mauroleme/radiation-pattern-measurement-system/docs/README.md

# Documents

| Folder | Contents |
|---|---|
| [`report/LEEC_project_report_Mauro_Leme.pdf`](report/LEEC_project_report_Mauro_Leme.pdf) | **Final LEEC project report (PDF, 105 pages)** |
| [`report/latex`](report/latex) | LaTeX source of the report (English, IPB template `ipb.cls`). Main file `relatorio.tex`, chapters in `chapters/`, the code listed in the appendices in `codes/`, every figure in `Imagens/`. Build: `pdflatex relatorio && bibtex relatorio && pdflatex relatorio && pdflatex relatorio`, or upload the folder to Overleaf |
| [`proposal`](proposal) | Original project proposal |
| [`papers/sasyr-2025`](papers/sasyr-2025) | Short paper *"Development of a 2-DoF Antenna Radiation Measurement System"* (Springer LLNCS LaTeX source + PDF) and the conference poster |
| [`papers/teem-2025`](papers/teem-2025) | Full paper *"Two-Axis Computerised Antenna Radiation Pattern Measurement System"* (revised version) |
| [`presentation`](presentation) | Slides of the project defence (18/09/2025, Portuguese) |

Report structure: 1 Introduction · 2 State of the art (commercial systems: MegiQ RMS-0460, Diamond D6050, MWF, S7601A) · 3 Materials and methods (mechanics, electronics, software, Yagi-Uda design, balun and matching network) · 4 Results (component characterisation, pattern measured in four configurations, 3D) · 5 Conclusions and future work · Appendices A-E (MATLAB, Arduino and `Joint` class code, balun script).
