mauroleme/radiation-pattern-measurement-system/media/README.md

# Photos and videos

- [`photos`](photos): the platform (front/back/side views, top and bottom sections, the electronics in the base), the Yagi-Uda prototype, the matching PCB and the outdoor measurement set-up (August 2025). `.heic` files are original phone photos.
- [`videos`](videos), stored with **Git LFS** (click a file and then *View raw* / *Download*):
  - `Record_2025_05_29_17_27_11_112.mp4`: the system running a measurement (29/05/2025)
  - `video_20250414_172635.mp4`: test from 14/04/2025
  - `motor_test.mp4`, `motor_test_2.mp4`: early stepper motor tests
