mauroleme/radiation-pattern-measurement-system/docs/report/latex/acronym.tex

\newacronym{API}{API}{Application Programming Interface}
\newacronym{TI}{TI}{Tecnologias da Informação}
\newacronym{ESTiG}{ESTiG}{Escola Superior de Tecnologia e Gestão}
\newacronym{EMS}{EMS}{Electromagnetic Simulation}
\newacronym{ISM}{ISM}{Industrial, Scientific and Medical}
\newacronym{DC}{DC}{Direct Current}
\newacronym{AC}{AC}{Alternating Current}
\newacronym{RF}{RF}{Radio Frequency}
\newacronym{VNA}{VNA}{Vector Network Analyzer}
\newacronym{RSSI}{RSSI}{Received Signal Strength Indicator}
\newacronym{GNU}{GNU}{GNU's Not Unix}
\newacronym{SDR}{SDR}{Software Defined Radio}
\newacronym{PVC}{PVC}{Polyvinyl Chloride}
\newacronym{CAD}{CAD}{Computer-Aided Design}
\newacronym{IEEE}{IEEE}{Institute of Electrical and Electronics Engineers}
\newacronym{PLA}{PLA}{Polylactic Acid}
\newacronym{DIP}{DIP}{Dual In-line Package}
\newacronym{IO}{I/O}{Input/Output}
\newacronym{I2C}{I2C}{Inter-Integrated Circuit}
\newacronym{DUT}{DUT}{Device Under Test}
\newacronym{UART}{UART}{Universal Asynchronous Receiver-Transmitter}
\newacronym{IDE}{IDE}{Integrated Development Environment}
\newacronym{FDM}{FDM}{Fused Deposition Modelling}
\newacronym{BALUN}{BALUN}{Balanced-Unbalanced Transformer}
\newacronym{PCB}{PCB}{Printed Circuit Board}
\newacronym{CNC}{CNC}{Computer Numerical Control}
\newacronym{SAW}{SAW}{Surface Acoustic Wave}
\newacronym{EIRP}{EIRP}{Effective Isotropic Radiated Power}
\newacronym{VSWR}{VSWR}{Voltage Standing Wave Ratio}
