mauroleme/radiation-pattern-measurement-system/docs/report/latex/chapters/apendice02.tex

\chapter{Main Control System Code
(Arduino)}
\label{apendice2}

This appendix presents the source code developed for the main control of the system
using the Arduino Uno. The full source code for this project is available at:\\ https://github.com/mauroleme/radiation-pattern-measurement

\lstinputlisting[language=Arduino, caption={Arduino main control}, label={lst:ino_main}]{codes/main.ino}
