mauroleme/radiation-pattern-measurement-system/docs/report/latex/chapters/apendice03.tex

\chapter{Joint Class Header File (C++)}
\label{apendice3}

This appendix presents the header file developed for the implementation of the
\texttt{Joint} class used in the Arduino-based control system. The full source code for this project is available at: https://github.com/mauroleme/radiation-pattern-measurement

\lstinputlisting[language=cpp,
                 caption={Joint class header file},
                 label={lst:joint_h}]
{codes/joint2.cpp}
