mauroleme/radiation-pattern-measurement-system/docs/report/latex/chapters/apendice04.tex

\chapter{Joint Class Implementation File (C++)}
\label{apendice4}

This appendix presents the implementation file developed for the
\texttt{Joint} class used in the Arduino-based control system. The full source code for this project is available at:\\ https://github.com/mauroleme/radiation-pattern-measurement

\lstinputlisting[language=cpp,
                 caption={Joint class implementation file},
                 label={lst:joint_cpp}]
{codes/joint1.cpp}
