mauroleme/radiation-pattern-measurement-system/docs/report/LEEC_project_report_Mauro_Leme.pdf

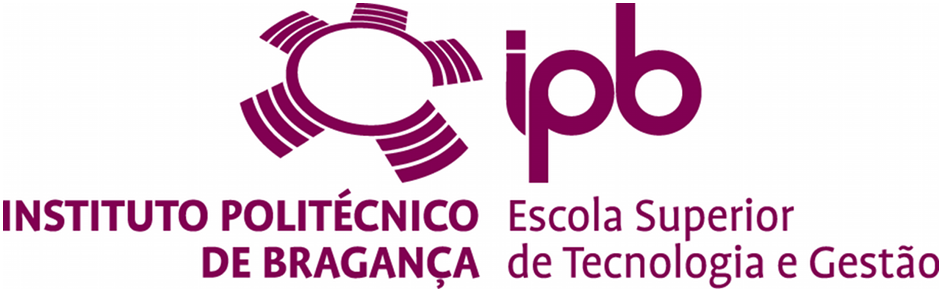
[picture p49: figure]

# Two-Axis Computerised Antenna Radiation Pattern Measurement System

Mauro da Silva Leme - 52965

Trabalho realizado sob a orientação de

Professor Doutor João Paulo Coelho

Licenciatura em Engenharia Eletrotécnica e de Computadores

2024-2025

# Two-Axis Computerised Antenna Radiation Pattern Measurement System

Relatório da UC de Projeto

Licenciatura em Engenharia Eletrotécnica e de Computadores

Escola Superior de Tecnologia e Gestão

Mauro da Silva Leme - 52965

2024-2025

A Escola Superior de Tecnologia e de Gestão não se responsabiliza pelas opiniões

expressas neste relatório.

Declaro que o trabalho descrito neste relatório é da minha autoria e é

da minha vontade que o mesmo seja submetido a avaliação.

Mauro da Silva Leme - 52965

# Dedication

I dedicate this work to my grandmother Benedita, who gave up her life for me and who,

wherever she may be, I know is happy with this moment.

vii

# Acknowledgement

The completion of this work would not have been possible without the contribution and

support of many people and institutions that, in different ways, have marked this stage

of my academic life.

Firstly, I would like to express my deepest gratitude to my supervisor and creator

of this project, Professor João Paulo Coelho, PhD, for his scientific guidance, constant

patience, sharing of knowledge, and dedication, which was reflected not only in the de-

velopment of this work, but also in my personal and professional growth.

I would also like to express my gratitude to João Alexandre Batista Coelho, MSc,

Laiany Suganuma Brancalião, MSc, and Mariano Alvarez, MSc, for their close support

during the different stages of the work, for their constructive suggestions and for their

contributions, not only technical but also personal, being present on various fronts of the

project and offering friendship, encouragement and continuous collaboration.

I would also like to thank Professor José Alexandre de Carvalho Gonçalves, PhD, for

his availability and for facilitating access to the IPB laboratories, often outside normal

working hours, as well as for his advice, which greatly enriched this journey.

To CeDRI and ESTIG, for their institutional support and provision of essential re-

sources, and to MORE CoLAB, in the person of Higor Rosse, for his collaboration in the

production of the PCBs.

To my classmates and colleagues from other IPB courses, for their encouragement

and support, and to the management of the Electrical and Computer Engineering de-

gree programme, for their dedication, guidance, and motivation conveyed throughout my

studies.

viii

Last but not least, I would like to express my heartfelt gratitude to my mother, my

brothers and sisters, and my friends for their unconditional encouragement, patience, and

understanding, which were indispensable in helping me achieve this goal. I would also

like to give special thanks to Thiago and Dayana, who have been a fundamental pillar

in my life over the years, offering constant support and true friendship. A deep and

loving thank you to Mary, my adoptive mother, who always believed in me, even when I

doubted myself, always encouraging me not only in my studies, but also in becoming a

better person. If I am who I am today, I owe it in large part to her unwavering confidence

and the support she never failed to give me.

ix

# Resumo

Compreender o padrão de radiação das antenas é essencial para otimizar os sistemas de

comunicação sem fios. Esse parâmetro descreve como a antena irradia ou recebe energia

eletromagnética no espaço, tais como a área de cobertura, a intensidade do sinal e as

interferências. Conhecer o padrão de radiação permite posicionar e orientar melhor as

antenas, minimiza as perdas de energia e melhora o desempenho geral do sistema.

Embora os softwares de simulação eletromagnética (EMS) possam estimar o padrão de

radiação durante a fase de projeto, os resultados práticos muitas vezes diferem das simu-

lações devido a influências ambientais. Reflexões, difrações e absorções podem distorcer

significativamente o que é idealizado. Como resultado, compreender o padrão de radiação

real é crucial para garantir um desempenho confiável em aplicações práticas.

No entanto, os equipamentos de medição de antenas comerciais são normalmente muito

caros, o que os torna impraticáveis para laboratórios educacionais. Neste contexto, este

trabalho propõe o desenvolvimento de uma configuração experimental de baixo custo para

medir padrões de radiação de antenas na banda Industrial, Científica e Médica (ISM). O

sistema permite o posicionamento automático de uma antena de prova segundo dois eixos,

habiltando a medição de padrão coplanar e cruzada assim como azimute e/ou elevação.

O controlo dos dois graus de liberdade, assim como a aquisição e visulização dos dados,

é realizado por um programa desenhado para correr no software MATLAB. A validação

experimental, com uma antena Yagi-Uda, mostrou boa concordância entre os resultados

medidos e simulados. Os resultados validam a operação do sistema desenvolvido.

Palavras-chave: Padrão de Radiação de Antenas, Radiação Eletromagnética, Meca-

trónica, Medição de Baixo Custo, Desempenho de Antenas.

x

# Abstract

Understanding the radiation pattern of antennas is essential for optimising wireless com-

munication systems. This parameter describes how an antenna radiates or receives electro-

magnetic energy in space, determining key aspects such as coverage area, signal strength,

and susceptibility to interference. Knowledge of the radiation pattern allows better place-

ment and orientation of antennas, minimises energy losses, and improves overall system

performance.

Although electromagnetic simulation (EMS) software can estimate the radiation pattern

during the design phase, practical results often differ from simulations due to environ-

mental influences. Reflections, diffractions, and absorptions can significantly distort the

idealised pattern. As a result, understanding the real radiation pattern is crucial to ensure

reliable performance in practical applications.

However, high-precision antenna measurement equipment is usually very expensive, which

makes it impractical for educational laboratories. In this context, this work proposes the

development of a low-cost experimental setup for measuring antenna radiation patterns

in the Industrial, Scientific, and Medical (ISM) band. The system integrates a two-axis

positioning mechanism, an Arduino-based control platform, a radio frequency power de-

tector, and a MATLAB interface for data acquisition and visualisation.

Experimental validation using a Yagi–Uda antenna showed good agreement between mea-

sured and simulated results. These outcomes indicate the viability of the developed setup.

Keywords: Antenna Radiation Pattern, Wireless Communication, ISM Band, Low-Cost

Measurement, Antenna Performance.

xi

xii

# Contents

1 Introduction | 1
2 State of the Art | 5
3 Materials and Methods | 15

xiii

4 Results | 41
4.4.4 | Antenna with Band-Pass Filter, Balun, and Impedance Matching
5 Conclusion and Future Work | 58

xiv

A Data Processing Script in MATLAB | A1
B Main Control System Code (Arduino) | B1
C Joint Class Header File (C++) | C1
D Joint Class Implementation File (C++) | D1
E MATLAB Code for Balun Calculation | E1

xv

# List of Tables

2.1 Comparison of Commercial Antenna Measurement Systems | 10
3.1 Element lengths and spacings for the Yagi-Uda antenna | 27
3.2 Final LC matching network component values | 38
3.3 Estimated cost of components used in the project | 40

xvi

# List of Figures

1.1 Overview of the complete antenna radiation pattern measurement system. | 2
2.1 MegiQ RMS-0460 Measurement System | | 7
2.2 D6050 Measurement System | | 8
2.3 Microwave Factory (MWF) Measurement System representation | | 9
2.4 S7601A Antenna Measurement System | 10

3.1 CAD model of the rotating platform with two degrees of freedom. Axis

“A” corresponds to the azimuth rotation and axis “B” to the perpendicular

rotation, which can be configured as the elevation axis | 16

3.2 Block diagram and photo of the electrical system, including key components

like the Arduino Uno, DRV8825 driver shield, power supply, sensors, RF

detector (AD8313), Device Under Test (DUT), stepper motors, and internal

wiring | 19

3.3 Detailed electrical schematic of the measurement system, illustrating com-

ponent interconnections and pin assignments | 21

3.4 Schematic showing the flow of the signal from generation to analysis. . . . 23

3.5 Yagi-Uda antenna simulated in CST Studio Suite | 27

3.6 Mechanical model of the antenna developed in SolidWorks and the con-

structed Yagi-Uda antenna prototype | 28
3.7 Characterisation of the antenna using the NanoVNA | 29
3.8 Characterisation of the air choke balun | 31

xvii

3.9 Photos of the air choke balun manufactured using RG174 cable, with 3D

printed support | 32
3.10 Measured S21 curve of the bare PCB with NanoVNA Saver | 33
3.11 CST Studio Suite simulation of the PCB | 33
3.12 QucsStudio simulation of the PCB: (a) model and (b) result | 34
3.13 Measured S-parameters of the PCB using NanoVNAsaver | 36
3.14 Validation of the Touchstone file in QucsStudio | 37
3.15 before impedance matching network | 37
3.16 Results of the optimised matching network | 38

3.17 PCB layout model in QucsStudio , design in EasyEDA, and photograph of

the manufactured | 39

4.1 Experimental setup for transmitting and receiving antennas, showing rear

and side perspectives | 43

4.2 S21 of the 868 MHz band-pass filter showing insertion loss and passband

characteristics | 45

4.3 Experimental S21 results for the air choke balun using VNA in differential

and common modes | 46
4.4 S11 graph and VSWR of the PCB used for impedance matching | 47
4.5 Comparison of real and simulated radiation pattern | 50

4.6 Comparison of real and simulated radiation pattern. Antenna with band-

pass filter | 51

4.7 Comparison of real and simulated radiation pattern. Antenna with band-

pass filter and balun | 52
4.8 Measured data with filter, balun and impedance matching | 53
4.9 Simulated radiation pattern outcome from CST Studio Suite | 54
4.10 Measured 3D radiation pattern | 55
4.11 Simulated 3D radiation pattern from CST Studio Suite | 55

xviii

# Chapter 1

# Introduction

## 1.1 Work Description

Over the past few decades, the fast development of wireless communication technologies

has reinforced the importance of antennas as fundamental components of transmission

and reception systems. A key parameter in antenna characterisation is the radiation

pattern, which reveals how electromagnetic energy is distributed in space. Understanding

and measuring this pattern is essential for evaluating antenna performance, optimising

coverage, and ensuring efficient energy transfer.

Existing commercial setups offer high accuracy, but are financially impractical for

educational laboratories. For undergraduate environments, where the primary objective

is to support teaching and provide hands-on experience, the investment in such equipment

is frequently unjustifiable. In this context, the development of low-cost and custom-

made solutions becomes relevant, enabling students to gain practical insights into antenna

behaviour without requiring highly specialised or costly instrumentation.

This project addresses this need by developing a two-axis mechatronic and comput-

erised system for antenna radiation pattern measurement. The system operates in the

ISM band (below 1 GHz), specifically around 868 MHz, and combines mechanical design, custom electronics, and software integration. It includes stepper motors for antenna posi-

tioning, an Arduino-based control platform, a Radio Frequency (RF) power detector, and

MATLAB¹
for data acquisition and visualisation. An overview of the complete system

is illustrated in Figure 1.1. To ensure signal integrity and accurate power transfer, the

setup also incorporates an impedance matching network and a balun for common-mode

current suppression. The system was validated by comparing experimental results with

simulations of a Yagi–Uda antenna, serving as a proof of concept for its applicability in

laboratory environments.

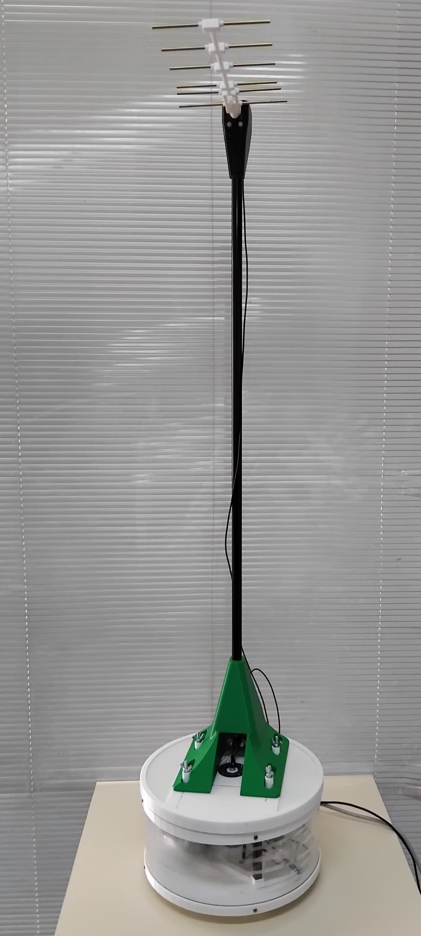
[picture p50: figure]

(a) Front view | (b) Side view | (c) Back view

Figure 1.1: Overview of the complete antenna radiation pattern measurement system.

## 1.2 Objectives

The main objective of this work is to design and implement a low-cost computerised system

for measuring antenna radiation patterns, suitable for educational and experimental use.

1A campus version of this software is licensed to the Polytechnic Institute of Bragança.

This primary goal emphasises the development of a system that is accessible, reliable, and

capable of providing meaningful practical experience in an academic context.

In addition to this, the project also addresses secondary objectives that contribute to

the overall functionality and validation of the system. These include the construction of

two Yagi–Uda antennas, to transmit and receive signals, the development of a two-axis ro-

tating platform with angular control for antenna positioning, the integration of electronic

subsystems for motor control, RF power detection, and data acquisition. Collectively,

these secondary objectives support the achievement of the primary goal while ensuring

the usability of the system and its educational usefulness.

## 1.3 Document Structure

The document is organised into five main chapters, each addressing a specific aspect of

the work:

- Chapter 2 – State of the Art: Reviews existing commercial antenna measure-

ment systems and related research initiatives, emphasising the need for accessible,

low-cost alternatives and setting the context for the proposed system.

- Chapter 3 – Materials and Methods: Describes the proposed system in detail,

including its mechanical design, electronic subsystems, software development, and

validation strategy. The chapter also covers the design and characterisation of the

Yagi–Uda antenna, as well as the implementation of impedance matching and balun

circuits.

- Chapter 4 – Results: Presents the experimental outcomes obtained from the char-

acterisation of individual system components and the complete measurement setup,

and compares them with simulated data to evaluate accuracy and repeatability.

- Chapter 5 – Conclusions and Future Work: Summarises the main findings,

discusses limitations, and suggests ideas for future improvements.

## 1.4 Scientific Publications

The work developed in this project has also contributed to scientific publication. Two

articles have already been produced: one presented at the 5th Symposium of Applied

Science for Young Researchers (SASYR), and another accepted for presentation at the

13th Technological Ecosystems for Enhancing Multiculturality (TEEM) conference, the

latter being an indexed venue, which reinforces the scientific relevance of the results.

In addition, the outcomes obtained from the design and validation of the Yagi–Uda

antenna provide material for a potential third article, which may be developed in future

work.

# Chapter 2

# State of the Art

## 2.1 Introduction

Over the last few decades, technology has advanced rapidly, especially in telecommuni-

cations. Antennas have a crucial role in this context as they are key elements in the

communication chain, upon which the overall performance of the system strongly de-

pends. Since World War I, the design and development of antennas has been a topic

of great relevance, initially driven by military applications. Over time, this importance

has increased with the introduction of new technologies, such as television, and continues

to grow in the current era of mobile communications, including 5G and high-frequency

Wi-Fi. The need to characterize and evaluate an antenna’s performance has become even

more crucial to ensure the efficiency and reliability of communication systems.

To ensure that antennas operate within expected parameters, it is essential to use mea-

surement and calibration systems. These systems allow the evaluation of various antenna

characteristics, including radiation pattern, gain, efficiency, and bandwidth. Measuring

and validating antenna performance is vital to make sure they meet technical and regu-

latory specifications.

Radiation pattern measurement is a key step in the design process of antennas and

wireless devices. The results of these measurements are used to validate simulated designs and identify potential performance issues before final testing.

While commercially available antenna measurement systems are designed to provide

precise and repeatable measurements, they are often expensive. Therefore, custom-made

solution are the way when budget is a constraint. These custom-made solutions offer a

cost-effective alternative, while addressing specific needs that commercial systems may

not cover.

In this chapter, some available commercial solutions for antenna radiation patterns

measurement will be first presented. Then, a review is made regarding research and

development works that aim to develop similar devices. The goal is to provide a theoretical

and practical basis that supports the decision to develop an cost-effective and accurate

solution, aligning with the objectives of this project.

## 2.2 Commercially Available Products

This section presents commercially available solutions for measuring antenna radiation

patterns. These solutions are used in research and development laboratories as well as in

companies that need to validate antenna performance across different frequencies. The

following descriptions provide a detailed overview of the main features and the purpose

for which each system is most suitable. It should be noted that the list presented is not

exhaustive and only includes companies that were contacted as part of this study.

### 2.2.1 MegiQ RMS-0460

According to the supplier, the MegiQ RMS-0460 system, manufactured in the Nether-

lands, is designed to perform antenna radiation pattern measurements in environments

such as laboratories or offices, without requiring an anechoic chamber, as shown in Figure

2.1. It operates over a frequency range of 370 MHz to 6 GHz and supports measurements

along three axes. The system offers a measurement accuracy of ±1 dB and repeatability

of ±0.5 dB. Depending on the configuration, the system can handle loads up to 30 kg.

The approximate price is e 16,950.


Figure 2.1: MegiQ RMS-0460 Measurement System.

Source: MegiQ, 2024.

### 2.2.2 D6050 Diamond Engineering

The D6050, produced by Diamond Engineering in the United States, is designed to per-

form measurements over a frequency range up to 67 GHz, and up to 110 GHz when using

waveguides. It offers an angular precision of 0.02◦ and supports loads up to 11.5 kg. The

system, depicted in Figure 2.2, features a modular configuration that allows the addition

of linear axes for automated measurement. Additionally, it includes software for control

and data analysis. The starting price is e 12,880.

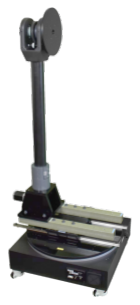
[picture p51: figure]

Figure 2.2: D6050 Measurement System.

Source: Diamond Engineering, 2024.

### 2.2.3 Microwave Factory Co., Ltd. (MWF)

Microwave Factory Co. Ltd., from Japan, offers an option for measuring antenna ra-

diation patterns, operating in a range from 0.4 GHz up to 300 GHz, depending on the

configuration. As shown in Figure 2.3, the system includes an antenna tower, azimuth

positioner, elevator, RF absorbers, and control software (MATEOS.NET), enabling 2D

radiation pattern measurements and antenna gain analysis. The system is customizable

to accommodate equipment with varying weights, with a capacity of up to 1000 kg, which

allows it to be used for large-scale projects in controlled environments. It offers an an-

gular precision of 0.03◦ and repeatability of ±0.03◦
. However, it requires an anechoic

chamber to ensure measurement accuracy. The total price for the complete system is

approximately e 368,000.

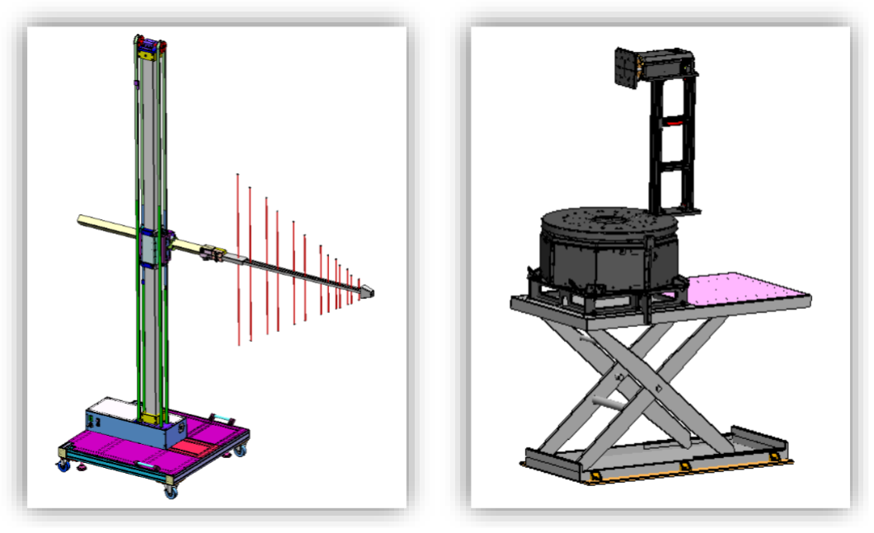
[picture p52: figure]

Figure 2.3: Microwave Factory (MWF) Measurement System representation.

Source: Microwave Factory Co. Ltd., 2024.

### 2.2.4 S7601A Antenna Measurement System

The S7601A Antenna Measurement System, developed by Keysight Technologies, a United

States company, is also a product for antenna characterization. It operates within a

frequency beginning from 10 MHz to 50 GHz and allows for both near-field and far-

field measurements. This system supports 2-axis positioning and can handle antennas

weighing up to 10 kg. According to the manufacture, it enable measurement accuracy

up to ±0.8 dB, delivering results for various antenna systems, including 5G, satellite,

and radar applications. The system includes an integrated anechoic chamber, which, for

reference, the price of the S7601A anechoic chamber alone is approximately e 856,000.

Additional measurement devices are offered by the same company and can be acquired

based on the specific needs of the user. The system is illustrated in Figure 2.4.


Figure 2.4: S7601A Antenna Measurement System.

Source: Keysight Technologies, 2024.

As referred in the beginning of this section, contact was made via email with the com-

panies that manufacture these systems. Despite this, some specific information regarding

certain features, such as signal accuracy or load capacity, was either not provided or is

not applicable due to possible configurations of the system. This explains the gaps in the

comparison provided in Table 2.1 where data is unavailable or subject to change based

on client requirements.

Table 2.1: Comparison of Commercial Antenna Measurement Systems

Feature | MegiQ RMS-0460 | D6050 Diamond Eng. | Microwave Factory | S7601A
Frequency Range | 370 MHz – 6 GHz | Up to 67 GHz (110 GHz) | 0.4 GHz – 6 GHz | 10 MHz – 50 GHz
Measurement Axes | 3-axis | 2-axis | 2-axis | 2-axis
Signal Accuracy (dB) | ±1 dB | Not Specified | Not Specified | ±0.8 dB
Angular Precision (◦) | Not specified | 0.02◦ | 0.03◦ | Customizable
Load Capacity | Up to 30 kg | 11.5 kg | Up to 1000 kg | 10 kg
Environment | No chamber required | No chamber required | Needs chamber | Chamber included
Price | e 16,950 | e 12,880 | e 368,000 | e 856,000 (Chamber only)

In conclusion:

- The MegiQ RMS-0460 system is designed for smaller to medium-sized antennas,

with a load capacity of up to 30 kg, depending on the configuration. It operates

without requiring an anechoic chamber, making it applicable for environments like

laboratories or educational settings, where portability and ease of setup are neces-

sary.

- The D6050 Diamond Engineering system provides an angular precision of 0.02◦ ,

suitable for applications that require accurate positioning of antennas. It operates

within a frequency range up to 110 GHz when using waveguides, and supports

high-frequency measurements for medium-sized antennas.

- The Microwave Factory Co., Ltd. system has the highest load capacity among

the compared systems, supporting up to 1000 kg. This makes it the choice for

large-scale projects, such as those involving heavy or large antennas. It also pro-

vides a frequency range up to 300 GHz, making it suitable for advanced applica-

tions in aerospace or defence industries where high precision and anechoic chamber-

controlled environments are critical.

- The S7601A Antenna Measurement System has a load capacity of up to 10 kg and

operates within a frequency range of 10 MHz to 50 GHz. It includes an integrated

anechoic chamber, allowing measurements without the need for a separate chamber,

making it applicable for industries such as telecommunications and satellite testing.

The baseline is that any of the solution, even the most cost-effective, is way outside

the grasp of many educational institutions. For this reason, do-it-yourself (DIY) solutions

provide the most practical approach. In this reference frame, the following section will

be devoted to explore academic published researches that describe the development of

custom-made antenna radiation pattern measurement rigs.

## 2.3 Research and Development Work

Based on the characteristics of the commercial equipment discussed above, it is possible

to conclude that, even if they are highly effective and precise, they can also be quite

expensive. For many individuals, organizations, and companies, the high costs of these

systems may not be justifiable, especially when financial resources are limited.

As a result, custom-made solutions emerge as an alternative. These solutions al-

low for the construction of customized measurement systems that can focus on specific

antenna characteristics without the need to acquire complete and expensive commercial

systems. Additionally, these solutions can be adapted to include functionalities not cov-

ered by commercial systems, providing greater flexibility and cost savings.

Research Methodology: The literature review was conducted using two major aca-

demic databases: Google Scholar and IEEE Xplore (Institute of Electrical and Electronics

Engineers Xplore). The search aimed to identify existing commercial antenna measure-

ment systems, as well as academic and open-source solutions focusing on low-cost and

customisable alternatives. A set of keyword combinations was used to ensure a compre-

hensive search, including: “antenna measurement”, “antenna measurement system”, “ra-

diation pattern”, “automated antenna measurement”, “low-cost antenna measurement”,

“open-source antenna measurement”, “SDR antenna measurement”, “Arduino antenna

system”, and “3D-printed antenna measurement”. Boolean operators such as AND were

used to refine the queries (e.g., “antenna measurement” AND “radiation pattern”; “open-

source antenna” AND “antenna measurement system”).

Picco and Martin (2011) developed “An Automated Antenna Measurement System

Utilizing Wi-Fi Hardware”. On their work a device was built using commercial Wi-Fi hard-

ware[1]. In particular, specifically modified Linksys brand? routers, to measure RF signals

at 2.4 GHz. By replacing the original firmware with open-source DD-WRT firmware, they

enabled the routers to function as cost-effective tools for measuring the received signal

strength indicator (RSSI). Additionally, the system integrates with LabVIEW software

to automate the positioning of the antenna under test using stepper motors. Although the system operates in a non-anechoic environment, the published results suggest that

inaccuracies are kept controlled while providing a viable low-cost solution for educational

and research settings.

In Junfithrana et al. (2017), “Development of Automated Antenna Radiation Pat-

tern Measurement Using Rotator Application Model to Increase Accuracy”, the authors

proposed an automated system that uses a two-axis rotator model controlled by microcon-

trollers[2]. This setup is integrated with a vector network analyzer and the control software

was developed in LabVIEW. The work highlights how the use of accessible components

can increase measurement accuracy, making the system a practical and economical alter-

native to commercial solutions.

Simanjuntak et al. (2019), presents the “Preliminary Design of Automatic An-

tenna Radiation Pattern Measurement System for Antenna and Propagation Laboratory

Course”, in which the authors develop an automated radiation pattern measurement sys-

tem using microcontrollers[3]. This study demonstrates that an accessible and portable

system can be implemented to be used in educational environments, providing quick and

accurate measurements without the need for expensive commercial equipment.

All the above papers exemplify how custom solutions can be adapted to meet specific

needs, offering an efficient alternative to commercial systems. They offer a solid foundation

for developing new approaches that combine cost-effectiveness, flexibility, and innovation,

which is aligned with the goal of this project.

Within the maker community, open-source solutions have gained prominence in the

field of antenna measurement due to their flexibility, cost-effectiveness, and adaptability

to different research and educational contexts. Examples of such approaches include the

work developed by Weber State University, which proposed an antenna pattern measure-

ment system using open-source components, such as Software-Defined Radios (SDRs),

Arduino microcontrollers, and GNU Radio software. These studies present the continu-

ous evolution and improvement of accessible and highly effective antenna measurement

systems.

Also, in “Open-Source Antenna Pattern Measurement Validation Using FEKO” (2020)

an antenna pattern measurement system developed using SDRs and 3D-printed hard-

ware, is presented[4]. The system validation was conducted by comparing experimen-

tal measurements of antenna radiation patterns with theoretical simulations generated

by the FEKO simulation software. The results demonstrated that the low-cost system

could replicate measurements with a high degree of accuracy, making it an ideal tool for

undergraduate-level investigations on antenna theory and practical measurements.

In the same year, “Open-Source Antenna Pattern Measurement System” (2020) presents

the development of a measurement system by replacing Wi-Fi routers with SDRs to ex-

pand the frequency range (30 MHz to 6 GHz) over which measurements can be per-

formed[5]. This enhanced version of the system addresses challenges related to position

control and measurement accuracy, using stepper motors controlled by an Arduino with

open-source GRBL firmware. The study highlights how the replacement of components

and the integration of new control and signal processing methods helped improve the

system’s precision and versatility while keeping it accessible and suitable for educational

environments.

Finally, the most recent work among the studies reviewed, "Open-Source Antenna Pat-

tern Measurement System: SDR-based Student Research and Development" (2022)[6],

presents the latest updates to the system, including significant hardware and software

improvements. Hardware upgrades include replacing Polyvinyl Chloride (PVC) compo-

nents with Computer-Aided Design (CAD)-modelled and 3D-printed parts, increasing the

system’s mobility and adaptability for use in multiple noisy environments. The software

was enhanced with new versions of Python, GNU Radio, and Linux, and advanced noise

mitigation techniques and modulation control were incorporated to further improve mea-

surement accuracy. The article highlights the system’s success as a robust and flexible

educational tool, creating opportunities for collaborative research and project develop-

ment among electrical engineering students.

# Chapter 3

# Materials and Methods

Following the review of commercial systems and research initiatives discussed previously,

this chapter presents the practical implementation of a low-cost antenna radiation pattern

measurement system. Designed to meet educational and experimental needs around the

868 MHz ISM band, the proposed setup combines mechanical design, custom electronics,

and software integration. This chapter describes the materials used, the configuration of

each subsystem, and the validation methodology. Additionally, it highlights RF-related

improvements, including a custom-designed air-core choke balun and an impedance match-

ing network.

## 3.1 Proposed System Description

The antenna radiation pattern measurement system was developed with an emphasis

on low cost, modularity, and suitability for educational and experimental applications.

Built using commercially available components and custom-fabricated parts, the system

allows for easy replication and future enhancements. It is composed of the following main

subsystems:

- Mechanical substructure with two independent rotational axes (azimuth and

perpendicular) for the receiving antenna.

- Electronic control system based on the ATmega328P microcontroller (Arduino

Uno).

- RF power measurement circuit using the AD8313 logarithmic detector.
- MATLAB software suite for motor control, data acquisition, and real-time vi-

sualization.

### 3.1.1 System Architecture

The system includes two rotational axes: the azimuth axis, located at the base, and a

perpendicular axis at the top, which enables angular scanning in an orthogonal plane.

Depending on the antenna mounting orientation, this perpendicular axis can be adapted

to perform elevation, as shown in Figure 3.1. Both axes are actuated by NEMA 17 stepper

motors with 1.8

◦
step angle, driving belt-and-pulley mechanisms. To prevent twisting of

the coaxial cable and transmission wires, the motor moves up to 180◦ in one direction,

returns to the home position, and then moves up to 180◦
in the opposite direction.

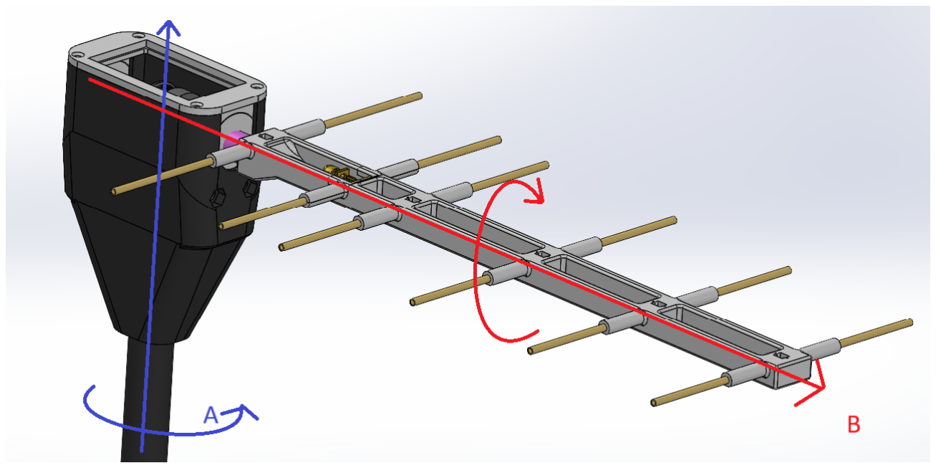
[picture p53: figure]

Figure 3.1: CAD model of the rotating platform with two degrees of freedom. Axis “A” corresponds to the azimuth rotation and axis “B” to the perpendicular rotation, which can be configured as the elevation axis.

The mechanical transmission system, based on belts and polies, was specifically de-

signed to achieve a resolution of approximately 1

- of revolution per motor step. This

was achieved by using custom-designed gears with a 1.8:1 ratio. The rotating assembly

is supported by low-friction components to ensure smooth motion and reproducibility of

measurements.

It is worth noting that despite the mobile platform responsible for rotating the antenna

under test, the complete system also includes a fixed structure that acts as a transmit-

ting station. This fixed base has dimensions and construction characteristics similar to

the rotational platform, such as mounting height and accommodation of the transmitting

antenna. Even without motorised degrees of freedom, the antenna installed on this base

can be manually oriented on different axes, allowing for various configurations, such as

azimuth or orthogonal alignment, according to the desired experiment. Thus, the assem-

bly consists of two complementary mechanisms, assisting in the measurement of radiation

patterns in different scenarios.

### 3.1.2 Components Used

The main components used in the construction of the system are:

- Stepper Motors: NEMA 17 bipolar stepper motors with 1.8
- per step, configured

for 1/16 microstepping using DRV8825 drivers. These motors were selected over

commun low-cost servo motors due to their superior precision and high torque,

which are crucial for achieving accurate angular positioning required for antenna

pattern measurements.

- Microcontroller: Arduino Uno board, based on the ATmega328P, is responsible

for coordinating motor motion, executing homing routines, and reading sensor data.

The Arduino Uno was chosen for its ease of programming, widespread community

support, and cost-effectiveness, making it an ideal platform for an educational and

experimental system.

- RF Power Sensor: Analog Devices AD8313 module, operating from 100 MHz

to 2.5 GHz range, with a dynamic range of up to 70 dB. This sensor was selected

because it can be supplied inexpensively from the Asian market.

- Magnetic Position Sensors: Hall-effect magnetic sensors (KY-035 49E), used for

homing reference detection on each rotational axis. These sensors provide a reliable

and low-cost solution for precise homing, ensuring consistent starting positions.

- Power Supply: Industrial 12 V DC, 2 A power supply (Orno OR-ZL-1631), rated

at 24 W with IP20 protection and 230 V Alternating Current (AC) input, providing

regulated voltage to all system components. A standard power supply was chosen

for its reliability and capability to provide stable and sufficient power to all active

components of the system.

- Mechanical Structure: The platform consists of a one-meter fibreglass tube (non-

conductive and lightweight), 3D-printed pulleys and brackets, and a wooden base in

circular shape. Non-metallic materials were deliberately selected near the antenna

to avoid reflections or distortions by the radiation pattern. Even the internal bear-

ings are from nylon materials. Some components of the mechanical structure, such

as the wooden base, were sourced in a manner that did not significantly impact

the final cost of the project, further aligning with the low-cost objective. Fibreglass

and Polylactic Acid (PLA) were chosen for their non-conductive, lightweight prop-

erties, minimizing interference and ensuring the structural integrity of the rotating

assembly without affecting RF measurements.

- RF Generator: It is a handheld RF signal generator which is used as a signal

source. It operates in a frequency range from 100 kHz up to 6 GHz, offering both

CW (Continuous Wave) and sweep modes, with output power from approximately

–60 dBm to +15 dBm. Detailed characterisation of both the signal generator and

the antenna systems in transmitter and receiver configurations will be present later.

## 3.2 Electrical Subsystem

As illustrated in the block diagram in Figure 3.2a, the electrical control system is based on

an Arduino Uno board (ATmega328P), combined with a dual stepper motor driver shield.

This shield integrates two DRV8825 drivers, each configured for 1/16 microstepping via

onboard Dual In-line Package (DIP) switches. It simplifies the electrical connections and

consolidates the power and control interfaces for the stepper motors.


(a) Block diagram of the electrical system | (b) Assembled base of the measurement sys-
| tem
Figure 3.2: Block diagram and photo of the electrical system, including key components like the Arduino Uno, DRV8825 driver shield, power supply, sensors, RF detector (AD8313), Device Under Test (DUT), stepper motors, and internal wiring.

The H-bridge shield receives 12 V from the external power supply, which is then

distributes power to the stepper motors and Arduino board. It also powers auxiliary

components, such as the Hall-effect sensors and the RF power detector module. The

AD8313 module, crucial for the measurement process, converts the incoming RF signal

(from 0.1 to 2.5 GHz, with an input impedance of 50 Ω) into a DC voltage output, typically

ranging from 0.5 V to 1.65 V. Its detection slope is approximately 18 mV/dBm, allowing

the conversion of RF power to a measurable voltage signal for the microcontroller. The

onboard voltage regulation supports both 5 V and 12 V levels as required by each module.

Each of the two rotational axes includes a Hall-effect sensor positioned to detect a

small magnet mounted on the corresponding gear. These sensors are used to perform

an automated homing procedure during system initialisation. A dedicated routine imple-

mented in the firmware enables the system to identify the reference position (zero-degree

point) of both axes. This ensures reliable absolute positioning throughout the measure-

ment process, compensating for the lack of closed-loop feedback in typical stepper motor

systems.

The wiring of the system is organised and modular, as illustrated by the assembled

base in Figure 3.2b, and is facilitated by screwless terminals in the shield and the clear

allocation of digital I/O (Input/Output) pins (D4 to D8 and D12) for motor control. The

shield also offers expansion capabilities, including I

2C (Inter-Integrated Circuit) headers

and XBee-compatible sockets, although wireless features were not used in the present

implementation.

## 3.3 Assembly

This section details the specific electrical interconnections and physical assembly of the

system’s components, providing understanding of the wiring implementation. The com-

plete electrical schematic, illustrating all pin-level connections, is presented in Figure 3.3.

The central control unit, an Arduino Uno board, interfaces with the various modules of

the system primarily through a dedicated Dual Bipolar Stepper Motor Shield. This shield

occupies all available pins on the Arduino, simplifying the overall wiring by consolidating

power and control interfaces. The shield includes dedicated slots for the two DRV8825

stepper motor drivers (D1 and D2), which control the azimuth and perpendicular axes.

The stepper motors (M1 and M2) are connected to the DRV8825 drivers via specific

terminals in the shield. For both motors, the wiring follows a standard bipolar configura-

tion, with coil wires from 1 to 4 connected to pins 2B, 2A, 1B, and 1A on their respective

DRV8825 drivers.


Figure 3.3: Detailed electrical schematic of the measurement system, illustrating component interconnections and pin assignments.

Auxiliary components, such as the Hall-effect magnetic position sensors and the RF

power detector module, connect to specific analog input pins provided by the shield.

Sensor 1 is connected to analog pin A0, and Sensor 2 to analog pin A1. The AD8313 RF

power module’s analog output is connected to analog pin A3 of the shield, allowing the

Arduino Uno to read the converted RF power signal.

Power distribution is managed centrally by the shield. An external 12V DC power supply

provides the primary input to the shield. From this input, the shield directly supplies

12 V to both the stepper motors (via the DRV8825 drivers) and the AD8313 RF power

module. Additionally, the shield incorporates an onboard voltage regulator that steps

down the 12 V input to provide a stable 5 V supply, which powers the Arduino Uno

board itself and the Hall-effect sensors. This integrated power management simplifies the

wiring and ensures proper voltage levels for all components.

The shield also provides 5 V or 12 V output, depending on the physical configuration.

In addition to the analog pins, the shield has digital pins, which were not used in this

project but may be decisive in different approaches.

## 3.4 Software Development

The software for the antenna radiation pattern measurement system comprises two main

modules: Firmware implemented on an Arduino board, for motor control and a data

acquisition and visualisation module developed in MATLAB.

The MATLAB and Arduino interact through the UART (Universal Asynchronous

Receiver-Transmitter) protocol, following a sequence that begins with MATLAB, which

initiates the measurement process by sending the scan parameters such as angular resolu-

tion and rotation range. The Arduino then executes the commands, moving the stepper

motors through their drivers, performing the homing function with the Hall-effect sensors,

and coordinating the acquisition of RF power values from the detector module. As the

platform rotates stage by stage, the Arduino collects the corresponding measurements

and transmits them back to MATLAB. In the meantime, MATLAB stores the data in

a matrix, and after all measurements, the radiation pattern is plotted. This command

→ execution → response loop gives synchronisation between mechanical actuation and

signal acquisition, helping in the measurement results.

The Arduino module controls the stepper motors, also performing a homing proce-

dure to align the antenna to a 0

◦
reference point. This reference detection is achieved

by Hall-effect sensors. Rotations is carried out in increments (e.g., 1

◦
) according to com-

mands received from MATLAB. Status confirmations are sent back via UART to ensure

synchronisation.

The MATLAB script communicates with the Arduino via a virtual communication

(COM) port, employing the built-in serialport() interface of MATLAB. The MATLAB

function acquires RF signal data from the RF Module and stores it in a data matrix. It

processes parameters such as directivity and generates polar plots (2D/3D) to visualise

the antenna radiation pattern.

The UART communication, established over a USB (Universal Serial Bus) connection,

follows a command-response pattern, with MATLAB acting as the master and the Arduino

as the slave. MATLAB sends rotation commands, and the Arduino returns measured power data in dBm. The data flow, illustrated in Figure 3.4, begins with configuration

in MATLAB, followed by command transmission, platform rotation, signal measurement,

data storage, processing, and visualisation.

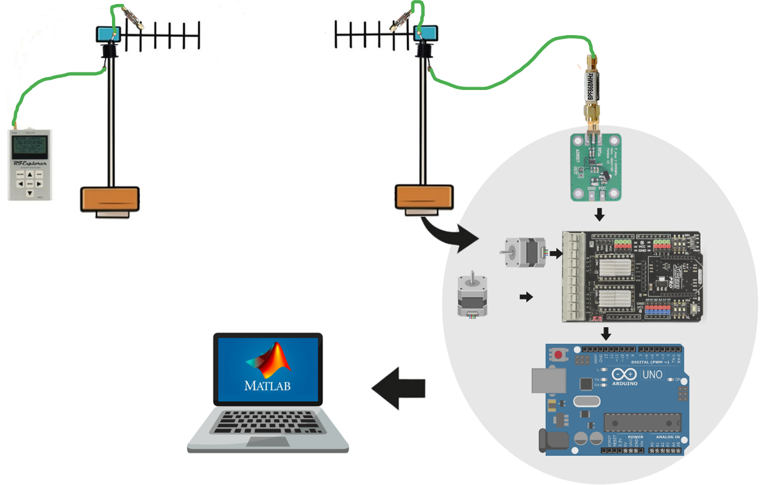
[picture p54: figure]

Figure 3.4: Schematic showing the flow of the signal from generation to analysis.

## 3.5 Validation Strategy

To confirm the accuracy and reliability of the system, a series of validation tests were

conducted following a structured testing protocol. This protocol began with characteri-

sation of the transmitting and receiving antennas, as well as the bandpass filter, using a

nanoVNA at 868 MHz in the ISM band. The filter, centred at 868 MHz with a bandwidth

of 10 MHz, was selected for its ability to mitigate noise, though it introduced approxi-

mately 3 dB insertion loss attenuation. A linear model for signal power conversion was

derived from the characterisation of the module, aligning closely with the datasheet spec-

ifications of the manufacturer.

The measurements were performed in an open environment to minimise unwanted re-

flections, as indoor settings would introduce excessive interference. In an ideal scenario,

tests would be carried out in vacuum or an anechoic chamber, but, due to practical con-

straints, an outdoor setup was employed with consistent conditions across all trials. The

radiation pattern was measured across azimuth angles (0

◦

to 360◦
, 5

◦
resolution), with 100

samples were averaged at each angle to reduce noise. To minimise cumulative angular er-

rors and prevent cable entanglement (as wires were routed through tubes), measurements

were performed bidirectionally: the platform rotated 180◦
in one direction, returned to

the initial position, and then rotated 180◦
in the opposite direction. Ten measurement

cycles were carried out to assess repeatability, with the averages plotted to verify con-

sistency. The experimental results were compared with CST Studio Suite¹ simulations,

showing patterns that were closely aligned with those expected in the literature.

Antenna oscillation during rotation presented a challenge, resolved by increasing the

pulley size on the stepper motor to enhance torque, enabling slower and more precise

movements at the expense of measurement speed. The software was verified through

command window messages in MATLAB and the Arduino IDE (Integrated Development

Environment) to confirm reliable communication without errors.

The system supports other antennas, though only the Yagi-Uda was considered due

to its richer characteristic radiation pattern. The validation, whose results will be pro-

vided in the next section, demonstrated that the system provides reliable and repeatable

measurements, with limitations such as supported antenna size and reduced measurement

speed for greater precision and reduced DUT (Device Under Test) oscillation. It therefore

represents a cost-effective alternative to expensive commercial equipment for educational

antenna studies.

1The free educational version of this software was used in the simulations.

## 3.6 Development and Construction of the Yagi-Uda

## Antenna

The Yagi-Uda antenna, first proposed by Shintaro Uda and popularised by Hidetsugu

Yagi in 1926, is a directional antenna widely used for its high gain, relatively simple

construction, and well-understood behaviour[7]. Nearly a century after its conception, it

remains a popular choice in applications ranging from broadcasting and amateur radio to

modern wireless systems.

The operating frequency selected for the present project was 868 MHz, which lies

within the ISM band allocated for licence-free operation in Europe [8]. Although other

ISM bands such as 433 MHz could be used, the physical size of a half-wavelength element

is inversely proportional to the frequency [9]. Consequently, an antenna for 433 MHz

would be almost twice as large, making it impractical for the intended application. On

the other hand, for frequencies above 1 GHz, the resulting antenna would become very

small, which could compromise mechanical robustness and ease of construction. Thus, the

868 MHz frequency was chosen as an appropriate trade off between electrical performance

and mechanical feasibility.

The Yagi-Uda antenna consists of a driven element (typically a half-wavelength dipole),

a reflector placed behind it, which can take different configurations such as wire-grid, solid-

plane, or curved-surface designs, and one or more directors positioned in front. In this

work, a simple linear reflector was selected for its compatibility with the target frequency

and ease of construction [9, 10]. The theoretical length L of a half-wave element in free

space is expressed as:

L ≈

λ
2

=

c
2f

(3.1)

where c is the speed of light in vacuum (3 × 10⁸ m/s), f is the operating frequency, and

λ is the wavelength. For f = 868 MHz, λ ≈ 0.345 m and L ≈ 0.1725 m (172.5 mm) before

end-effect corrections.

However, in practice, due to the finite diameter of the elements and end effects, these

ideal values require slight adjustments. Practical designs apply correction factors depend-

ing on the element diameter. Typical dimensions are [9]:

Lreflector ≈ (1.03 ± 0.01) ×

λ
2

(3.2)

Ldriven ≈ (0.98 ± 0.01) ×

λ
2

(3.3)

Ldirector ≈ (0.95 ± 0.01) ×

λ
2

(3.4)

The spacing S between elements is usually expressed as a fraction of the wavelength:

0.1λ . S . 0.25λ | (3.5)

When the reflector is placed closer to the driven element, the front-to-back ratio in-

creases, but impedance matching may degrade. In contrast, increasing reflector spacing

can broaden bandwidth at the expense of front-to-back performance. For directors, reduc-

ing spacing increases gain up to a point, but excessive closeness can raise mutual coupling

and narrow bandwidth. Larger director spacing reduces coupling, but may decrease gain

and introduce sidelobes. Figure 3.5 shows the simulated antenna in CST Studio Suite.

It should be noted that the mechanical support structure, namely the boom, fabricated

in PLA during the construction stage, was not represented in the simulation model. This

omission is justified since PLA exhibits a relative permittivity of approximately 2.7 − 2.9

and a relative permeability close to 1, which makes it effectively transparent to RF ra-

diation [11]. As a result, including the boom in the CST model would not significantly

affect the simulated radiation pattern or input impedance. The physical implementation

of the PLA boom and its role in the antenna assembly will be detailed in the subsequent

section.

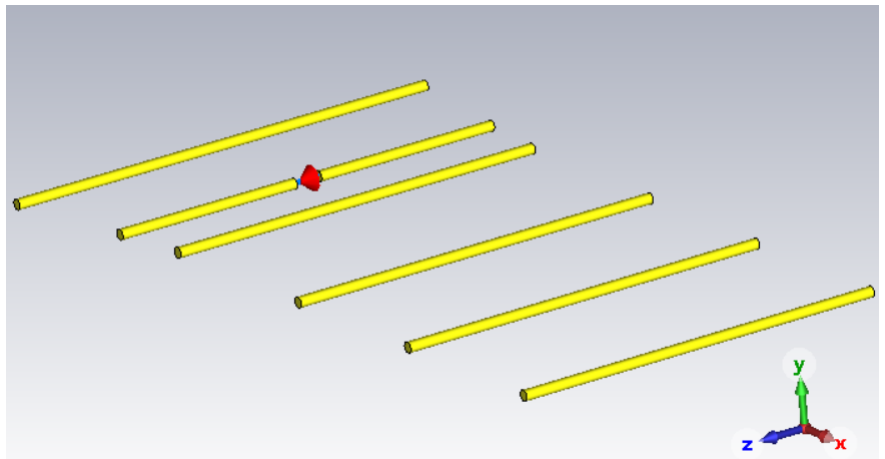
[picture p55: figure]

Figure 3.5: Yagi-Uda antenna simulated in CST Studio Suite.

### 3.6.1 Simulation and Dimensions

The optimised element lengths and spacings obtained in CST Studio Suite are given in

Table 3.1²
, and the constructed prototype is shown in Figure 3.6b. Two identical Yagi-

Uda antennas were constructed based on these specified dimensions: one dedicated to

transmission and the other to reception. This configuration enabled testing the antenna

performance within a representative communication link scenario.

Table 3.1: Element lengths and spacings for the Yagi-Uda antenna.

Element | Length (mm) Position (mm)
Reflector | 166.41 | -51.964
Driven | 150.98 | 0.0
Director 1 | 143.85 | 30.104
Director 2 | 142.16 | 102.131
Director 3 | 140.48 | 166.814
Director 4 | 139.51 | 234.902

2The reference position is measured from the midpoint between the two halves of the driven dipole element. The boom is aligned with the central axis of the elements.

### 3.6.2 Building the Yagi-Uda Antenna

The antenna was modelled mechanically in SolidWorks³
(Figure 3.6a) and the boom was

fabricated using fused deposition modelling (FDM) with PLA, as shown in Figure 3.6b.

The radiating elements were made from solid brass rods with a diameter of 3 mm⁴


(a) Mechanical model in SolidWorks | (b) Constructed prototype

Figure 3.6: Mechanical model of the antenna developed in SolidWorks and the constructed Yagi-Uda antenna prototype.

### 3.6.3 Antenna Characterisation

The reflection coefficient S11 and the VSWR of the transmitting and receiving antennas

were measured with the NanoVNA. both antennas exhibited nearly identical responses,

as expected from their close design, with only minor construction tolerances causing

negligible deviations; therefore, only one set of results is presented in Figure 3.7 for

conciseness. Minor variations between them are expected due to construction tolerances,

but no significant deviations were observed.

The resonance occurs close to the intended frequency of 868 MHz. The optimum

impedance matching condition was obtained at approximately 876 MHz, where S11 reached

around −13 dB and the VSWR was 1.58. At 868 MHz, the measured values were

S11 ≈ −11 dB and VSWR ≈ 1.77, corresponding to an input impedance of about

3Educational version licensed to the Polytechnic Institute of Bragança.
4Brass composition was approximately two-thirds copper and one-third zinc.

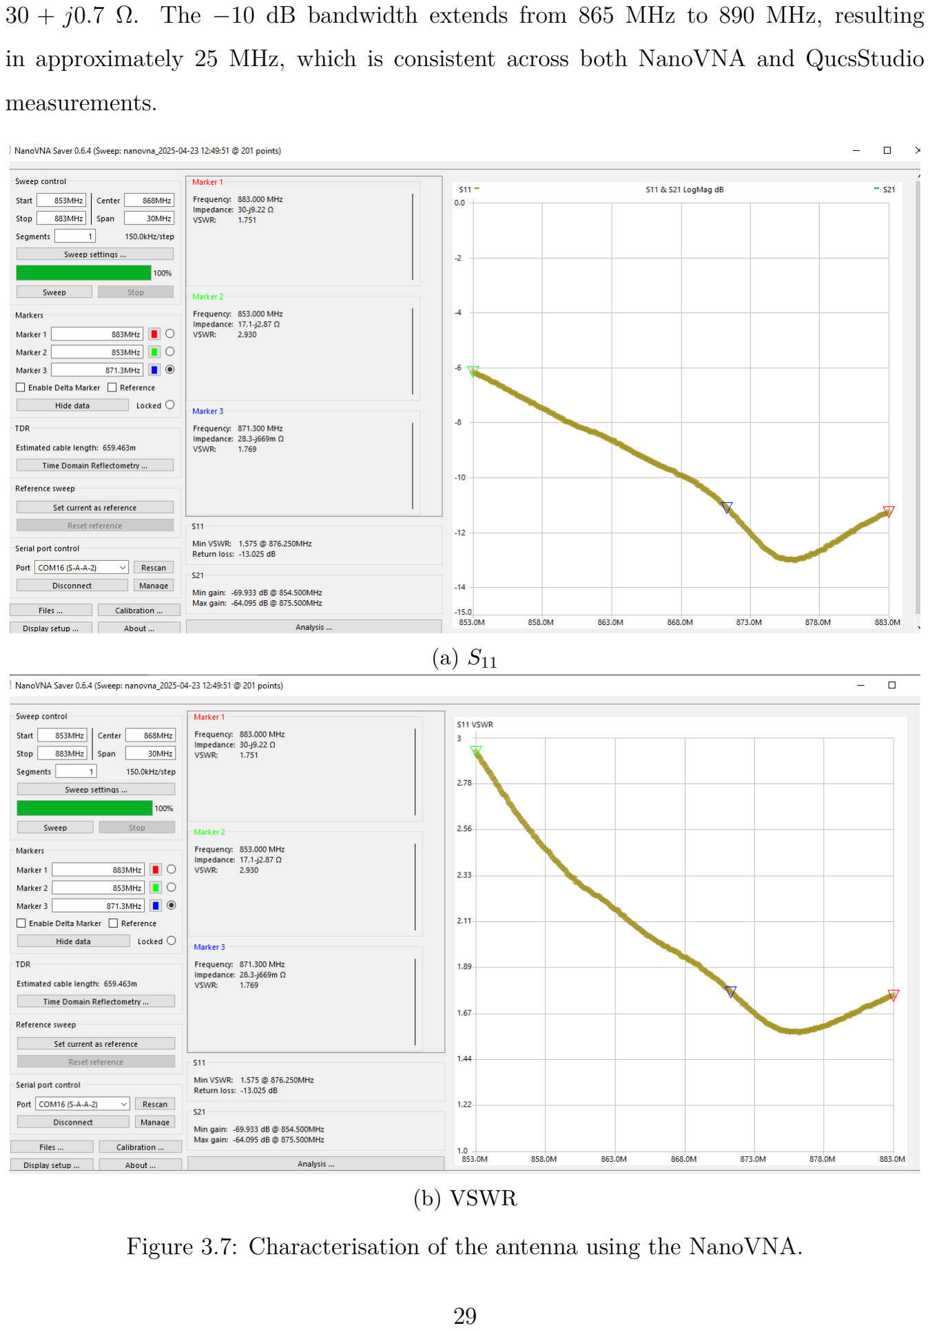
[picture p56: page 47]

30 + j0.7 Ω. The −10 dB bandwidth extends from 865 MHz to 890 MHz, resulting

in approximately 25 MHz, which is consistent across both NanoVNA and QucsStudio

measurements.

(a) S11
(b) VSWR

Figure 3.7: Characterisation of the antenna using the NanoVNA.

Overall, the antennas demonstrate acceptable matching around the ISM band, vali-

dating their suitability for the subsequent radiation pattern measurements. Nevertheless,

clearly could be better parameters.

## 3.7 RF Signal Integrity: Balun and Impedance Match-

## ing Network

In RF systems, optimal power transfer and signal integrity depend not only on the an-

tenna geometry but also on suppressing undesired current modes and ensuring accurate

impedance matching between interconnected components [9]. Since the nominal charac-

teristic impedance of most RF systems is 50, Ω, particular attention was given to this

requirement during the antenna design.

Therefore, two strategies were implemented: (i) mitigation of common-mode currents

through the use of a balun, and (ii) the design of an impedance matching network to

ensure a 50 Ω interface between the antenna and the transmission line, as well the RF

sensor module.

### 3.7.1 Balun for Common-Mode Current Suppression

When a balanced antenna, such as the Yagi-Uda, is connected to an unbalanced coaxial

transmission line, common-mode currents can propagate along the shield of the coaxial

cable. These currents can cause radiation from the feed line itself, altering the antenna

radiation pattern and impedance characteristics [12, 13]. To mitigate this effect, a cur-

rent balun was implemented, functioning as a choke to suppress common-mode currents

without affecting the desired differential-mode signal [14, 15].

The balun geometry was designed using analytical calculations that considered the

type of coaxial cable (RG-174) and its physical dimensions, as the conductor diameter

and dielectric properties directly influence the inductance, the skin effect, and the ability

to suppress common-mode currents at RF. A MATLAB script was used to determine the

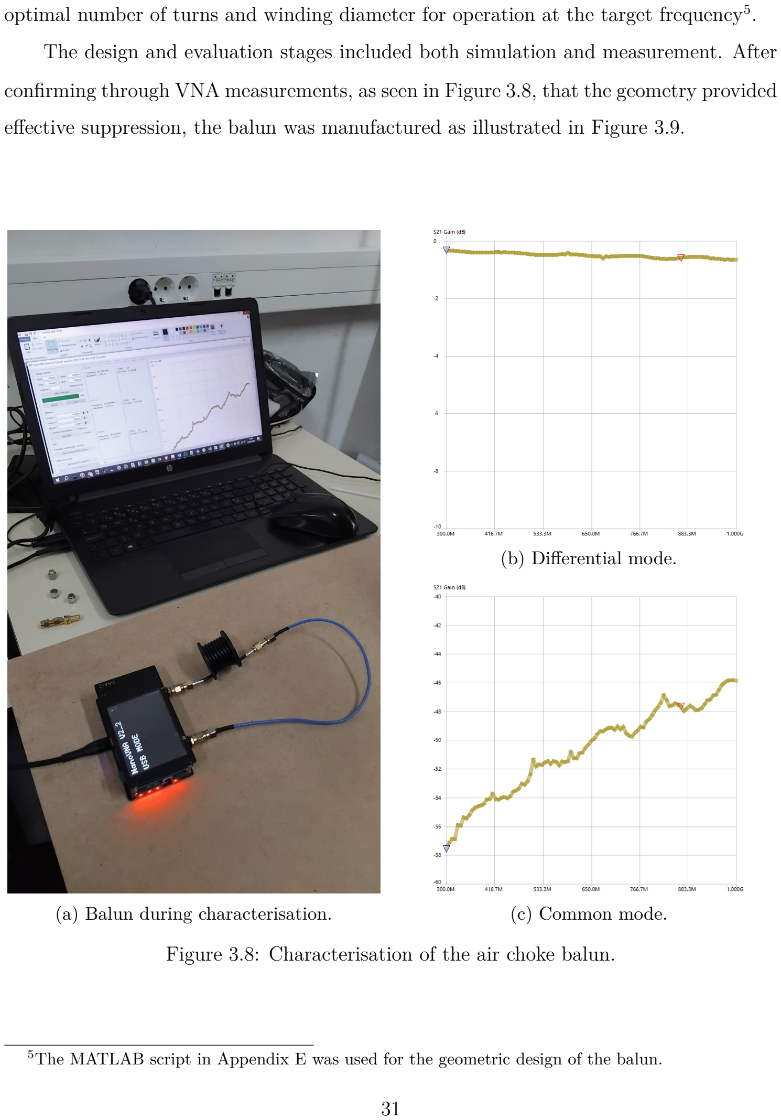
[picture p57: page 49]

optimal number of turns and winding diameter for operation at the target frequency⁵ .

The design and evaluation stages included both simulation and measurement. After

confirming through VNA measurements, as seen in Figure 3.8, that the geometry provided

effective suppression, the balun was manufactured as illustrated in Figure 3.9.

(a) Balun during characterisation.
(b) Differential mode.
(c) Common mode.

Figure 3.8: Characterisation of the air choke balun.

5The MATLAB script in Appendix E was used for the geometric design of the balun.

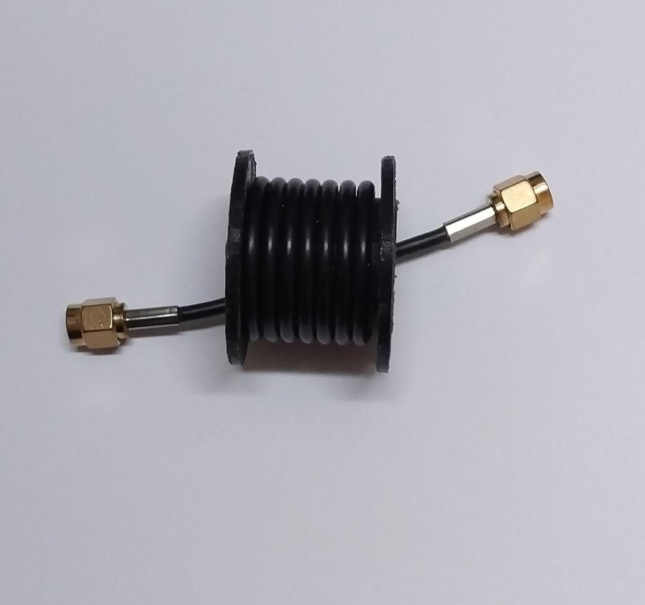
[picture p58: figure]

(a) Balun and a measuring tape. | (b) Top view of the balun.

Figure 3.9: Photos of the air choke balun manufactured using RG174 cable, with 3D printed support.

### 3.7.2 Impedance Matching Network Design

After antenna characterisation, as seen in Subsection 3.6.3, it became evident that impedance

matching was required due to the observed mismatch with the 50 Ω reference[16]. Initial

estimates for the matching network components (capacitor and inductor) were obtained

using QucsStudio and CST simulations, considering the antenna response alone. However,

these values needed refinement once the effect of the PCB layout was included. For this

reason, the PCB was first characterised in its bare form, without components, to quantify

its intrinsic parasitic contributions.

The shunt PCB impedance, |Z| ≈ 21.5 Ω, was obtained from the measured S21,

as shown in Figure 3.10. Then, the corresponding parasitic capacitance follows from

Equation (3.6). This measurement yielded C ≈ 8.5 pF. Simulations independent of the

PCB (CST and QucsStudio) gave C ≈ 7.8 pF, in close agreement with the experimental

result. Figures 3.11 and 3.12 show the models and results obtained from the simulations.

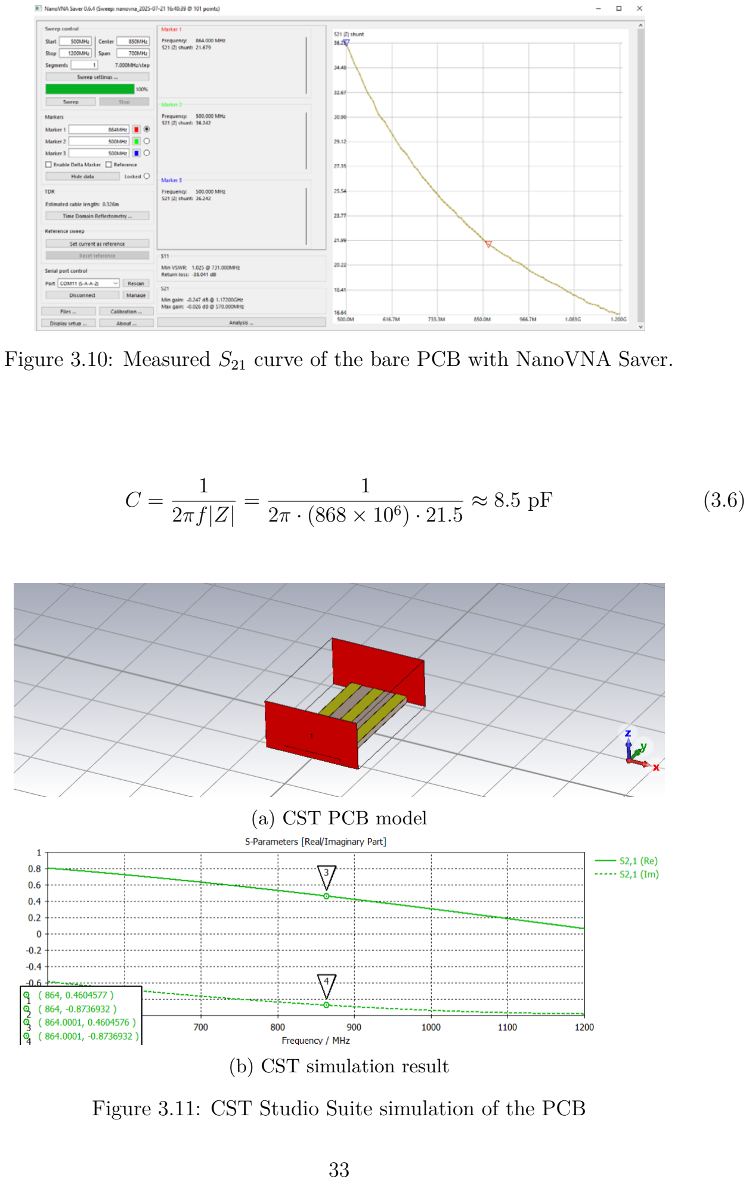
[picture p59: page 51]

Figure 3.10: Measured S21 curve of the bare PCB with NanoVNA Saver.

C =

1
2πf|Z|

=

1
2π · (868 × 10⁶

) · 21.5

≈ 8.5 pF | (3.6)
(a) CST PCB model
(b) CST simulation result

Figure 3.11: CST Studio Suite simulation of the PCB

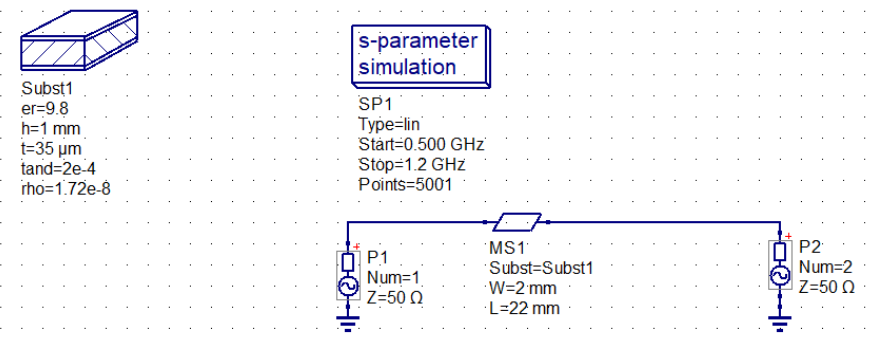
[picture p60: figure]

(a) QucsStudio PCB model


(b) QucsStudio simulation result

Figure 3.12: QucsStudio simulation of the PCB: (a) model and (b) result.

Z = Z0 ·

S21
2(1 − S21)
, | Z0 = 50 Ω | (3.7)

ZCST = 50 ·

0.460458 − j0.873693
2 (1 − (0.460458 − j0.873693)) ≈ −12.21 − j20.71 Ω | (3.8)

|ZCST| =

q
(−12.21)² + (−20.71)² ≈ 24.04 Ω | (3.9)

CCST =

1
2π · 864 × 10⁶
- 24.04

(3.10)

CCST ≈ 7.66 × 10⁻¹² F | (3.11)
CCST = 7.66 pF | (3.12)

ZQucs = 50 ·

0.437 − j0.829
2 (1 − (0.437 − j0.829)) | (3.13)
ZQucs ≈ −10.98 − j20.64 Ω | (3.14)

|ZQucs| =

q
(−10.98)² + (−20.64)² ≈ 23.38 Ω | (3.15)

CQucs =

1
2π · 864 × 10⁶
- 23.38

(3.16)

CQucs ≈ 7.87 × 10⁻¹² F | (3.17)
CQucs = 7.87 pF | (3.18)

As noted, the results of the measurements and simulations (CST and QucsStudio) are

in close agreement, producing parasitic capacitance values in the range of 7.66 to 8.5 pF.

This consistency confirms that the PCB introduces significant capacitance, which would

be an issue if it was not considered for the impedance matching design[17].

After, all S-parameters were acquired to build a Touchstone file of the PCB for co-

simulation with the DUT. With the NanoVNA, the sweep was performed to obtain S11

and S21, and the ports were inverted to acquired the S22 and S12. Then, they were merged

into a single two-port file. The measured responses are shown in Figure 3.13, while the

resulting files were validated in Qucs before use, is illustrated in Figure 3.14.

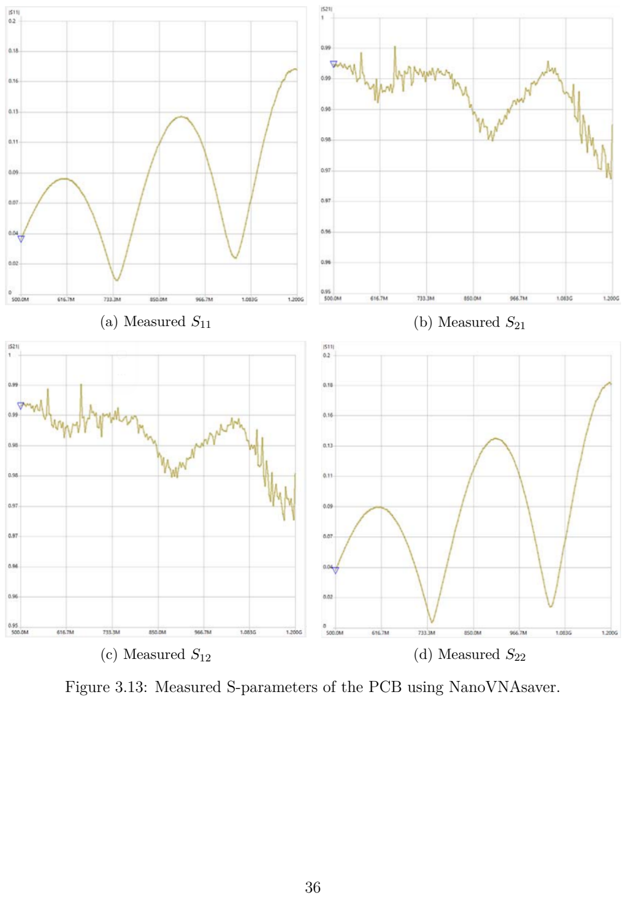
[picture p61: page 54]

(a) Measured S11 | (b) Measured S21
(c) Measured S12 | (d) Measured S22

Figure 3.13: Measured S-parameters of the PCB using NanoVNAsaver.

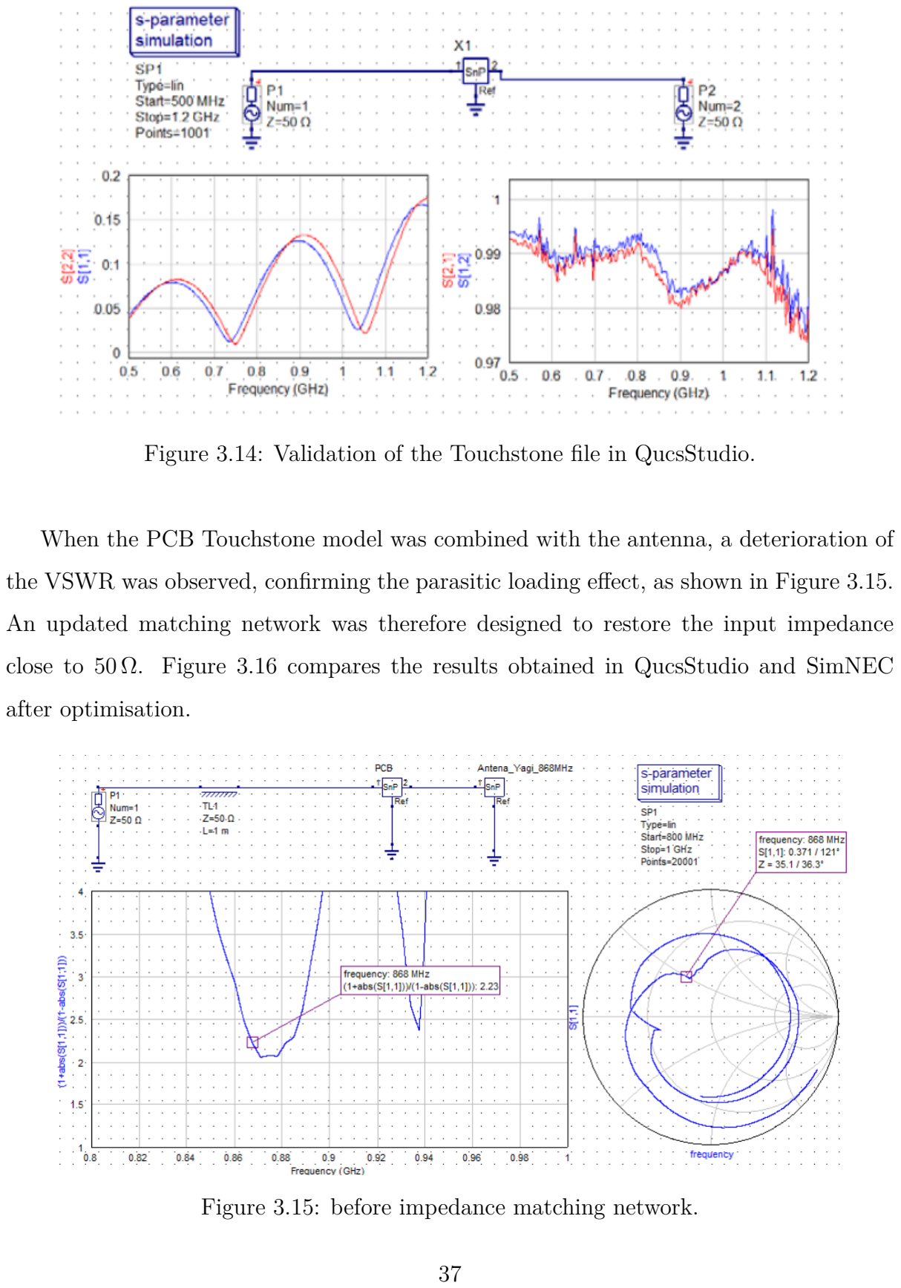
[picture p62: page 55]

Figure 3.14: Validation of the Touchstone file in QucsStudio.

When the PCB Touchstone model was combined with the antenna, a deterioration of

the VSWR was observed, confirming the parasitic loading effect, as shown in Figure 3.15.

An updated matching network was therefore designed to restore the input impedance

close to 50 Ω. Figure 3.16 compares the results obtained in QucsStudio and SimNEC

after optimisation.

Figure 3.15: before impedance matching network.

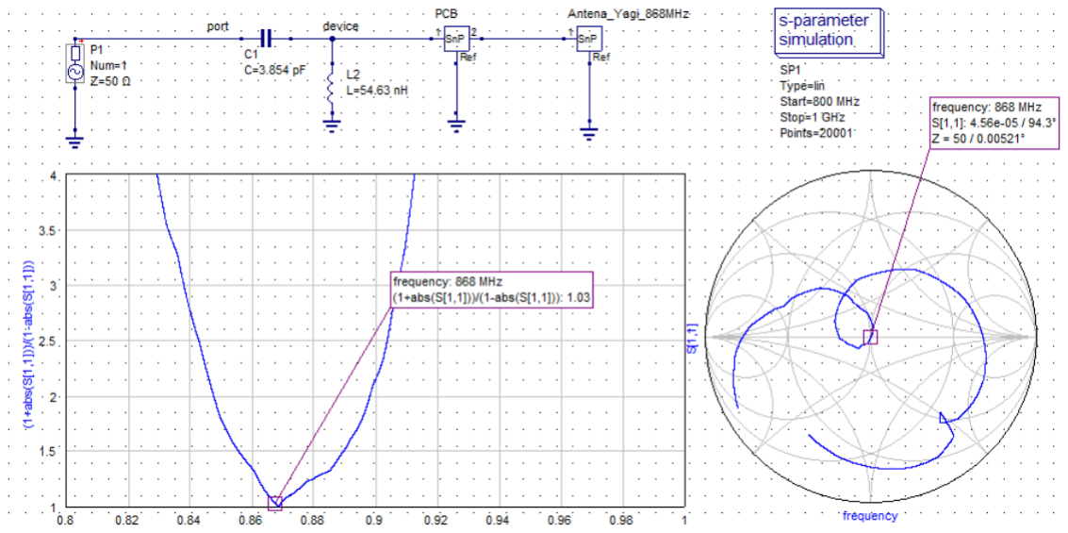
[picture p63: figure]

(a) Impedance matching in QucsStudio.


(b) Matching network validation in SimNEC.

Figure 3.16: Results of the optimised matching network.

The final values of network component are listed in Table 3.2. These elements were

used in the manufactured PCB.

Table 3.2: Final LC matching network component values.

Element | Estimated | Used
L | 54.6 nH | 56 nH
C | 3.8 pF | 3.9 pF

Finally, Figure 3.17 shows the complete PCB design workflow: (a) layout model in

QucsStudio, (b) schematic design in EasyEDA⁶
, and (c) the manufactured board.

6EasyEDA is a free, online PCB design software.

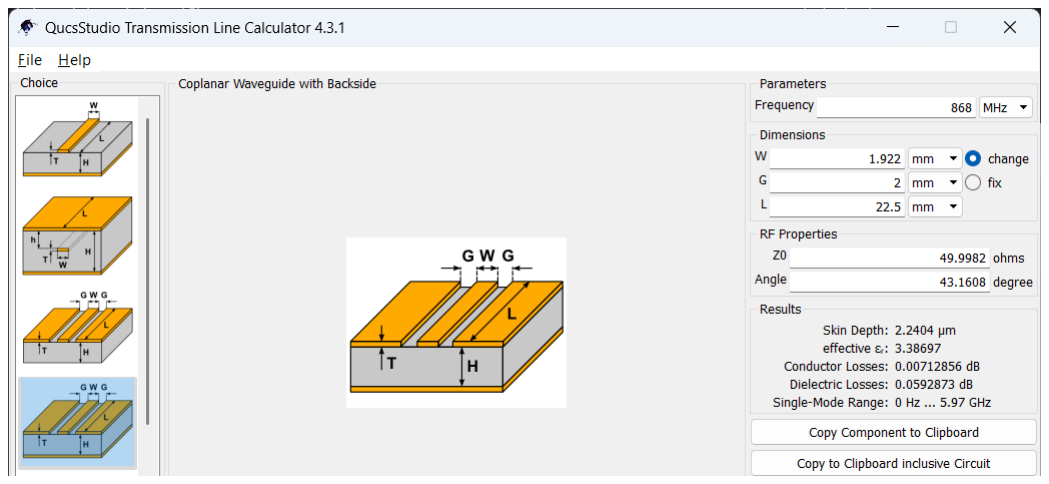
[picture p64: figure]

(a) QucsStudio PCB layout model

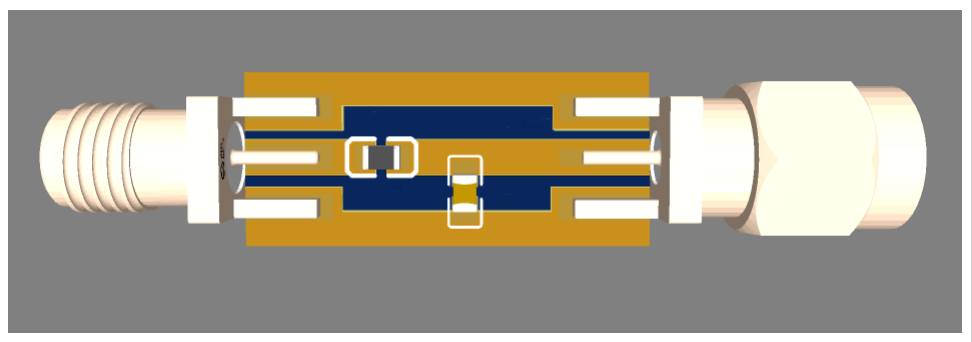
[picture p65: figure]

(b) PCB design in EasyEDA

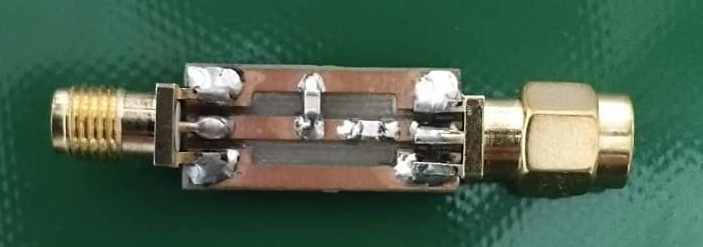
[picture p66: figure]

(c) Manufactured PCB photograph

Figure 3.17: PCB layout model in QucsStudio , design in EasyEDA, and photograph of the manufactured.

## 3.8 Estimated Component Costs

Table 3.3 summarises the average prices of the main components used in this project,

both in Portugal and in the Asian market. Although these values are only indicative, they

provide a realistic estimate of the typical costs involved. The total amount is modest,

underscoring the low-cost nature of the design. When compared with the commercial

equipment discussed in Chapter 2, the cost of this project represents only a small fraction.

Table 3.3: Estimated cost of components used in the project.

Component | Portugal | Asian Market
Arduino UNO | e 29.50 | e 3.80
Dual Bipolar Stepper Motor Shield for Arduino (DRV8825) | e 34.50 | e 6.80
2 Hall-effect sensors | e 5.38 | e 0.44
2 NEMA17 stepper motors | e 24.00 | e 16.54
1.5 m GT2 timing belt (6 mm) | e 3.60 | e 2.58
20-teeth pulley for NEMA17 stepper motor | e 3.70 | e 2.56
Power supply 230V∼12V - 2A | e 4.97 | e 4.68
2 m fibreglass tube, 18 mm (12 mm inner) | e 52.28 | e 22.70
1 Kg PLA filament (1.5 mm) | e 15.49 | e 7.00
Electronic wires for connection | e 15.52 | e 6.32
RF sensor detector | e 20.70 | e 8.58
868 MHz band-pass filter | e 14.95 | e 5.57
2 m copper rod (3 mm or 4 mm) | e 7.60 | e 4.25
FR-4 copper-clad laminate (20X30 cm) | e 6.96 | e 5.24
4 RF connector SMD (Male and Female) | e 29.92 | e 4.92
Capacitor and Inductor SMD 0805 | e 0.90 | e 0.50
Screws and Threads | e 8.46 | e 3.27
2 nylon bearings | e 3.86 | e 1.35
2 standard bearings | e3.94 | e 3.15
4 ball bearing with collar | e 15.25 | e 3.85
3 bases (wood or equivalent), Ø 30 cm | e 4.80 | e 8.10
TOTAL | e 306.28 | e 122.20

The subsequent chapter presents the experimental results obtained and discusses their

impact, considering the materials and methods described previously.

# Chapter 4

# Results

## 4.1 Introduction

This chapter presents the experimental results obtained from the characterisation of the

antennas, the balun, the impedance matching PCB, and the 868 MHz band-pass filter, as

well as from the complete antenna radiation pattern measurement system. The band-pass

filter, based on SAW (Surface Acoustic Wave) technology, was included in the setup to

suppress out-of-band noise and interference. The initial objective of these measurements

was to validate the performance of the antennas individually, both the transmitting and

receiving antennas, which exhibit very similar, though not identical, behaviour due to

slight manufacturing differences.

Measurements were carried out mainly with a VNA, supported by an RF signal gen-

erator and, in some cases, with a Spectrum Analyzer (SA). For each element, S11 and,

where relevant, S21 parameters were measured to evaluate impedance matching, signal in-

tegrity, and the suppression of undesired common modes. All measurements are presented

together with their corresponding plots for clarity.

Among the different characterisations, the antenna radiation pattern was of particular

interest, as it directly reflects the Yagi-Uda design and provides a key indicator of the

overall system performance.

## 4.2 Measurement Setup

The objective of this measurement setup was to obtain the horizontal (azimuth) radiation

pattern of the antenna under test and to validate the far-field measurement conditions.

The transmitting and receiving antennas were initially characterised using a NanoVNA

at 868 MHz. After that, the band-pass filter was also verified for compliance with the

operating frequency requirements.

For the far-field radiation pattern measurement, the minimum far-field distance was

calculated using (4.1):

d =

2R²
λ

(4.1)

where R is the largest dimension of the antenna, equivalent to the boom length in

the case of the Yagi-Uda, and λ is the wavelength. For R = 0.3 m and λ ≈ 0.345 m,

d ≈ 0.52 m. To ensure far-field conditions, the antennas were spaced D = 2.5 m apart.

The transmitting antenna was a Yagi-Uda with a gain of approximately 10 dB, with a

maximum input power of 0.5 mW (−3 dBm) to comply with an EIRP (Effective Isotropic

Radiated Power) of 5 mW. Using the Friis equation (4.2) [18], which relates transmitted

and received power in free space, the expected received power can be calculated. Assuming

an isotropic receiving antenna, the result is:

Prx = Ptx + Gtx + Grx − 20 log10

4πD
λ
(4.2)

Prx = −3 + 10 + 0 − 20 log10

4π × 2.5
0.3456
(4.3)
Prx ≈ −32 dBm (in free-space conditions). | (4.4)

Considering, however, that the receiving antenna is also a Yagi-Uda with a gain of

about 10 dB, the expected received power rises to approximately −22 dBm, which is in

line with the measured results discussed later (between −22 and −18 dBm).

Measurements were performed outdoors to minimise multipath effects, with both an-

tennas mounted at least 1 m above ground on fibreglass supports to reduce ground reflec-

tions. The receiving antenna was rotated in azimuth in 5

◦
steps, while the transmitting

antenna remained fixed.

The signal power was measured using an AD8313 detector, calibrated before the mea-

surements began. The calibration data were obtained from a reference measurement setup,

as shown in Figure 4.1, and the relationship between the input signal power and the out-

put voltage of the integrated circuit was determined using the weighted least squares

method, as shown in:

Vout = 0.0185 · Pin + 1.8621 | (4.5)

yielding a sensitivity of approximately 19 mV/dBm, close to the 18 mV/dBm from

the datasheet.

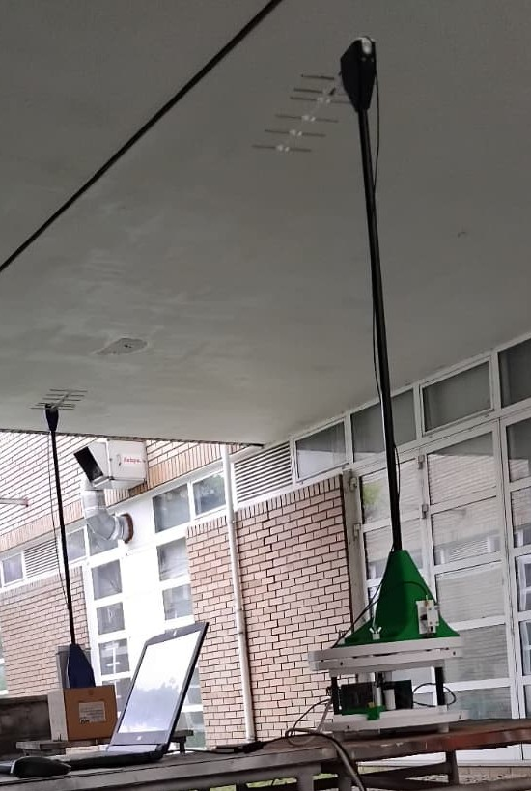
[picture p67: figure]

(a) Setup rear view


(b) Setup side view(closer)


(c) Setup side view

Figure 4.1: Experimental setup for transmitting and receiving antennas, showing rear and side perspectives.

## 4.3 Characterisation of Components

The characterisation of the components was performed using the NanoVNAsaver¹ and,

where applicable, a TinySA (spectrum analyzer). Measurements focused on the relevant

scattering parameters (S-parameters) of each component.

In this work, only the most relevant S-parameters are considered, namely S11 and S21.

However, the others parameters are:

- S11: reflection coefficient at port 1, indicating the matching of the input impedance.
- S21: forward transmission from port 1 to port 2, representing insertion loss or gain.
- S22: reflection coefficient at port 2, indicating the matching of the output impedance.
- S12: reverse transmission from port 2 to port 1, representing isolation or reverse

gain.

In addition, to complement the analysis of impedance matching, the Voltage Standing

Wave Ratio (VSWR) was also considered. VSWR is directly related to S11 and indicates

how effectively power is transferred from the source to the load, with values close to 1

indicating good matching, and values above 2 are generally considered poor.

### 4.3.1 868 MHz Band-Pass Filter

The measured response confirms that the filter effectively attenuates out-of-band signals

and reduce unwanted noise, thereby improving the selectivity of the measurement system.

Figure 4.2 shows the measured S21 parameter, representing the insertion loss.

1NanoVNAsaver is an open-source software that reads data from the NanoVNA and displays it on a computer.

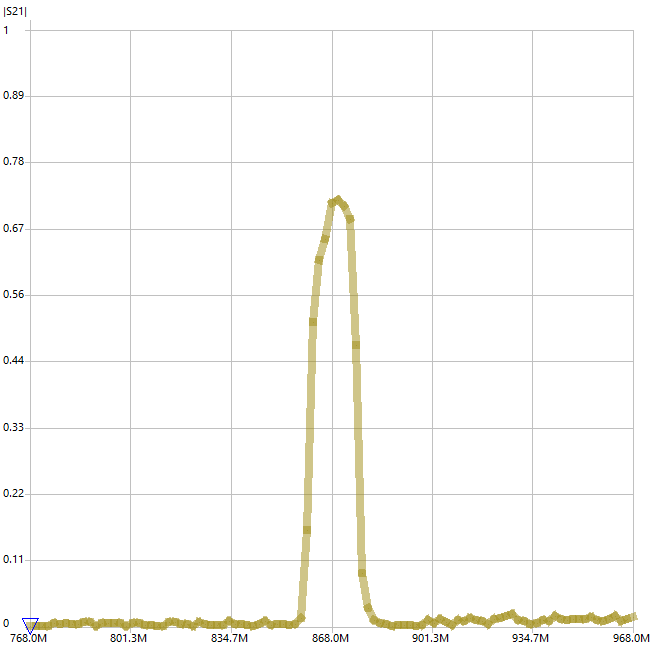
[picture p68: figure]

Figure 4.2: S21 of the 868 MHz band-pass filter showing insertion loss and passband characteristics.

At the centre frequency of 868 MHz, the insertion loss is approximately 3 dB, which

is consistent with the manufacturer’s specifications. The bandwidth extends from about

860 MHz to 880 MHz, typical of commercial ISM band-pass filters. This response en-

sures that the antenna operates effectively within the intended frequency range while

suppressing frequencies outside it.

The measured attenuation will be taken into account in the subsequent radiation

pattern measurements, as it directly affects the received signal strength.

### 4.3.2 Balun

The transmission coefficient S21 of the balun was measured using a VNA to evaluate its

performance in converting between balanced and unbalanced signals. The results, shown in Figure 4.3, indicate a differential mode insertion loss of approximately −0.58 dB at

868 MHz and a common mode attenuation greater than −47 dB at the same frequency.

Additional measurements confirmed good impedance matching at both ports.

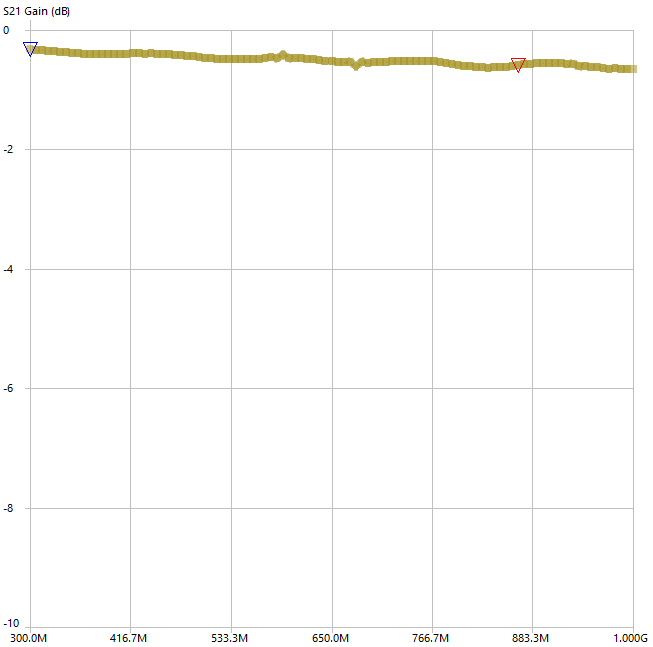
[picture p69: figure]

(a) Differential mode: insertion loss of ≈ −0, 58 dB at 868 MHz.

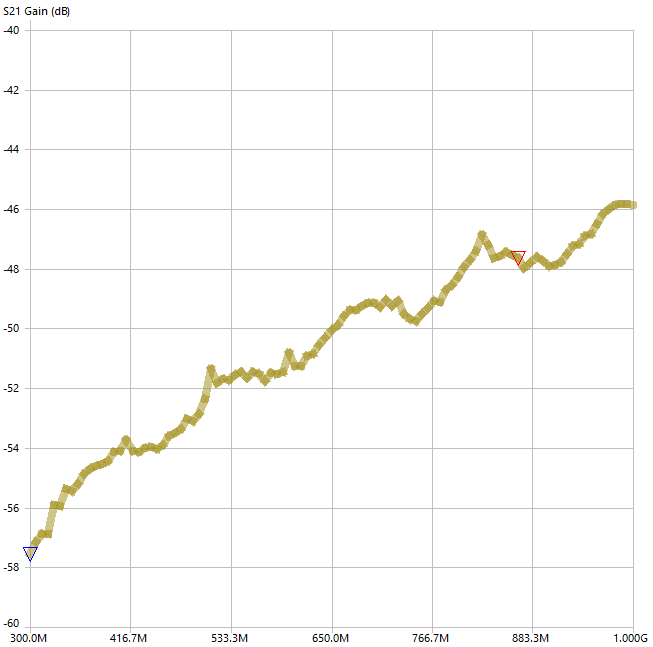
[picture p70: figure]

(b) Common mode: attenuation greater than −47 dB at 868 MHz.

Figure 4.3: Experimental S21 results for the air choke balun using VNA in differential and common modes.

### 4.3.3 PCB for Impedance Matching

The S-parameters of the PCB confirm the effectiveness of the impedance matching net-

work, as shown in Figure 4.4. At the 868 MHz frequency, the reflection coefficient at the

input port is S11 ≈ −20.3 dB. This translates to a VSWR of approximately 1.213, close

to the ideal value of 1. The input impedance measured at this frequency is 43.1−j5.76 Ω,

close to the nominal 50 Ω reference. Such results demonstrate that the reflected power is

reduced to below 1%, confirming an excellent matching performance. Other parameters

were omitted, as they provided no further insight into the matching performance.


Figure 4.4: S11 graph and VSWR of the PCB used for impedance matching

### 4.3.4 Reflection Coefficient and Matching Performance

Matching improvement was quantified by evaluating the reflection coefficient (Γ) and

reflected power. The relationships between return loss, reflection coefficient, and reflected

power are well-established in microwave engineering [10].

The return loss (RL) is related to the voltage reflection coefficient Γ as:

RL = −10 log10

Prefl

Pinc

= −20 log10

Vrefl

Vinc

= −20 log10 |Γ| | (4.6)

Equivalently, the S-parameter S11 is related to the reflection coefficient as:

S11 = −RL = 20 log10 |Γ| −→ |Γ| = 10⁻

RL
20 | (4.7)

Finally, the fraction of reflected power can be expressed as:

Prefl = |Γ|

(4.8)

These equations are directly related: the return loss determines the magnitude of the

reflection coefficient, which in turn gives the fraction of reflected power. This allows an

intuitive interpretation of matching performance in terms of the percentage of incident

power that is reflected back. In practical terms, the complement 1 − |Γ|

2
corresponds to

the fraction of power actually delivered to the load, providing a direct link between return

loss and system efficiency. For instance, a return loss of 10 dB corresponds to about 10%

reflected power, while 20 dB corresponds to only 1%, values that are typically regarded

as acceptable or good in RF design.

### Before Matching

For a measured return loss of RL ≈ 11 dB:

|Γ| = 10⁻

RL
20 | (4.9)

|Γ| = 10⁻

11
20 ≈ 0.2818, | (4.10)
Prefl = (0.2818)² ≈ 0.079 (or 7.9%) | (4.11)

### After Matching

With the return loss improved to RL ≈ 20.3 dB:

|Γ| = 10⁻

RL
20 | (4.12)

|Γ| = 10⁻

20.3
20 ≈ 0.096, | (4.13)
Prefl = (0.096)² ≈ 0.0092 (or 0.92%) | (4.14)

These results show that the reflected power was reduced from approximately 8% to

less than 1% of the incident power, which corresponds to a significant improvement in

power transfer efficiency. This analysis confirms that, despite the impedance of 43.1 −

j5.76 Ω, the antenna system exhibits significantly improved matching compared to the

initial condition.

## 4.4 Radiation Pattern Measurement

This section presents the measurement of the azimuth radiation pattern of the antenna

under test. The objective is to assess the real-world performance of the antenna and

compare it with the ideal model obtained from simulations in CST Studio Suite. At

the end of this section, the 3D pattern is also displayed, and although it shows only the

azimuth axis, the DUT could be evaluated on a second axis perpendicular to the first.

It should be noted that the simulated model assumes a vacuum environment without

reflections, while the measurements are conducted under outdoor conditions with potential

multipath effects. Despite these differences, the basic radiation characteristics of the

antenna are expected to align with the simulation, providing a reference for subsequent

evaluations with additional components such as the band-pass filter, balun, and impedance

matching network.

### 4.4.1 Antenna Only

The measured radiation pattern shows the main lobe and side lobes of the antenna,

which can be compared to the ideal simulated model. Minor deviations are expected due

to environmental factors.

As shown in Figure 4.5, both the measured and simulated radiation patterns exhibit

a main lobe centred at 90◦
, confirming that the system is able to determine the direction

of maximum radiation. The measured half-power beamwidth is 49.1◦
, which is in close

agreement with the simulated value of 47.7◦
. The front-to-back ratio was measured at

17.0 dB, compared to 16.3 dB obtained in simulation (not shown in the figure). These

results indicate that the proposed setup is capable of reproducing the main features of

the radiation pattern, including the main lobe and the secondary lobes.

In spite of this, this first antenna radiation pattern measurement provides the main

feedback to improve the results.

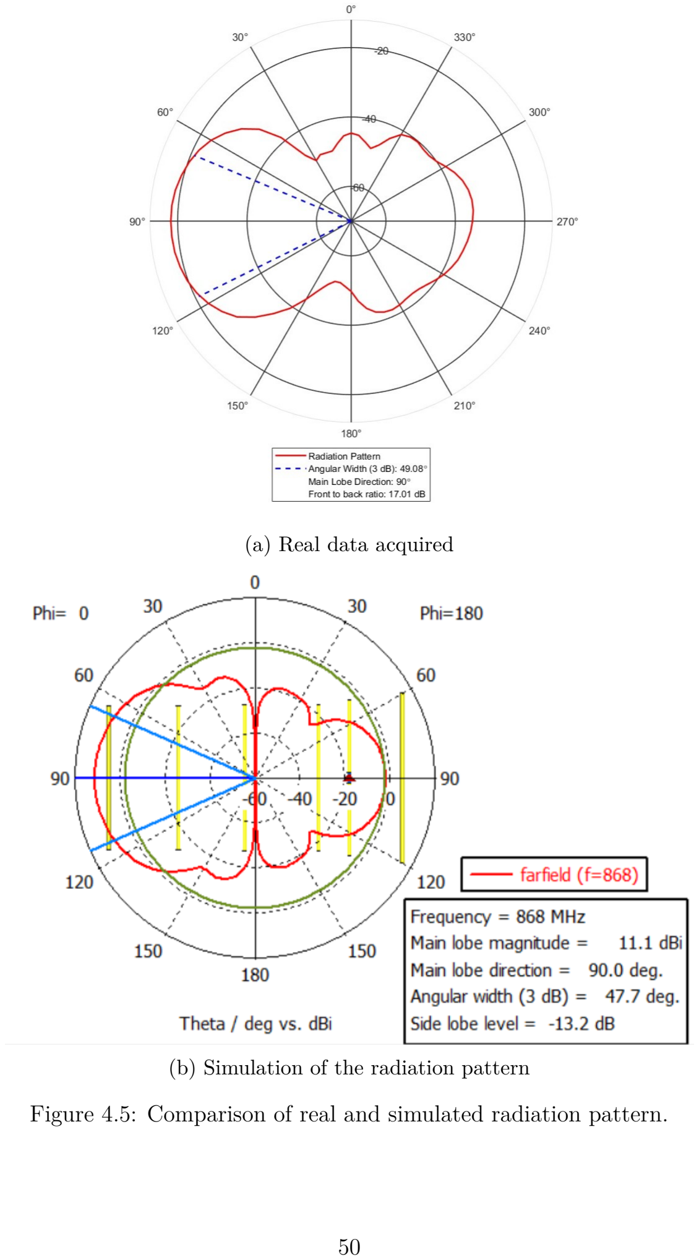
[picture p71: page 68]

(a) Real data acquired
(b) Simulation of the radiation pattern

Figure 4.5: Comparison of real and simulated radiation pattern.

### 4.4.2 Antenna with Band-Pass Filter

The inclusion of the band-pass filter introduces a small insertion loss and minor modifi-

cations to the radiation pattern, which are visible when comparing the measurement to

the simulation, as illustrated in Figure 4.6


(a) Real data acquired with 868 MHz bandpass filter


(b) Simulation of the radiation pattern on CST Studio Suite

Figure 4.6: Comparison of real and simulated radiation pattern. Antenna with band-pass filter.

### 4.4.3 Antenna with Band-Pass Filter and Balun

Adding the balun modifies the current distribution in the antenna, slightly affecting the

shape of the radiation pattern compared to the previous configuration, as it is possible to

visualise in Figure 4.7.

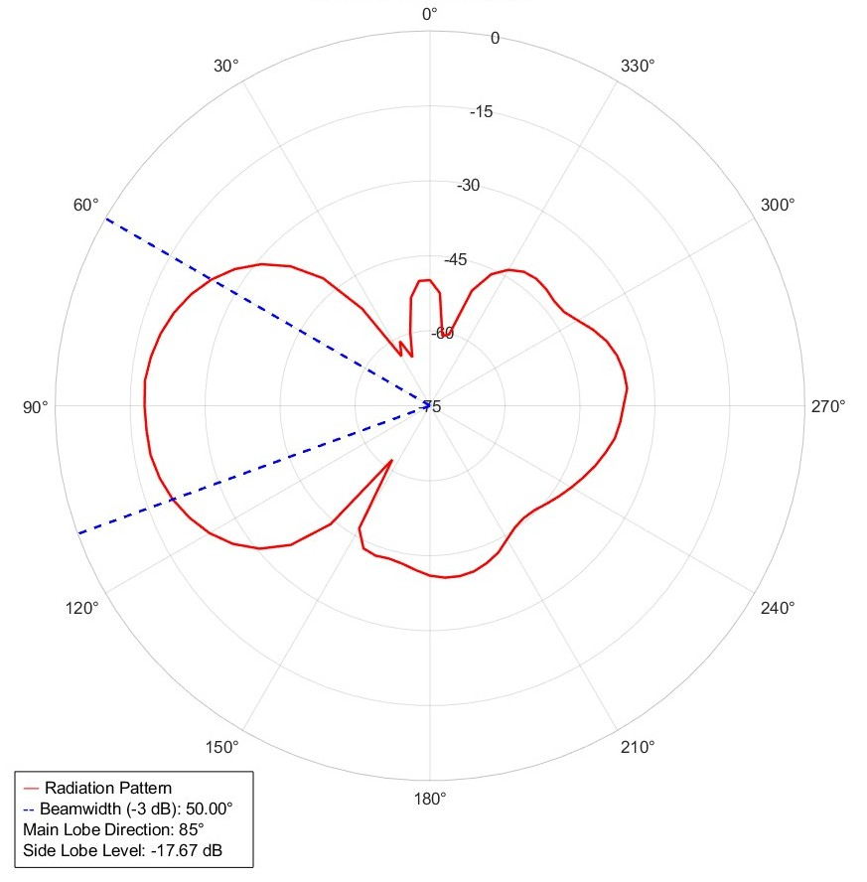
[picture p72: figure]

(a) Real data acquired with 868 MHz bandpass filter and balun.
(b) Simulation of the radiation pattern on CST Studio Suite

Figure 4.7: Comparison of real and simulated radiation pattern. Antenna with band-pass filter and balun.

The inclusion of the band-pass filter introduces a small insertion loss (≈ 3 dB) without

significantly altering the main lobe of the radiation pattern.

### 4.4.4 Antenna with Band-Pass Filter, Balun, and Impedance

### Matching Network

The full configuration, including the impedance matching network, provides the most re-

alistic representation of the final system, as can be seen in Figure 4.8. Interestingly, the

inclusion of the additional components not only preserved the main radiation character-

istics but also brought the measured pattern into closer agreement with the theoretical

model, showed in Figure 4.9. Minor deviations remain, primarily due to practical insertion

losses and environmental reflections.


Figure 4.8: Measured data with filter, balun and impedance matching.

Figure 4.9: Simulated radiation pattern outcome from CST Studio Suite.

3D Radiation Pattern

Although two-dimensional radiation patterns are useful for quickly assessing antenna per-

formance, they provide a partial view of how the radiated power is distributed in space. A

full three-dimensional radiation pattern offers a more complete characterisation, allowing

to see asymmetries and distortions that might not be evident in 2D slices. For this reason,

a 3D measurement was carried out to complement the 2D analyses.

The three-dimensional radiation pattern of the complete antenna system was also

measured and compared with the simulated model obtained in CST Studio Suite, as shown

in Figure 4.10 and Figure 4.11. Despite some distortions observed in the experimental

result, a general agreement with the simulation can be identified. This confirms that

the proposed measurement system is able to operate with two degrees of freedom and to

characterise the radiation pattern in three dimensions.

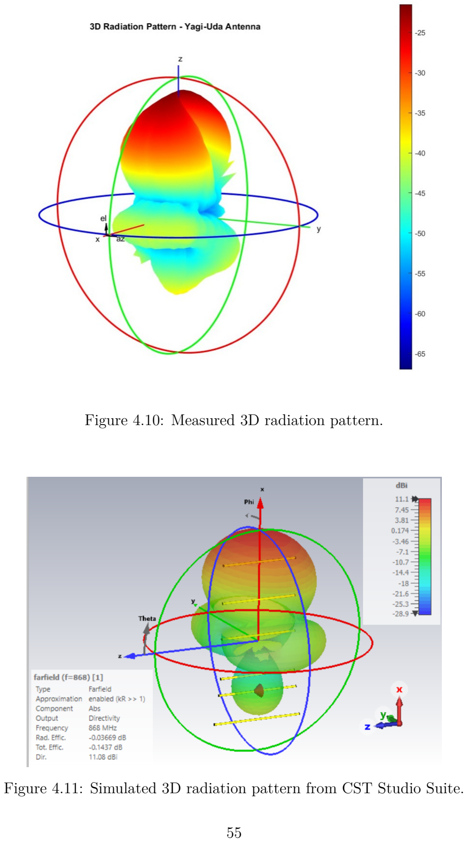
[picture p73: page 73]

Figure 4.10: Measured 3D radiation pattern.

Figure 4.11: Simulated 3D radiation pattern from CST Studio Suite.

## 4.5 Discussion of Results

This section will be developed to provide both a concise overview of the obtained mea-

surements and a summary of the main observations. The individual characterisation of

each system component, such as the antenna, band-pass filter, balun, and impedance

matching network, offers insight into performance and potential influence of each element

on the overall system behaviour. The antenna designed and built provided good matching

and radiation characteristics near the intended ISM frequency of 868 MHz, when com-

pared with theoretical results. The band-pass filter introduced the expected insertion

loss but providing frequency selectivity. The balun showed low differential-mode loss and

high common-mode suppression, while the impedance matching network further optimised

power transfer to the measurement system.

It is worth noticing that the antenna gain could be indirectly estimated using the

measured received power with the AD8313 RF module, the Friis equation (4.2), and the

previously characterised S11 and VSWR. The estimated gain, considering the Yagi–Uda

antenna’s approximate 10 dB rating, aligns well with the calculated results. This agree-

ment provides additional validation of the antenna performance and overall system design.

Radiation pattern measurements were performed incrementally, starting with the an-

tenna alone and adding the filter, balun, and impedance matching network. The main

lobe direction and beamwidth were generally consistent with the simulations, while minor

deviations were observed as additional components were introduced. Power levels also

varied with the inclusion of each component, as expected from insertion loss and other

practical effects.

In addition to the azimuthal radiation patterns, the three-dimensional radiation

pattern of the complete antenna system was obtained and compared with the simulated

outcome. The experimental measurement showed discrepancies with respect to the sim-

ulated model, particularly in secondary lobes, which can be attributed to environmental

factors and the presence of additional circuit components, such as the balun and the impedance matching network, that were not considered in the CST simulation. Neverthe-

less, the main lobe of the measured pattern resembles that of the simulation, highlighting

the directional characteristics expected from a Yagi–Uda antenna and allowing the iden-

tification of secondary lobes.

Overall, the collected data provide a comprehensive record of the experimental be-

haviour of the system components and their interactions. The following chapter highlights

the results, outlining their implications and guiding conclusions for the final system de-

sign.

# Chapter 5

# Conclusion and Future Work

## 5.1 Restatement of Objectives

The primary objective of this work was to develop a mechatronic and computerised system

for the measurement of antenna radiation patterns. The system was conceived with

a focus on low cost, aiming to provide an accessible and practical tool for academic

environments, particularly in courses related to telecommunications, radio frequency, and

antenna theory. By doing so, the work saw the opportunity to bridge the gap between the

high cost of commercial equipment and the educational need for hands-on demonstrations

of radiation patterns, which are often difficult to understand only in theoretical terms.

## 5.2 Summary of Achievements

The proposed system was thought, designed, implemented, and tested, providing experi-

mental radiation pattern measurements of an antenna operating at the ISM frequency of

868 MHz. The results obtained showed good agreement with simulated data, acknowledg-

ing the limitations of measurements carried out in an outdoor, non-anechoic environment.

The incremental characterisation of the system components provided a clear under-

standing of their roles:

- The antenna alone demonstrated good matching and radiation characteristics close

to the intended frequency.

- The band-pass filter introduced the expected insertion loss while improving fre-

quency selectivity.

- The balun exhibited low differential-mode loss and strong common-mode suppres-

sion, enhancing the current distribution.

- The impedance matching network improved the alignment with the 50 Ω reference,

optimising power transfer in the measurement setup.

Altogether, the system proved to be effective in reproducing the main radiation fea-

tures while remaining affordable and easy to deploy, thus offering significant pedagogical

potential.

## 5.3 Limitations

Although the objectives were met, certain limitations must be acknowledged:

- The mechanical structure does not easily accommodate larger antennas, which re-

stricts its versatility.

- The measurement process, while sufficiently accurate, requires a relatively long ac-

quisition time due to the stepwise mechanical actuation.

- The usable frequency range is constrained by the selected components and available

equipment.

- The absence of an anechoic chamber meant that measurements were subject to

multipath and environmental reflections.

These factors do not diminish the value of the system for its intended purpose but

provide guidance for future improvements.

## 5.4 Future Work

Several avenues for future development and research are suggested:

- Performing measurements in a controlled environment, such as an anechoic chamber,

in order to obtain more accurate radiation patterns.

- Extending the system to support a broader range of frequencies and different an-

tenna types.

- Reducing the acquisition time by enhancing the speed and automation of the me-

chanical rotation system, while maintaining measurement accuracy.

- Integration of a low-cost RF signal generator operating at 868 MHz, with the aim

of further reducing the dependence on expensive laboratory instruments.

- Developing a user-friendly software interface tailored for educational use, enabling

integration into laboratory classes.

## 5.5 Closing Remarks

In summary, this work demonstrated the viability of a low-cost, mechatronic antenna mea-

surement system that can support educational activities in RF and telecommunications.

The developed system fills an important gap by providing an accessible and practical tool

to visualise antenna radiation patterns, fostering greater understanding of a concept that

is otherwise abstract and difficult to convey.

Beyond the technical results, the project also contributed to the professional develop-

ment of engineering competencies. The process involved the use of CAD tools such as

SolidWorks, electromagnetic simulation software such as CST Studio Suite, and practical

experience with measurement instruments including VNAs, SAs, and many others. These

experiences are of significant value to the formation of an engineer and further strengthen

the educational impact of the work.

In addition, the project provided valuable learning experiences regarding the practical

behaviour of RF components. Unlike in DC or low-frequency circuits, where idealised

behaviour is often assumed, at higher frequencies parasitic effects and impedance mis-

matches play a crucial role. Gaining hands-on familiarity with these aspects reinforced

the theoretical concepts learned in the classroom and highlighted the importance of careful

design and characterisation in RF systems.

The outcomes presented here build a solid foundation for further improvement of

the system and open opportunities for different applications in teaching and research,

reinforcing the value of accessible tools for engineering education.

# Bibliography

[1] Vittorio Picco and Keith Martin. “An Automated Antenna Measurement System

Utilizing Wi-Fi Hardware”. In: IEEE Antennas and Propagation Magazine 53.6

(2011), pp. 173–184. doi: 10.1109/MAP.2011.6157745. (https://doi.org/10.1109/MAP.2011.6157745)

[2] Anggy Pradiftha Junfithrana et al. “Development of automated antenna radiation

pattern measurement using rotator application model to increase accuracy”. In:

2017 International Conference on Computing, Engineering, and Design (ICCED).

2017, pp. 1–5. doi: 10.1109/CED.2017.8308101. (https://doi.org/10.1109/CED.2017.8308101)

[3] Asep Barnas Simanjuntak et al. “Preliminary Design of Automatic Antenna Ra-

diation Pattern Measurement System for Antenna and Propagation Laboratory

Course”. In: Proceedings of the 5th UPI International Conference on Technical and

Vocational Education and Training (ICTVET 2018). Atlantis Press, 2019, pp. 84–87.

isbn: 978-94-6252-677-8. doi: 10.2991/ictvet-18.2019.19. (https://doi.org/10.2991/ictvet-18.2019.19) url: https:

//doi.org/10.2991/ictvet-18.2019.19.

[4] Christian W. Hearn. “Open-Source Antenna Pattern Validation using FEKO”. In:

2020 International Applied Computational Electromagnetics Society Symposium (ACES).

2020, pp. 1–2. doi: 10.23919/ACES49320.2020.9196138. (https://doi.org/10.23919/ACES49320.2020.9196138)

[5] Christian W. Hearn et al. “Open-Source Antenna Pattern Measurement System”.

In: 2020 Antenna Measurement Techniques Association Symposium (AMTA). 2020,

pp. 1–6.

[6] Matthew Finger, Taylor Hansen, and Christian Hearn. “Open-Source Antenna Pat-

tern Measurement System: SDR-based Student Research and Development”. In:

Proceedings of the GNU Radio Conference. Vol. 7. 1. 2022.

[7] Hidetsugu Yagi and Shintaro Uda. “Projector of the Sharpest Beam of Electric

Waves”. In: Proceedings of the Imperial Academy of Japan 2.2 (1926), pp. 49–52.

[8] ETSI. ETSI EN 300 220-1 V2.4.1: Short Range Devices (SRD); Radio equipment to

be used in the 25 MHz to 1 000 MHz frequency range with power levels ranging up to

500 mW; Part 1: Technical characteristics and methods of measurement. https:

//www.etsi.org/deliver/etsi_en/300200_300299/30022001/02.

04.01_60/en_30022001v020401p.pdf. (https://www.etsi.org/deliver/etsi_en/300200_300299/30022001/02.04.01_60/en_30022001v020401p.pdf) Accessed: 2025-08-10. 2012.

[9] Constantine A. Balanis. Antenna Theory: Analysis and Design. Hoboken, New Jer-

sey: John Wiley & Sons, 2016.

[10] David M. Pozar. Microwave Engineering. John Wiley & Sons, 2011. isbn: 978-0-

470-63155-3.

[11] G. Boussatour et al. “Dielectric Characterization of Polylactic Acid Substrate in

the Frequency Band 0.5–67 GHz”. In: IEEE Microwave and Wireless Components

Letters 28.5 (2018), pp. 374–376. doi: 10.1109/LMWC.2018.2812642. (https://doi.org/10.1109/LMWC.2018.2812642)

[12] F. Fiorelli et al. “Effects of Common-Mode Currents on Antenna Measurements”.

In: IEEE Antennas and Propagation Magazine 53.5 (2011), pp. 186–194. doi: 10.

1109/MAP.2011.6138483. (https://doi.org/10.1109/MAP.2011.6138483)

[13] C. Icheln, J. Krogerus, and P. Vainikainen. “Use of Balun Chokes in Small-Antenna

Radiation Measurements”. In: IEEE Transactions on Instrumentation and Measure-

ment 53.2 (2004), pp. 498–506. doi: 10.1109/TIM.2004.823322. (https://doi.org/10.1109/TIM.2004.823322)

[14] Owen Duffy. Choke Baluns and Measurement Techniques. https://owenduffy.

net/blog/?p=12740. (https://owenduffy.net/blog/?p=12740) 2022.

[15] Jerry Sevick. Transmission Line Transformers. 4th. Noble Publishing, 2001.

[16] R. Dean Straw. The ARRL Antenna Book for Radio Communications. 24th. ARRL,

2023.

[17] Seppo A. Saario. “FDTD Modelling For Wireless Communications: Antennas and

Materials”. PhD thesis. Brisbane, Australia: Griffith University, 2003.

[18] H. T. Friis. “A Note on a Simple Transmission Formula”. In: Proceedings of the IRE

34.5 (1946), pp. 254–256. doi: 10.1109/JRPROC.1946.234568. (https://doi.org/10.1109/JRPROC.1946.234568)

# Appendix A

# Data Processing Script in MATLAB

This appendix details the MATLAB script used for the processing and analysis of the

data collected during the tests. The full source code for this project is available at:

https://github.com/mauroleme/radiation-pattern-measurement

Listing A.1: MATLAB Simulation

1 clear; | % Clear variables from workspace
2 clc; | % Clear the command window

3

4 % Automatically detect the available COM ports

5 availablePorts = serialportlist("available");

6

7 if isempty(availablePorts)

8 | error("No available COM ports detected.");

9 end

10

11 % Display the list of available ports

12 disp("Available COM ports:");

13 disp(availablePorts);

14

15 % Serial port configuration

16 arduinoPort = availablePorts{1}; | % Automatically choose the first available port
17 baudRate | = 115200; | % Serial communication baudrate (bps)

18

19 % Initialize the serial port

20 serialPort | = serialport(arduinoPort, baudRate); | % Configure the serial port
21 serialPort.Timeout = 120; | % Set the timeout duration (seconds)

A1

22 configureTerminator(serialPort, "CR/LF"); | % Set the line terminator

23

24 % Wait for Arduino to initialize the serial port

25 waitForArduino(serialPort, "Ready?", ...

26 | "Waiting for Arduino Serial Port to initialize...");

27

28 % Command and wait Arduino to home the joints

29 writeline(serialPort, "Set.");

30 waitForArduino(serialPort, "Go.", ...

31 | "Waiting for Arduino to finish homing the joints...");

32

33 % Initialize the result vector

34 degreeResolution | = 5; | % Must be an integer
35 theta | = [0:degreeResolution:180, ... | % Azimuth
36 | -degreeResolution:-degreeResolution:-180+degreeResolution];
37 phi | = 0:0; | % Elevation

38 measurementValues = zeros(length(theta) + 1, ...

39 | length(phi) + 1); | % Matrix to store
| measurements for two motors

40

41 % Start sampling the antenna

42 disp("Requesting measurements...");

43 for motor2Degree = phi

44 | for motor1Degree = theta
45 | while true
46 | try
47 | % Send the angles and read the response
48 | response = safeWriteRead(serialPort, sprintf("%d,%d", ...
49 | | motor1Degree, ...
50 | | motor2Degree));

51

52 | % Convert and validate numeric data
53 | data = str2double(split(response, ’,’));
54 | if any(isnan(data))
55 | error("Invalid numeric format.");
56 | end

57

58 | % Store the mean of the first samples
59 | rowIndex = floor(mod(motor1Degree, 360) /...
60 | degreeResolution) + 1;
61 | colIndex = floor(mod(motor2Degree, 360) /...
62 | degreeResolution) + 1;
63 | measurementValues(rowIndex, colIndex) = ...
64 | mean(data(1:end));

A2

65 | break;

66

67 | catch ME
68 | fprintf("Error at angles %d,%d: %s. Response was: %s. Retrying...\n", ...
69 | motor1Degree, motor2Degree, ME.message, response);
70 | pause(0.1);
71 | end
72 | end
73 | end

74 end

75

76 clear serialPort; | % Close the serial port

77

78 % Map theta [-180,180] to [0,360]

79 mappedAngles | = mod(theta, 360);

80 [sortedAngles, sortIdx] = sort(mappedAngles);

81 sortedMeasurementValues = measurementValues(sortIdx);

82

83 % Close the circle for polarplot continuity

84 fullAnglesClosed | = [sortedAngles, sortedAngles(1)];

85 MeasurementValuesClosed = [sortedMeasurementValues, ...

86 | sortedMeasurementValues(1)];

87

88 % Rotate plot by +270 deg so that 180 deg becomes 90 deg (top)

89 rotatedAngles = mod(fullAnglesClosed + 270, 360);

90

91 % Plot

92 figure;

93 polarplot(deg2rad(rotatedAngles), MeasurementValuesClosed, ’LineWidth’, 1.5);

94 set(gca, ’ThetaZeroLocation’,’top’,’ThetaDir’,’counterclockwise’);

95 rlim([-75 0]);

96 title(’Antenna Radiation Pattern’);

97 text(-0.2, -0.9, ’Azimuth’, ’Units’, ’normalized’);

98 text(-0.9, -0.2, ’Gain (dB)’, ’Units’, ’normalized’);

99

100 disp("Collected measurements:");

101 disp(MeasurementValuesClosed(:));

102

103 % Function for safe serial communication with error handling

104 function response = safeWriteRead(serialPort, message)

105 | try
106 | if nargin > 1
107 | writeline(serialPort, message);
108 | end

A3

109

110 | response = readline(serialPort);
111 | if startsWith(response, "Error: ")
112 | error("Arduino error: %s", extractAfter(response, "Error: "));
113 | end
114 | catch ME
115 | error("Communication error: %s", ME.message);
116 | end

117 end

118

119 function waitForArduino(serialPort, expectedResponse, message)

120 | disp(message);
121 | while true
122 | try
123 | response = safeWriteRead(serialPort);
124 | if strcmp(response, expectedResponse)
125 | break;
126 | end
127 | catch
128 | pause(0.5);
129 | end
130 | end

131 end

A4

# Appendix B

# Main Control System Code

# (Arduino)

This appendix presents the source code developed for the main control of the system using

the Arduino Uno. The full source code for this project is available at:

https://github.com/mauroleme/radiation-pattern-measurement

Listing B.1: Arduino main control

1 /*

2 | * File | : main.ino
3 | * Author | : Mauro Leme
4 | * Date | : December 12, 2024
5 | * Purpose | : Main control loop for the robot’s joint system.
6 | * | Handles serial communication, processes motor rotation
7 | * | requests, captures sensor data, and manages state transitions.
8 | *
9 | * License | : MIT License
10 | *
11 | * Copyright (c) 2024 mauroleme
12 | *
13 | * Permission is hereby granted, free of charge, to any person obtaining a copy
14 | * of this software and associated documentation files (the "Software"), to deal
15 | * in the Software without restriction, including without limitation the rights
16 | * to use, copy, modify, merge, publish, distribute, sublicense, and/or sell
17 | * copies of the Software, and to permit persons to whom the Software is
18 | * furnished to do so, subject to the following conditions:

B1

19 | *
20 | * The above copyright notice and this permission notice shall be included in all
21 | * copies or substantial portions of the Software.
22 | *
23 | * THE SOFTWARE IS PROVIDED "AS IS", WITHOUT WARRANTY OF ANY KIND, EXPRESS OR
24 | * IMPLIED, INCLUDING BUT NOT LIMITED TO THE WARRANTIES OF MERCHANTABILITY,
25 | * FITNESS FOR A PARTICULAR PURPOSE AND NONINFRINGEMENT. IN NO EVENT SHALL THE
26 | * AUTHORS OR COPYRIGHT HOLDERS BE LIABLE FOR ANY CLAIM, DAMAGES OR OTHER
27 | * LIABILITY, WHETHER IN AN ACTION OF CONTRACT, TORT OR OTHERWISE, ARISING FROM,
28 | * OUT OF OR IN CONNECTION WITH THE SOFTWARE OR THE USE OR OTHER DEALINGS IN THE
29 | * SOFTWARE.
30 | */

31

32 #include <Arduino.h>

33 #include "joint.h"

34

35

36 // ===================================

37 // Configuration Constants

38 // ===================================

39

40 #define J1_STEP_PIN 6

41 #define J1_DIR_PIN | 7
42 #define J1_EN_PIN | 8

43 #define J1_HALL_PIN A0

44

45 #define J2_STEP_PIN 5

46 #define J2_DIR_PIN | 4
47 #define J2_EN_PIN | 12

48 #define J2_HALL_PIN A1

49

50 #define RF_PIN | A3

51

52

53 const size_t | SAMPLES | = 100;
54 const uint16_t BUFFER_SIZE | = 32;
55 const uint32_t SAMPLE_TIME | = 1000; // Time in milliseconds
56 const uint32_t CAPTURE_TIME = 100; | // Time in milliseconds

57

58 // ===================================

59 // Motor Control Structures

60 // ===================================

61

62 typedef enum { LISTEN = 0, PROCESS = 1 } mode_t;

B2

63

64 Joint joint1 =

65 {

66 | J1_STEP_PIN,
67 | J1_DIR_PIN,
68 | J1_EN_PIN,
69 | J1_HALL_PIN

70 };

71

72 Joint joint2 =

73 {

74 | J2_STEP_PIN,
75 | J2_DIR_PIN,
76 | J2_EN_PIN,
77 | J2_HALL_PIN

78 };

79

80

81 // ===================================

82 // Function Prototypes

83 // ===================================

84

85 void capture_sensor_data(uint16_t *sensor_values, size_t samples);

86 void transmit_sensor_data(uint16_t *sensor_values, size_t samples);

87 inline void sleep_joints_after_timeout();

88 inline void log_error(const char *message);

89

90

91 void setup()

92 {

93 | // Setting up the serial port
94 | Serial.setTimeout(1000);
95 | Serial.begin(115200);
96 | while (!Serial);

97

98 | Serial.println("Ready?");

99

100 | // Wait for MATLAB command for initialization
101 | {
102 | char buffer[10] = { 0 };
103 | while (1)
104 | {
105 | if (Serial.available() > 0)
106 | {

B3 size_t len = Serial.readBytesUntil(’\n’, buffer,

sizeof(buffer));

buffer[len - 1] = ’\0’;

if (strncmp(buffer, "Set.", 4) == 0)

break;

}

}

}

// Setting up the PINs

joint1.Init();

joint2.Init();

pinMode(RF_PIN, INPUT);

// Setting up the usteps to degree conversion

joint1.SetStepsPerDegree(56);

joint2.SetStepsPerDegree(16); // By default, it’s this value

// Activate the motors

joint1.EnableMotor();

joint2.EnableMotor();

// Set M1 to the origin

if (joint1.HomeMotor() == false)

{

joint1.DisableMotor();

log_error("Failed to detect the magnet center of MOTOR 1");

while (true);

}

// Set M2 to the origin

/*

if (joint2.HomeMotor() == false)

{

joint2.DisableMotor();

log_error("Failed to detect the magnet center of MOTOR 2");

while (true);

}

*/

// Signal MATLAB to begin requesting sample data

Serial.println("Go.");

150 }

B4

151

152 void loop()

153 {

154 | /* State machine to handle different modes based on serial input:
155 | * | - LISTEN | : Waiting for serial input. Once the input is received,
156 | * | | it switches to the next mode.
157 | * | - PROCESS : Rotates the motors and samples the sensor values. After
158 | * | | completing, it sends the values via serial port and
159 | * | | resets to LISTEN.
160 | */
161 | static int32_t target_angle_joint1;
162 | static int32_t target_angle_joint2;
163 | static char | buffer[BUFFER_SIZE];

164

165 | static mode_t mode = LISTEN;
166 | if (mode == LISTEN)
167 | {
168 | if (Serial.available() > 0)
169 | {
170 | int32_t temp_target_angle_joint1;
171 | int32_t temp_target_angle_joint2;
172 | | size_t | len = Serial.readBytesUntil(’\n’, buffer, BUFFER_SIZE - 1);
173 | buffer[len - 1] = ’\0’;

174

175 | if (sscanf(buffer, "%ld,%ld", &temp_target_angle_joint1,
176 | | | &temp_target_angle_joint2) == 2)
177 | | {
178 | target_angle_joint1 = temp_target_angle_joint1;
179 | target_angle_joint2 = temp_target_angle_joint2;

180

181 | mode = PROCESS;
182 | | }
183 | | else
184 | | {
185 | log_error("Invalid input format");
186 | | }
187 | }
188 | }
189 | else if (mode == PROCESS)
190 | {
191 | joint1.RotateMotor(target_angle_joint1);
192 | joint2.RotateMotor(target_angle_joint2);

193

194 | double sensor_values[SAMPLES] = { 0 };

B5

195 | capture_sensor_data(sensor_values, SAMPLES, SAMPLE_TIME, CAPTURE_TIME);
196 | transmit_sensor_data(sensor_values, SAMPLES);

197

198 | mode = LISTEN;
199 | }
200 | else
201 | {
202 | log_error("Unknown mode");

203

204 | mode = LISTEN;
205 | }

206

207 | sleep_joints_after_timeout();

208 }

209

210 void capture_sensor_data(double *sensor_values, size_t samples,

211 | uint32_t sample_time, uint32_t capture_time)

212 {

213 | // Standby
214 | delay(sample_time - capture_time);

215

216 | size_t capture_time_per_sample = capture_time / samples;
217 | for (size_t i = 0; i < samples; i++)
218 | {
219 | int | raw_rf_value = analogRead(RF_PIN);
220 | double power_dBm | = (double)raw_rf_value * 0.2722 - 97.115;

221

222 | sensor_values[i] = power_dBm;
223 | delay(capture_time_per_sample);
224 | }

225 }

226

227 void transmit_sensor_data(double *sensor_values, size_t samples)

228 {

229 | char | buffer[8 * samples];
230 | size_t index = 0;

231

232 | for (size_t i = 0; i < samples; i++)
233 | {
234 | char temp[10];
235 | dtostrf(sensor_values[i], 5, 2, temp);
236 | index += sprintf(&buffer[index], "%s%s", temp,
237 | (i < samples - 1) ? "," : "");
238 | }

B6

239

240 | Serial.println(buffer);

241 }

242

243 inline void sleep_joints_after_timeout()

244 {

245 | joint1.SleepMotorAfterTimeOut();
246 | joint2.SleepMotorAfterTimeOut();

247 }

248

249 inline void log_error(const char *message)

250 {

251 | char error[128];
252 | snprintf(error, sizeof(error), "Error: %s.", message);
253 | Serial.println(error);

254 }

B7

# Appendix C

# Joint Class Header File (C++)

This appendix presents the header file developed for the implementation of the Joint

class used in the Arduino-based control system. The full source code for this project is

available at: https://github.com/mauroleme/radiation-pattern-measurement

Listing C.1: Joint class header file

1 /*

2 | * File | : joint.h
3 | * Author | : Mauro Leme
4 | * Date | : March 31, 2024
5 | * Purpose | : Defines the data structures and function prototypes
6 | * | for controlling a robotic joint using a stepper motor.
7 | * | Includes motor control, direction handling, homing,
8 | * | and hall sensor reading.
9 | *
10 | * License | : MIT License
11 | *
12 | * Copyright (c) 2024 mauroleme
13 | *
14 | * Permission is hereby granted, free of charge, to any person obtaining a copy
15 | * of this software and associated documentation files (the "Software"), to deal
16 | * in the Software without restriction, including without limitation the rights
17 | * to use, copy, modify, merge, publish, distribute, sublicense, and/or sell
18 | * copies of the Software, and to permit persons to whom the Software is
19 | * furnished to do so, subject to the following conditions:
20 | *
21 | * The above copyright notice and this permission notice shall be included in all

C1

22 | * copies or substantial portions of the Software.
23 | *
24 | * THE SOFTWARE IS PROVIDED "AS IS", WITHOUT WARRANTY OF ANY KIND, EXPRESS OR
25 | * IMPLIED, INCLUDING BUT NOT LIMITED TO THE WARRANTIES OF MERCHANTABILITY,
26 | * FITNESS FOR A PARTICULAR PURPOSE AND NONINFRINGEMENT. IN NO EVENT SHALL THE
27 | * AUTHORS OR COPYRIGHT HOLDERS BE LIABLE FOR ANY CLAIM, DAMAGES OR OTHER
28 | * LIABILITY, WHETHER IN AN ACTION OF CONTRACT, TORT OR OTHERWISE, ARISING FROM,
29 | * OUT OF OR IN CONNECTION WITH THE SOFTWARE OR THE USE OR OTHER DEALINGS IN THE
30 | * SOFTWARE.
31 | */

32

33 #ifndef JOINT_H

34 #define JOINT_H

35

36 #include <Arduino.h>

37

38

39 // ===================================

40 // Macros

41 // ===================================

42

43 #define DEG_TO_STEP(deg) ((deg) * steps_per_degree)

44 #define STEP_TO_DEG(step) ((step) / steps_per_degree)

45

46

47 // ===================================

48 // Configuration Constants

49 // ===================================

50

51 const uint16_t DELTA_T | = 5000;
52 const uint16_t HOMING_DELAY | = 1000;

53 const uint32_t MOTOR_SLEEP_TIMEOUT = 10000000;

54

55

56 // ===================================

57 // Types

58 // ===================================

59

60 typedef enum { CW = LOW, CCW = HIGH } motor_direction;

61

62

63 // ===================================

64 // Class Declaration

65 // ===================================

C2

66

67 class Joint

68 {

69 | public:
70 | Joint(uint8_t step_pin, uint8_t dir_pin,
71 | uint8_t en_pin, uint8_t hall_pin)
72 | : step_pin_(step_pin), dir_pin_(dir_pin)
73 | , en_pin_(en_pin), hall_pin_(hall_pin)
74 | , angle(0), motor_last_active(0), default_direction(CW)
75 | , steps_per_degree(16)
76 | {}
77 | void Init();
78 | void EnableMotor();
79 | void DisableMotor();
80 | void SetDefaultMotorDirection(const motor_direction target_direction);
81 | motor_direction GetDefaultMotorDirection();
82 | void RotateMotor(const int32_t target_angle);
83 | void SleepMotorAfterTimeOut();
84 | bool HomeMotor();
85 | void SetStepsPerDegree(const uint16_t target_steps_per_degree);
86 | uint16_t GetStepsPerDegree();
87 | bool ReadHall();

88

89 | private:
90 | void SetMotorDirection(const motor_direction target_direction);
91 | void StepMotor(const motor_direction target_direction);

92

93 | // ===================================
94 | // Joint State
95 | // ===================================

96

97 | uint16_t | steps_per_degree;
98 | int32_t | angle;
99 | uint32_t | motor_last_active;
100 | motor_direction default_direction;

101

102 | // ===================================
103 | // Hardware Pins
104 | // ===================================

105

106 | uint8_t | step_pin_;
107 | uint8_t | dir_pin_;
108 | uint8_t | en_pin_;
109 | uint8_t | hall_pin_;

C3

110 };

111

112 #endif // JOINT_H

C4

# Appendix D

# Joint Class Implementation File

(C++)

This appendix presents the implementation file developed for the Joint class used in the

Arduino-based control system. The full source code for this project is available at:

https://github.com/mauroleme/radiation-pattern-measurement

Listing D.1: Joint class implementation file

1 /*

2 | * File | : joint.cpp
3 | * Author | : Mauro Leme
4 | * Date | : March 31, 2024
5 | * Purpose | : Implements the functions declared in ‘joint.h’ to control
6 | * | a robotic joint. Provides motor movement, homing routines,
7 | * | direction control and sensor reading functionality.
8 | *
9 | * License | : MIT License
10 | *
11 | * Copyright (c) 2024 mauroleme
12 | *
13 | * Permission is hereby granted, free of charge, to any person obtaining a copy
14 | * of this software and associated documentation files (the "Software"), to deal
15 | * in the Software without restriction, including without limitation the rights
16 | * to use, copy, modify, merge, publish, distribute, sublicense, and/or sell
17 | * copies of the Software, and to permit persons to whom the Software is
18 | * furnished to do so, subject to the following conditions:

D1

19 | *
20 | * The above copyright notice and this permission notice shall be included in all
21 | * copies or substantial portions of the Software.
22 | *
23 | * THE SOFTWARE IS PROVIDED "AS IS", WITHOUT WARRANTY OF ANY KIND, EXPRESS OR
24 | * IMPLIED, INCLUDING BUT NOT LIMITED TO THE WARRANTIES OF MERCHANTABILITY,
25 | * FITNESS FOR A PARTICULAR PURPOSE AND NONINFRINGEMENT. IN NO EVENT SHALL THE
26 | * AUTHORS OR COPYRIGHT HOLDERS BE LIABLE FOR ANY CLAIM, DAMAGES OR OTHER
27 | * LIABILITY, WHETHER IN AN ACTION OF CONTRACT, TORT OR OTHERWISE, ARISING FROM,
28 | * OUT OF OR IN CONNECTION WITH THE SOFTWARE OR THE USE OR OTHER DEALINGS IN THE
29 | * SOFTWARE.
30 | */

31

32 #include "joint.h"

33

34

35 // ===================================

36 // Setup

37 // ===================================

38

39 void Joint::Init()

40 {

41 | // Configure motor pins as output
42 | *portModeRegister(digitalPinToPort(step_pin_)) | |=
43 | digitalPinToBitMask(step_pin_);
44 | *portModeRegister(digitalPinToPort(dir_pin_)) | |=
45 | digitalPinToBitMask(dir_pin_);
46 | *portModeRegister(digitalPinToPort(en_pin_)) | |=
47 | digitalPinToBitMask(en_pin_);

48

49 | // Configure hall sensor pin as input
50 | *portModeRegister(digitalPinToPort(hall_pin_)) | &=
51 | ~digitalPinToBitMask(hall_pin_);
52 | *portOutputRegister(digitalPinToPort(hall_pin_)) |=
53 | digitalPinToBitMask(hall_pin_);

54 }

55

56

57 // ==============================

58 // Motor Toggling

59 // ==============================

60

61 void Joint::EnableMotor()

62 {

D2

63 | *portOutputRegister(digitalPinToPort(en_pin_)) | &=
64 | ~digitalPinToBitMask(en_pin_);

65 }

66

67 void Joint::DisableMotor()

68 {

69 | *portOutputRegister(digitalPinToPort(en_pin_)) | |=
70 | digitalPinToBitMask(en_pin_);

71 }

72

73

74 // ==============================

75 // Motor Direction

76 // ==============================

77

78 void Joint::SetDefaultMotorDirection(const motor_direction target_direction)

79 {

80 | default_direction = target_direction;

81 }

82

83 motor_direction Joint::GetDefaultMotorDirection()

84 {

85 | return default_direction;

86 }

87

88 void Joint::SetMotorDirection(const motor_direction target_direction)

89 {

90 | *portOutputRegister(digitalPinToPort(dir_pin_)) =
91 | (target_direction == CW) ?
92 | (*portOutputRegister(digitalPinToPort(dir_pin_)) |
93 | digitalPinToBitMask(dir_pin_)) :
94 | (*portOutputRegister(digitalPinToPort(dir_pin_)) &
95 | ~digitalPinToBitMask(dir_pin_));

96

97 }

98

99

100 // ==============================

101 // Motor Control

102 // ==============================

103

104 void Joint::RotateMotor(int32_t target_angle)

105 {

106 | target_angle | %= 360;

D3

107 | int32_t | diff | = target_angle - angle;
108 | uint32_t | steps | = DEG_TO_STEP(abs(diff));
109 | motor_direction direction | = (diff >= 0) ? default_direction :
110 | !default_direction;

111

112 | for (uint32_t i = 0; i < steps; i++)
113 | {
114 | StepMotor(direction);
115 | }
116 | angle = target_angle;

117 }

118

119 void Joint::SleepMotorAfterTimeOut()

120 {

121 | if (micros() - motor_last_active >= MOTOR_SLEEP_TIMEOUT)
122 | {
123 | DisableMotor();
124 | }

125 }

126

127 void Joint::StepMotor(const motor_direction target_direction)

128 {

129 | EnableMotor();
130 | SetMotorDirection(target_direction);

131

132 | *portOutputRegister(digitalPinToPort(step_pin_)) &=
133 | ~digitalPinToBitMask(step_pin_);
134 | delayMicroseconds(DELTA_T);
135 | *portOutputRegister(digitalPinToPort(step_pin_)) |=
136 | digitalPinToBitMask(step_pin_);
137 | delayMicroseconds(DELTA_T);

138

139 | motor_last_active = micros();

140 }

141

142

143 // ==============================

144 // Motor Homing

145 // ==============================

146

147 bool Joint::HomeMotor()

148 {

149 | const uint16_t MAX_HOMING_STEPS = DEG_TO_STEP(360);
150 | uint16_t | steps_completed | = 0;

D4

151 | uint16_t | start_step | = 0;
152 | uint16_t | end_step;

// Case where the sensor is already detecting the magnet, so the motor

// rotates backwards until it doesn’t detect it anymore

while (ReadHall())

{

StepMotor((motor_direction)!default_direction);

}

// Find the start and end of the magnet

do

{

StepMotor(default_direction);

steps_completed++;

delayMicroseconds(HOMING_DELAY);

bool hall_state = ReadHall();

if (hall_state && start_step == 0)

{

start_step = steps_completed;

}

else if (!hall_state && start_step != 0)

{

end_step = steps_completed;

break;

}

}

while (steps_completed < MAX_HOMING_STEPS);

// If the magnet was not found, throw an error

if (steps_completed == MAX_HOMING_STEPS)

{

return false;

}

// Move to the center of the magnet

uint16_t central_steps = (end_step - start_step) >> 1;

while (central_steps--)

{

StepMotor((motor_direction)!default_direction);

delayMicroseconds(HOMING_DELAY);

}

D5

195

196 | // Define angle as the origin
197 | angle = 0;

198

199 | return true;

200 }

201

202

203 // ==============================

204 // Motor Steps per Degree

205 // ==============================

206

207 void Joint::SetStepsPerDegree(const uint16_t target_steps_per_degree)

208 {

209 | steps_per_degree = target_steps_per_degree;

210 }

211

212 uint16_t Joint::GetStepsPerDegree()

213 {

214 | return steps_per_degree;

215 }

216

217

218 // ==============================

219 // Hall Effect Sensor Reading

220 // ==============================

221

222 bool Joint::ReadHall()

223 {

224 | return !(*portInputRegister(digitalPinToPort(hall_pin_)) &
225 | digitalPinToBitMask(hall_pin_));

226 }

D6

# Appendix E

# MATLAB Code for Balun

# Calculation

This appendix presents the MATLAB source code developed to calculate the number of

turns performed by the balun during the experiment.

Listing E.1: MATLAB code for balun turns calculation

1 % Design of a choke balun

2 % Coaxial cable RG174 (2.6 mm diameter)

3 % Inductance formula for a single-layer coil:

4 % | 4 * pi^2 * N^2 * r^2
5 % | Ls = -------------------------- * K
6 % | l

7 %

8 % where:

9 % | l = N * d_cable | -> coil length
10 % | K = f(l/D), with D = 2r

11 %

12 % Reference: https://coil32.net/single-layer-coil.html

13

14 Lt = 550; | % Target inductance: 550 nH
15 d_cable = 0.26; | % Cable diameter in cm (2.6 mm)
16 N = 1:10; | % Number of turns tested (1 to 10)
17 l = N * d_cable; | % Coil length (cm)
18 D = 1.8; | % Internal coil diameter (cm)

19

20 % Inductance calculation (nH)

E1

21 L = 2 * pi * D .* N.^2 .* ( ...

22 | log(1 + (pi * D) ./ (2 * l)) + ...
23 | 1 ./ (2.3004 + 3.437 * (l ./ D) + ...
24 | 1.7636 * (l ./ D).^2 - ...
25 | (0.47 ./ (0.755 + D ./ l).^1.44)) );

26

27 % Plot results

28 plot(N, L, N, ones(size(N)) * Lt, ’r--’)

29 xlabel(’Number of turns (N)’)

30 ylabel(’Inductance (nH)’)

31 title(’Choke Balun Inductance vs. Number of Turns’)

32 legend(’Calculated inductance’, ’Target inductance’)

33 grid on

E2
