mauroleme/radiation-pattern-measurement-system/docs/report/latex/chapters/agradecimento.tex

%\thispagestyle{empty}

%\lipsum[1]

%\vfill
%\pagebreak
%\mbox{}
%\vfill
%\pagebreak

%---------------------------------------------------------------------------------------------

The completion of this work would not have been possible without the contribution and support of many
people and institutions that, in different ways, have marked this stage of my academic life.

Firstly, I would like to express my deepest gratitude to my supervisor and creator of this project, Professor João Paulo Coelho, PhD, for his scientific guidance, constant patience, sharing of knowledge, and dedication, which was reflected not only in the development of this work, but also in my personal and professional growth.

I would also like to express my gratitude to João Alexandre Batista Coelho, MSc, Laiany Suganuma Brancalião, MSc, and Mariano Alvarez, MSc, for their close support during the different stages of the work, for their constructive suggestions and for their contributions, not only technical but also personal, being present on various fronts of the project and offering friendship, encouragement and continuous collaboration.

I would also like to thank Professor José Alexandre de Carvalho Gonçalves, PhD, for his availability and for facilitating access to the IPB laboratories, often outside normal working hours, as well as for his advice, which greatly enriched this journey.

To CeDRI and ESTIG, for their institutional support and provision of essential resources, and to MORE CoLAB, in the person of Higor Rosse, for his collaboration in the production of the PCBs.

To my classmates and colleagues from other IPB courses, for their encouragement and support, and to the management of the Electrical and Computer Engineering degree programme, for their dedication, guidance, and motivation conveyed throughout my studies.

Last but not least, I would like to express my heartfelt gratitude to my mother, my brothers and sisters, and my friends for their unconditional encouragement, patience, and understanding, which were indispensable in helping me achieve this goal. I would also like to give special thanks to Thiago and Dayana, who have been a fundamental pillar in my life over the years, offering constant support and true friendship. A deep and loving thank you to Mary, my adoptive mother, who always believed in me, even when I doubted myself, always encouraging me
not only in my studies, but also in becoming a better person. If I am who I am today, I owe it in large part to her unwavering confidence and the support she never failed to give me.
