mauroleme/radiation-pattern-measurement-system/docs/report/latex/chapters/apendice01.tex

\chapter{Data Processing Script in MATLAB}
\label{apendice1}

This appendix details the MATLAB script used for the processing and analysis of the data collected during the tests. The full source code for this project is available at:\\ https://github.com/mauroleme/radiation-pattern-measurement

\lstinputlisting[language=Matlab, caption={MATLAB Simulation}, label={lst:matlab_sim}]{codes/ArduinoCommunication.m}
