mauroleme/radiation-pattern-measurement-system/hardware/cad/CST_Studio_suite_Yagi-Uda_868MHz_3Dprint.pdf

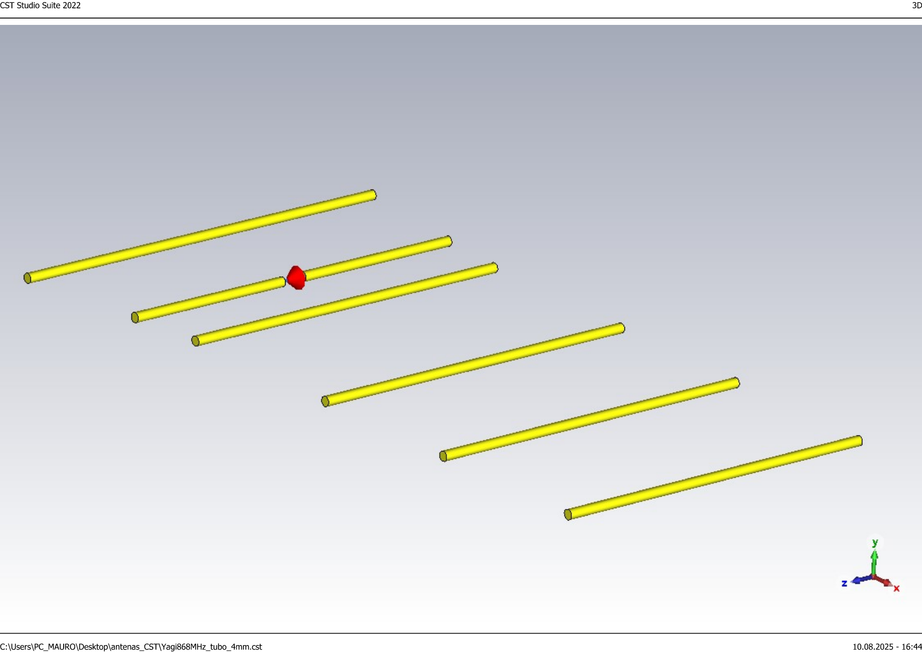
[picture p89: page 1]
