mauroleme/radiation-pattern-measurement-system/docs/report/latex/Imagens/Antena Recetora/Caraterização VNA/Fig2.png

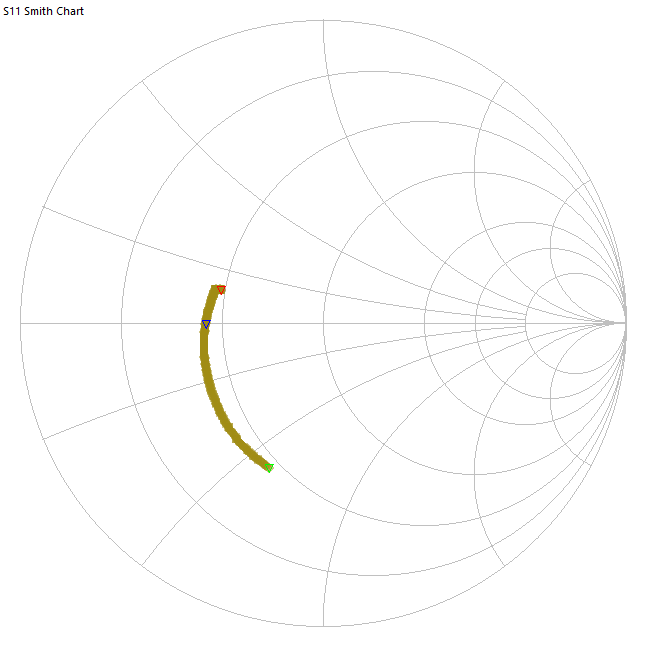
docs/report/latex/Imagens/Antena Recetora/Caraterização VNA/Fig2.png
