mauroleme/radiation-pattern-measurement-system/docs/report/latex/Imagens/Antena Recetora/Caraterização VNA/Fig5.png

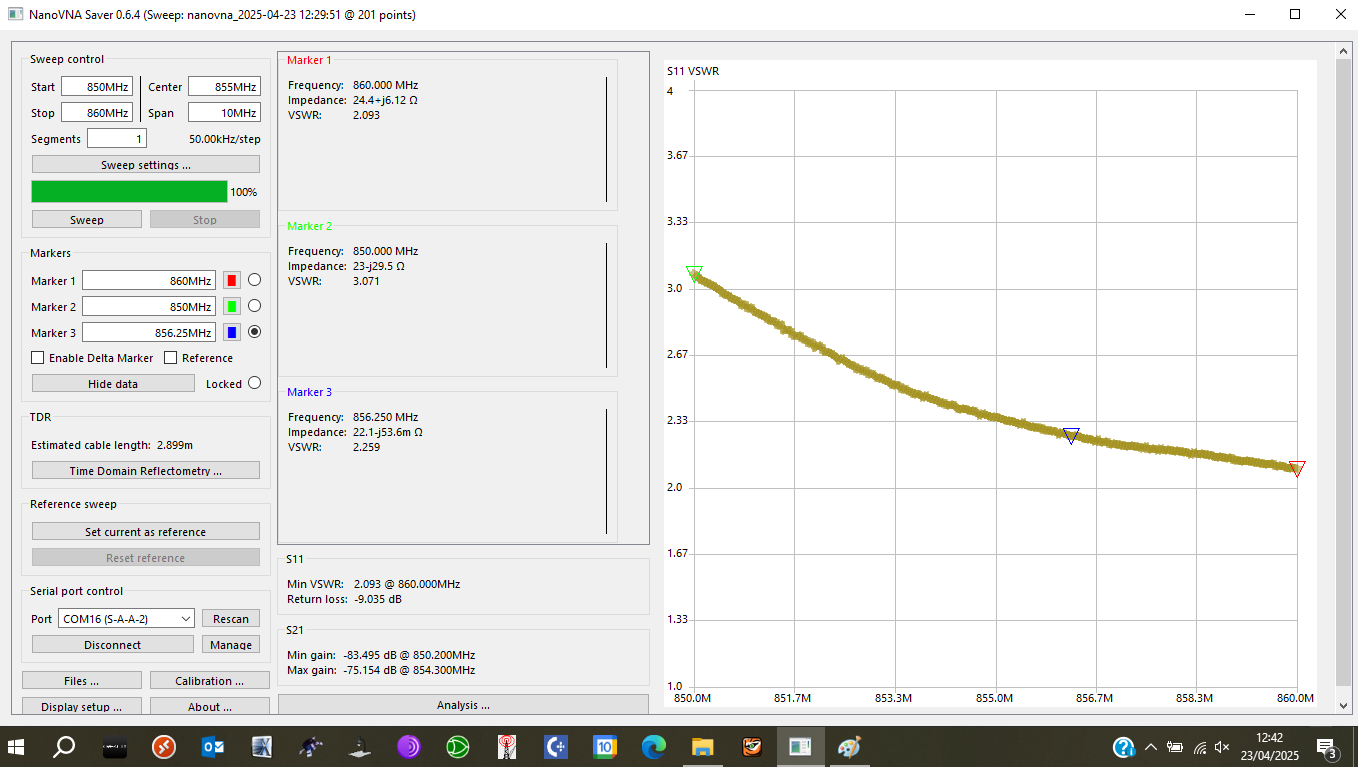
docs/report/latex/Imagens/Antena Recetora/Caraterização VNA/Fig5.png
