mauroleme/radiation-pattern-measurement-system/docs/report/latex/Imagens/carcaterização do PCB/antena sem pcb - tx.png

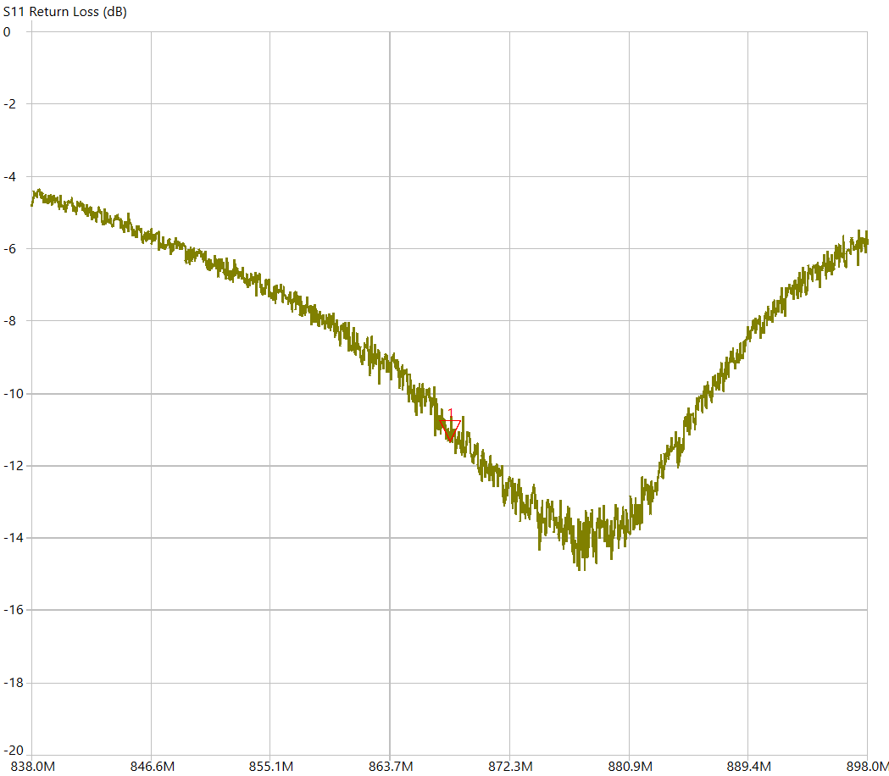
docs/report/latex/Imagens/carcaterização do PCB/antena sem pcb - tx.png
