mauroleme/radiation-pattern-measurement-system/docs/report/latex/Imagens/carcaterização do PCB/S11 e S21 v1.png

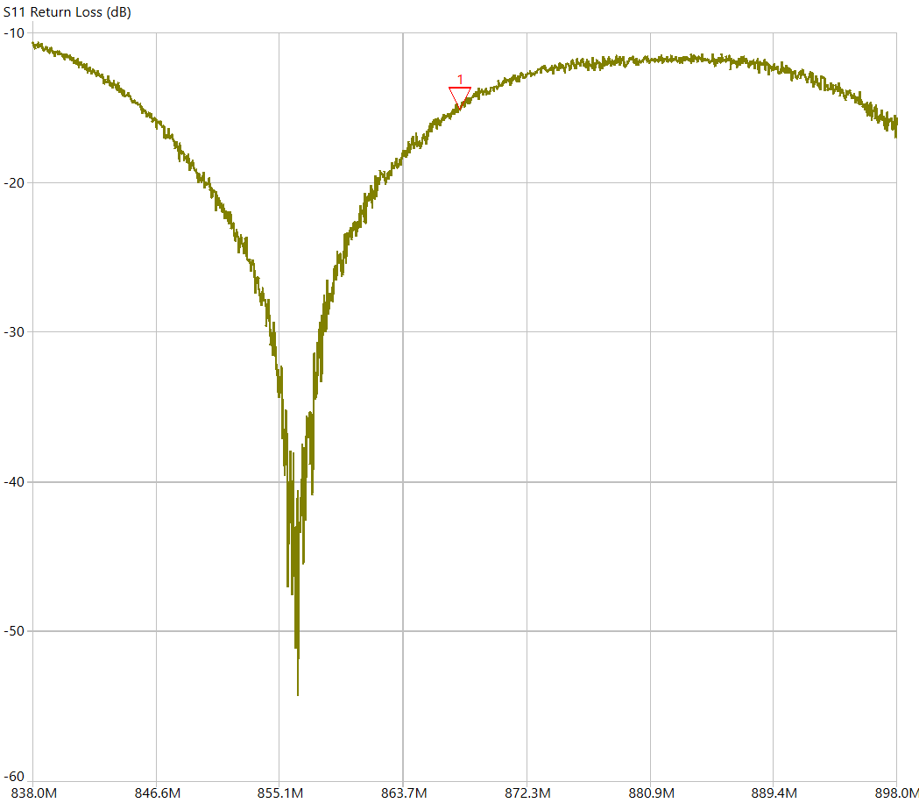
docs/report/latex/Imagens/carcaterização do PCB/S11 e S21 v1.png
