mauroleme/radiation-pattern-measurement-system/docs/report/latex/Imagens/carcaterização do PCB/S11 e S21 v3 completo.png

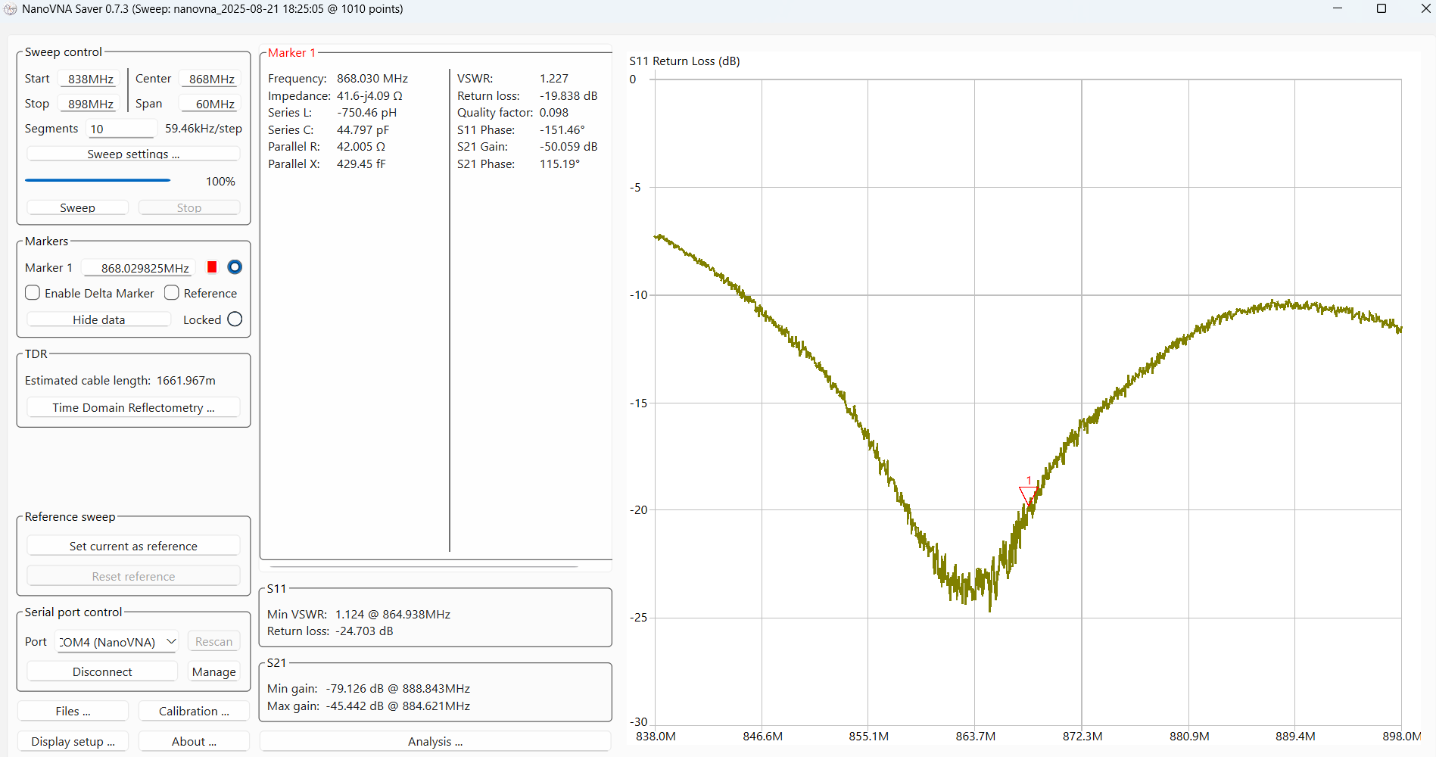
docs/report/latex/Imagens/carcaterização do PCB/S11 e S21 v3 completo.png
