mauroleme/radiation-pattern-measurement-system/docs/report/latex/Imagens/carcaterização do PCB/S11 e S21 v4 mais um L de 3.3 em serie.png

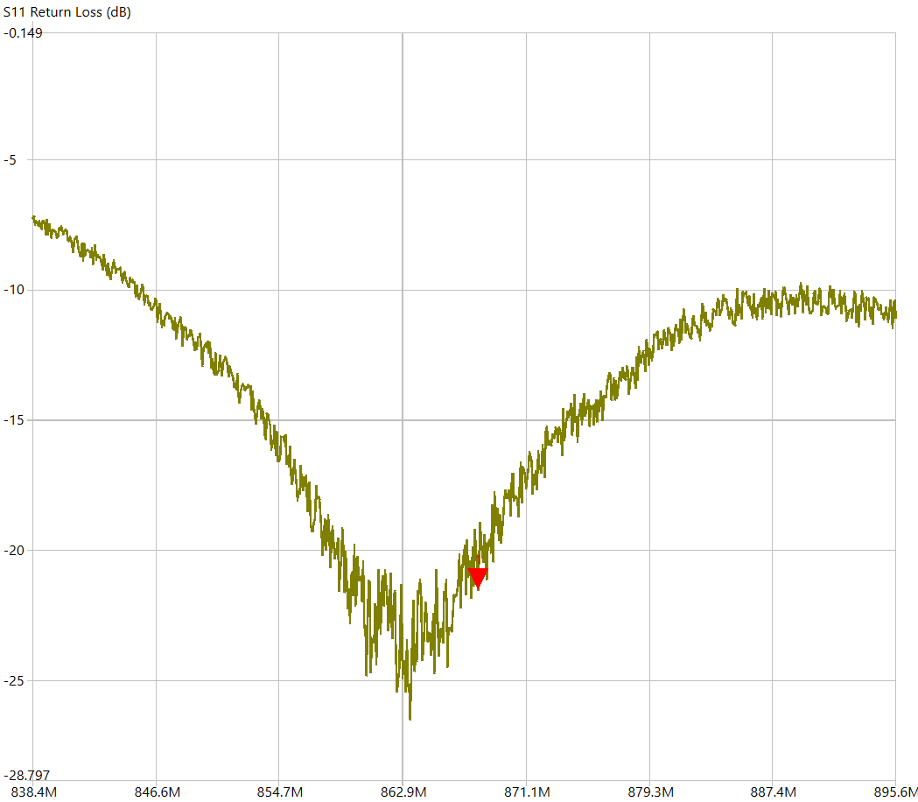
docs/report/latex/Imagens/carcaterização do PCB/S11 e S21 v4 mais um L de 3.3 em serie.png
