mauroleme/radiation-pattern-measurement-system/docs/report/latex/Imagens/carcaterização do PCB/smith chart v2 completo 856 MHz.png

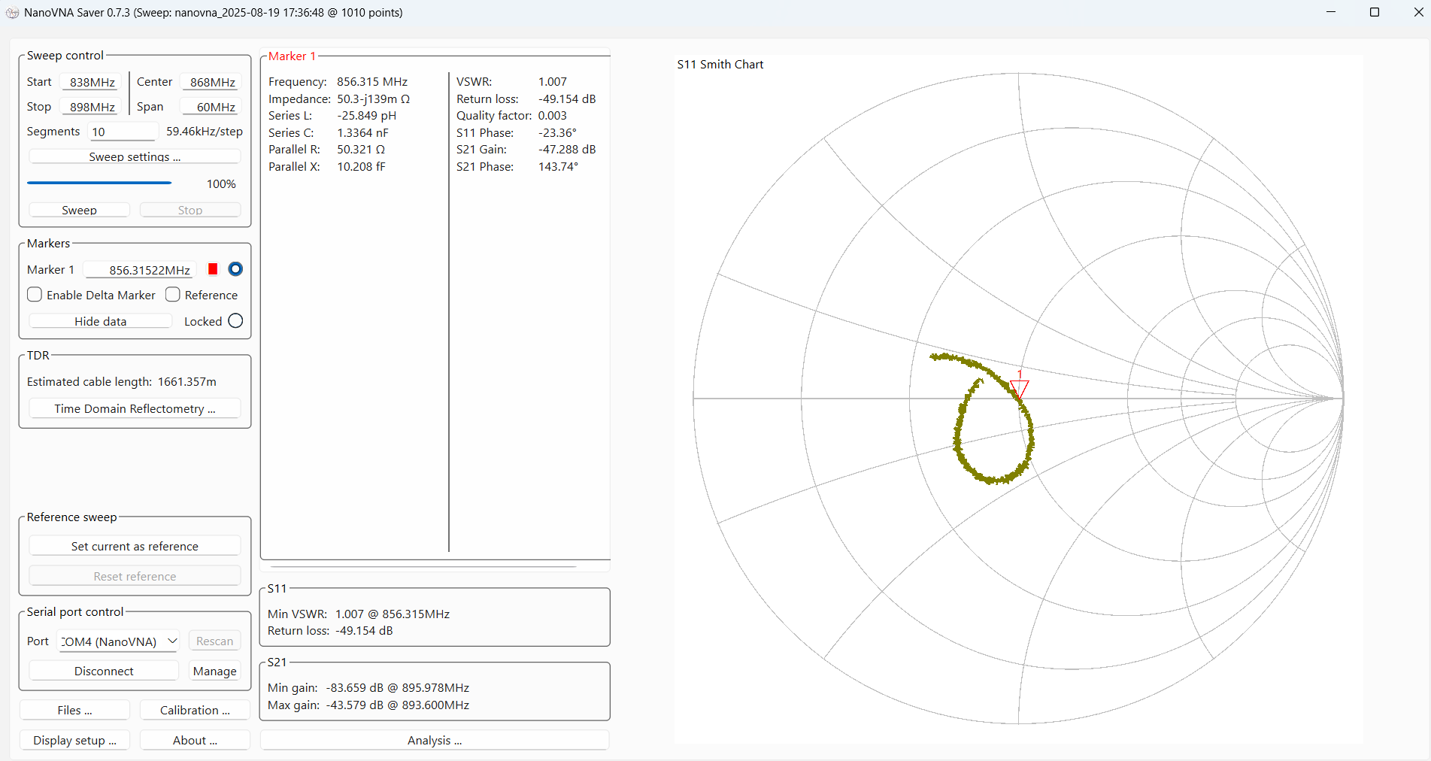
docs/report/latex/Imagens/carcaterização do PCB/smith chart v2 completo 856 MHz.png
