mauroleme/radiation-pattern-measurement-system/docs/report/latex/Imagens/carcaterização do PCB/smith chart v3.png

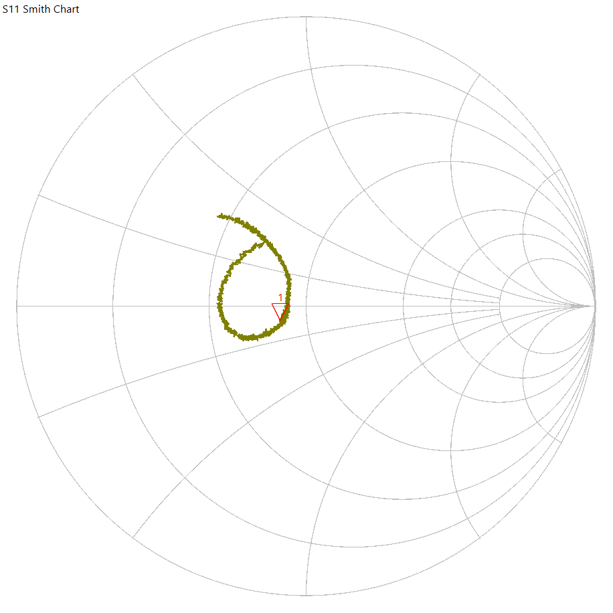
docs/report/latex/Imagens/carcaterização do PCB/smith chart v3.png
