mauroleme/radiation-pattern-measurement-system/docs/report/latex/Imagens/filtro/fig2.png

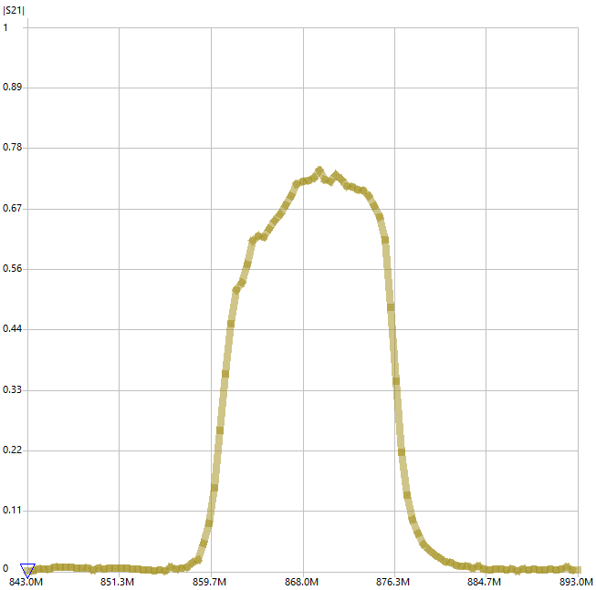
docs/report/latex/Imagens/filtro/fig2.png
