mauroleme/radiation-pattern-measurement-system/docs/report/latex/Imagens/touchstone_flow.png

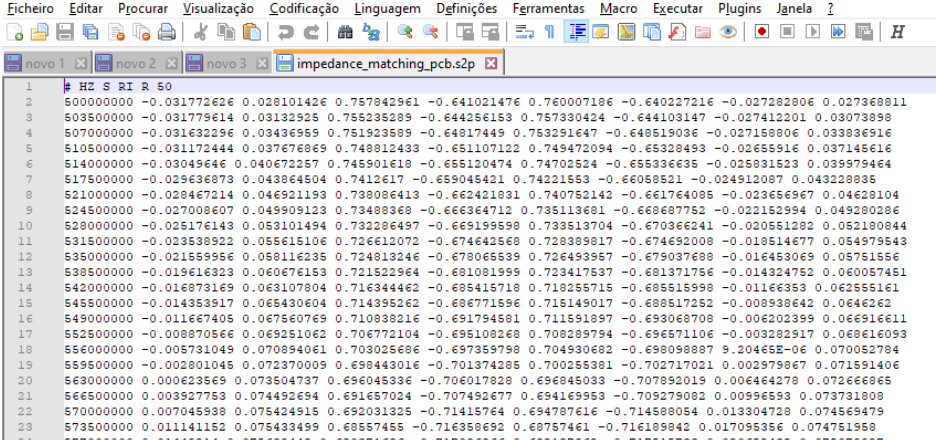
docs/report/latex/Imagens/touchstone_flow.png
