mauroleme/radiation-pattern-measurement-system/hardware/balun/photos/balun3.jpg

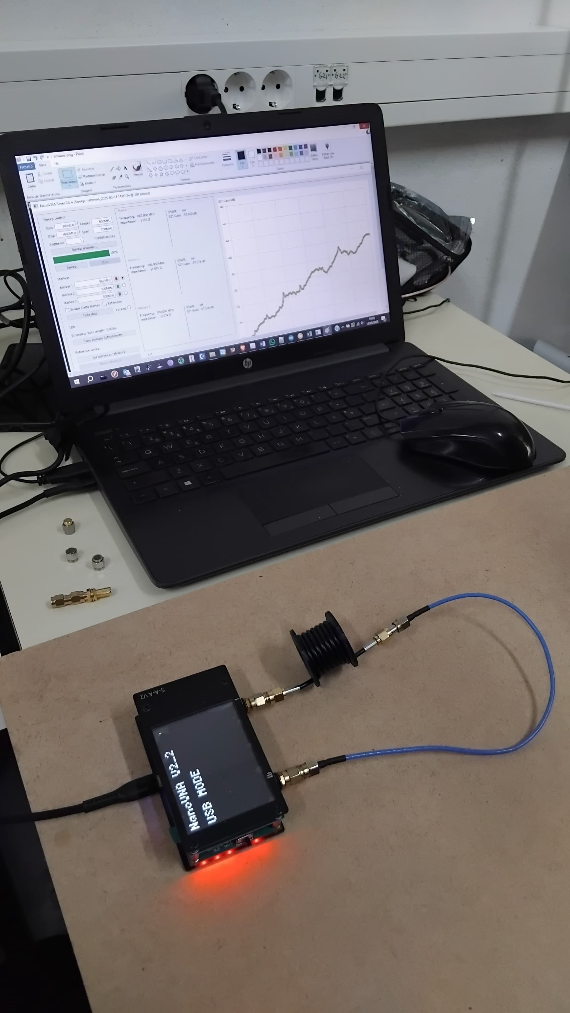
hardware/balun/photos/balun3.jpg
