mauroleme/radiation-pattern-measurement-system/hardware/cad/images/solidworks_design.png

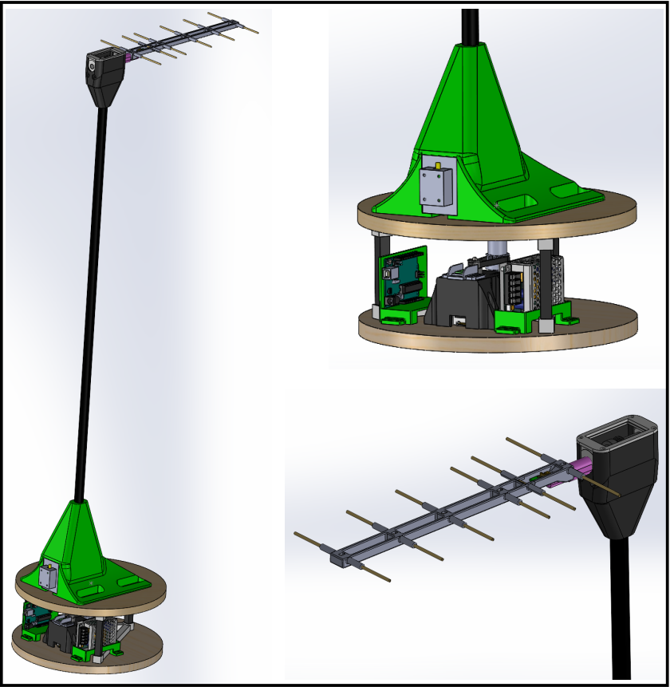
hardware/cad/images/solidworks_design.png
