mauroleme/radiation-pattern-measurement-system/hardware/cad/previews/126T_pulley.png

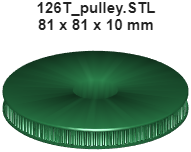
hardware/cad/previews/126T_pulley.png
