mauroleme/radiation-pattern-measurement-system/hardware/cad/previews/boom - prtedoboom-1.png

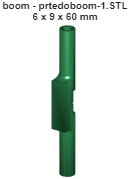
hardware/cad/previews/boom - prtedoboom-1.png
