mauroleme/radiation-pattern-measurement-system/hardware/cad/previews/novopino.png

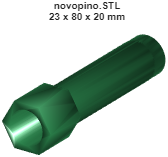
hardware/cad/previews/novopino.png
