mauroleme/radiation-pattern-measurement-system/hardware/cad/previews/novopinofurado.png

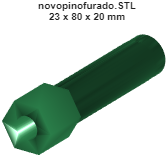
hardware/cad/previews/novopinofurado.png
