mauroleme/radiation-pattern-measurement-system/hardware/cad/previews/Part6.png

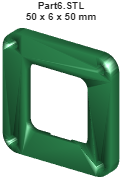
hardware/cad/previews/Part6.png
