mauroleme/radiation-pattern-measurement-system/hardware/cad/previews/pino.png

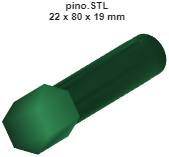
hardware/cad/previews/pino.png
