mauroleme/radiation-pattern-measurement-system/hardware/cad/previews/pinopartedebaixo.png

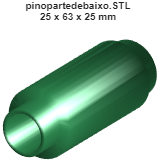
hardware/cad/previews/pinopartedebaixo.png
