mauroleme/radiation-pattern-measurement-system/hardware/cad/previews/pinopartedebaixofurado.png

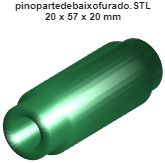
hardware/cad/previews/pinopartedebaixofurado.png
