mauroleme/radiation-pattern-measurement-system/hardware/cad/previews/pinopartedecima.png

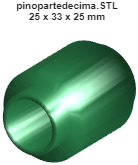
hardware/cad/previews/pinopartedecima.png
