mauroleme/radiation-pattern-measurement-system/hardware/cad/previews/tampa_traseira.png

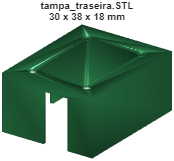
hardware/cad/previews/tampa_traseira.png
