mauroleme/radiation-pattern-measurement-system/hardware/cad/previews/tampadopecomprotecao.png

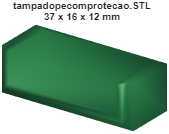
hardware/cad/previews/tampadopecomprotecao.png
