mauroleme/radiation-pattern-measurement-system/hardware/impedance-matching/images/antena antes.png

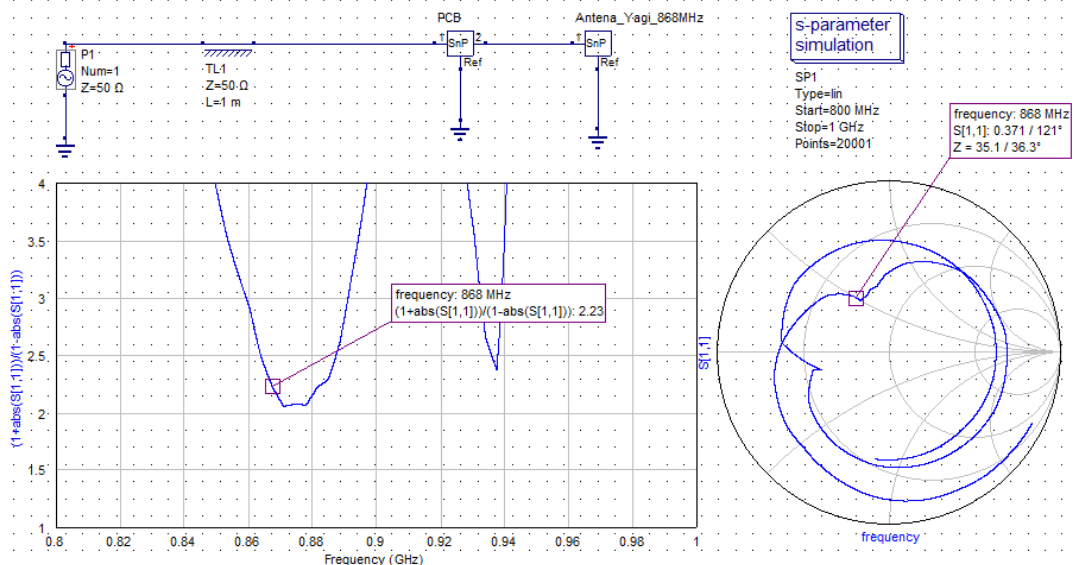
hardware/impedance-matching/images/antena antes.png
