mauroleme/radiation-pattern-measurement-system/hardware/impedance-matching/images/antena depois.png

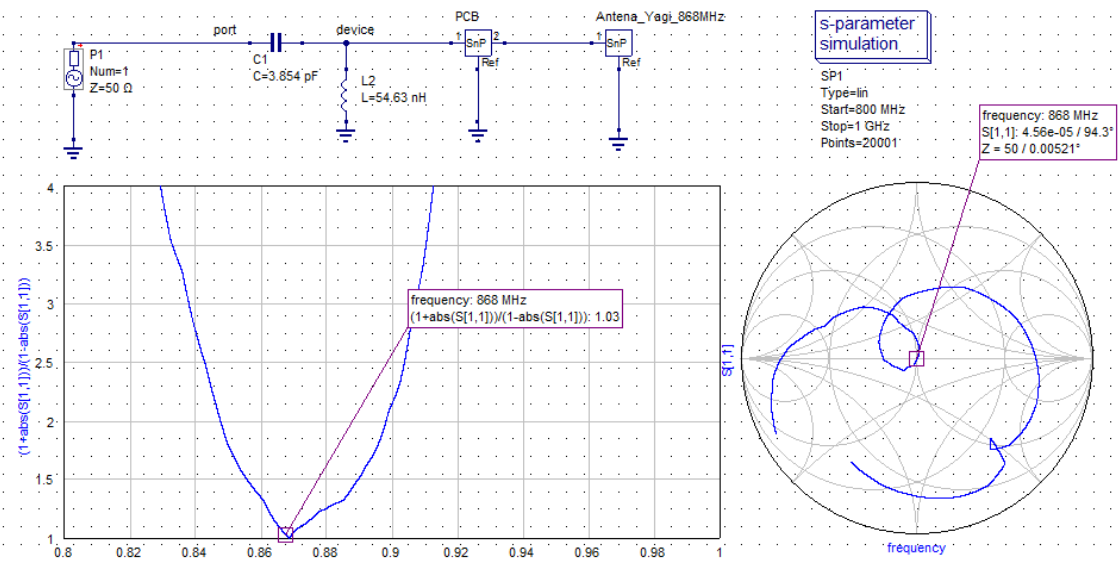
hardware/impedance-matching/images/antena depois.png
