mauroleme/radiation-pattern-measurement-system/hardware/impedance-matching/images/Antena_trasmissora-antes-e-depois.png

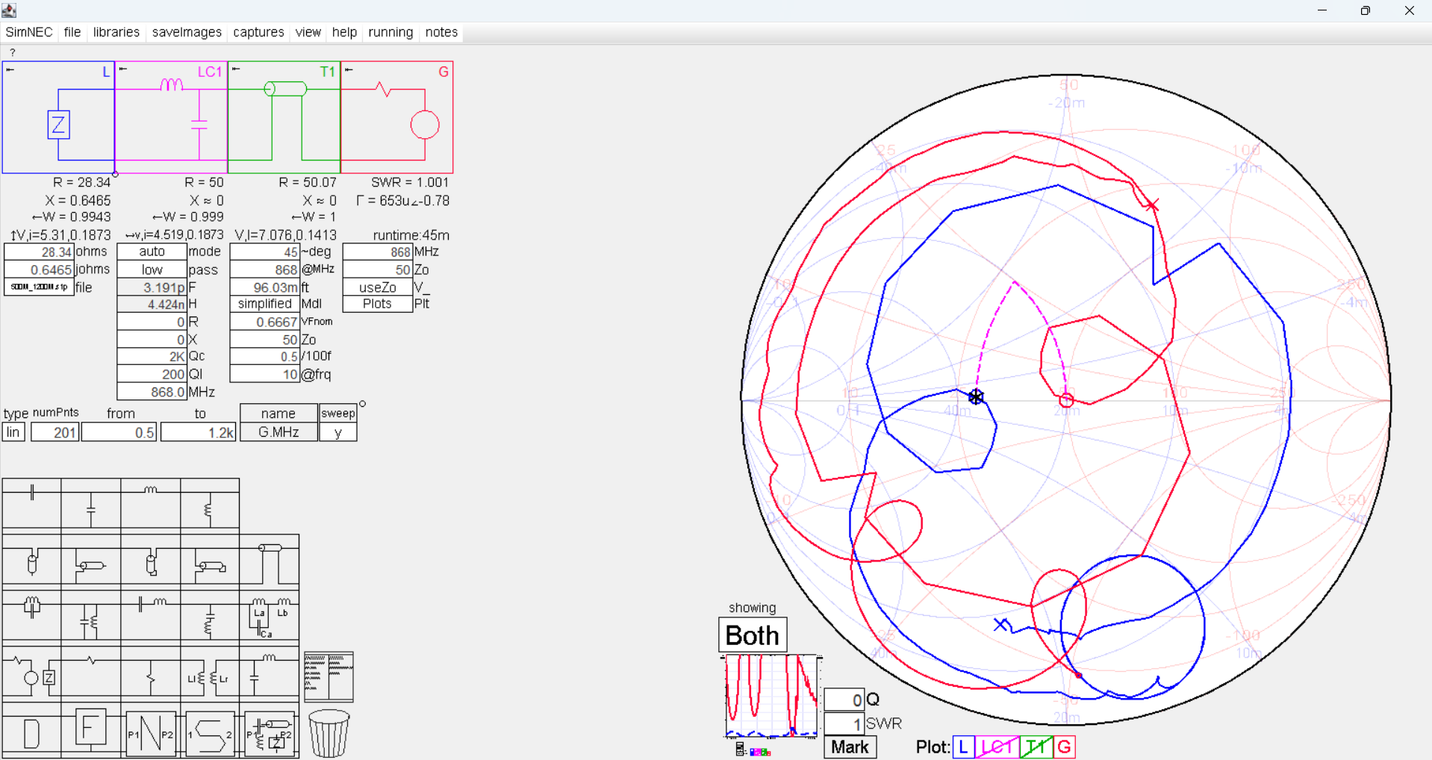
hardware/impedance-matching/images/Antena_trasmissora-antes-e-depois.png
