mauroleme/radiation-pattern-measurement-system/hardware/impedance-matching/images/Antena_trasmissora-depois_1.png

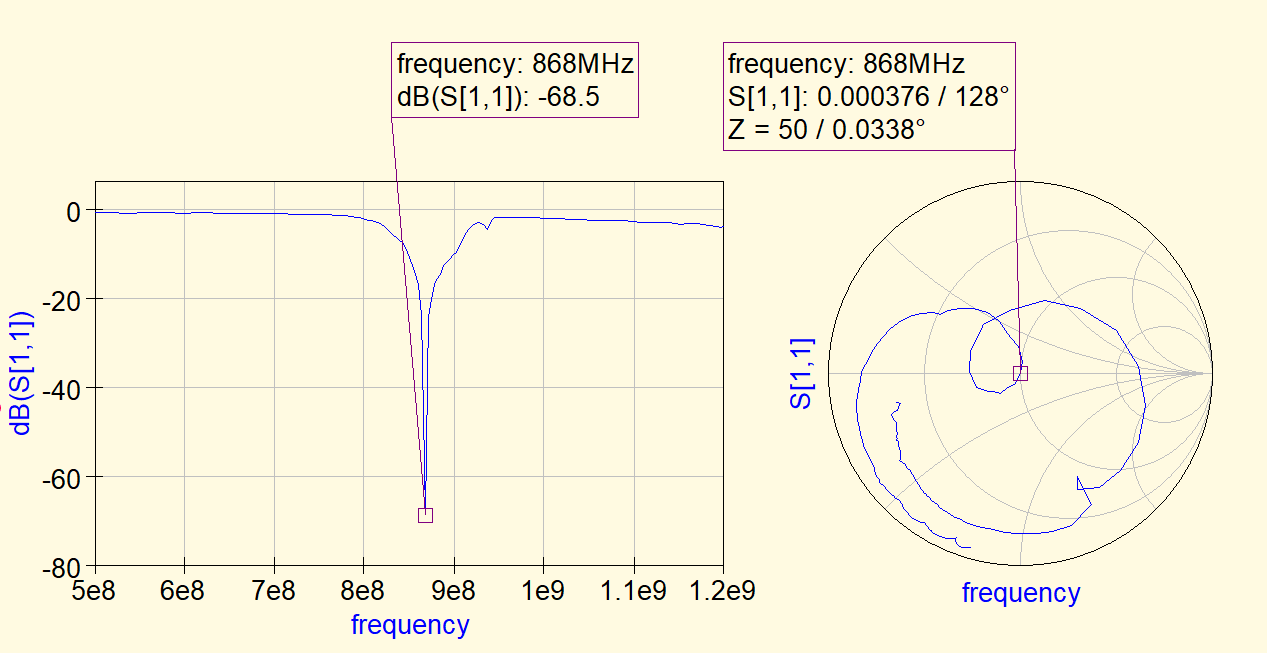
hardware/impedance-matching/images/Antena_trasmissora-depois_1.png
