mauroleme/radiation-pattern-measurement-system/hardware/impedance-matching/images/casamento_imp_antena_rx.png

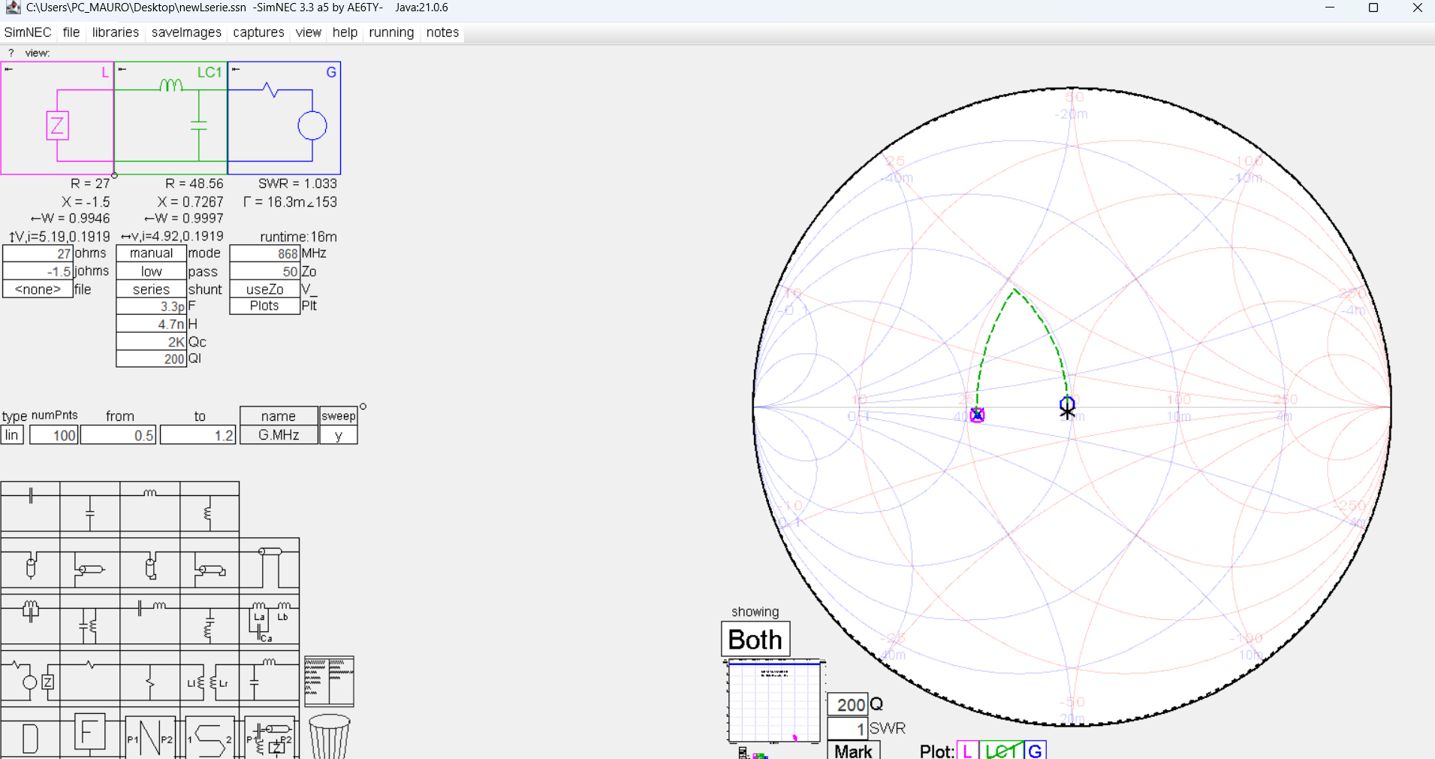
hardware/impedance-matching/images/casamento_imp_antena_rx.png
