mauroleme/radiation-pattern-measurement-system/hardware/impedance-matching/images/nanovna/S11 - -17dB.png

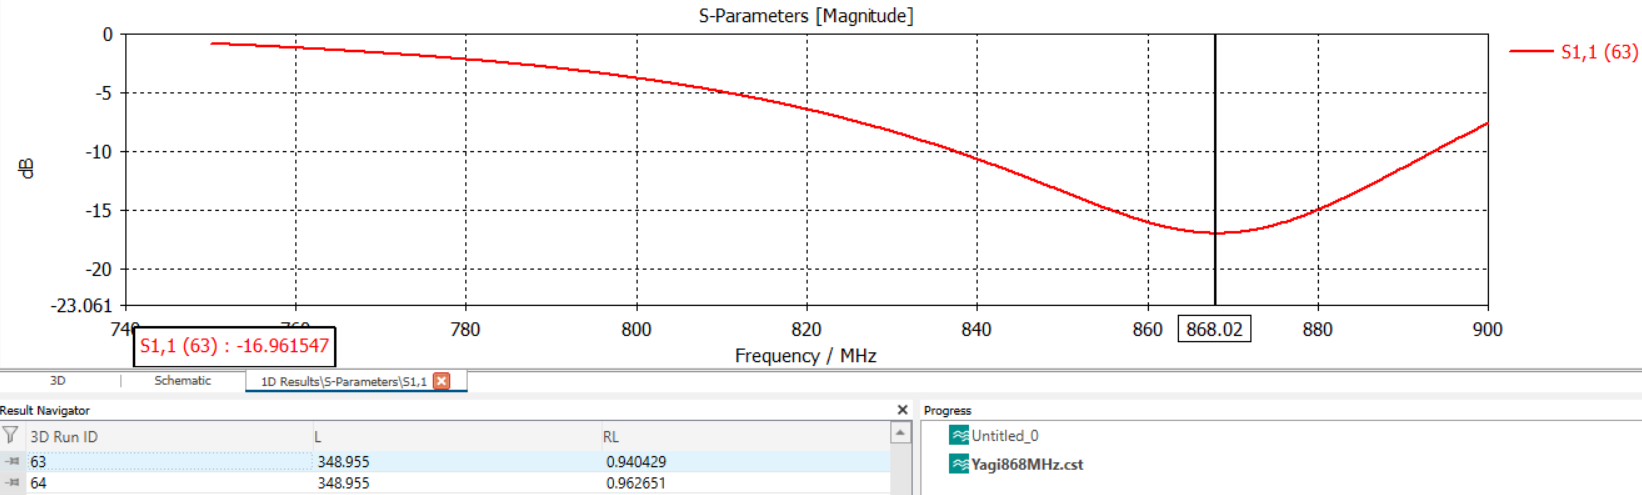
hardware/impedance-matching/images/nanovna/S11 - -17dB.png
