mauroleme/radiation-pattern-measurement-system/hardware/impedance-matching/images/nanovna/S11 - -20dB.png

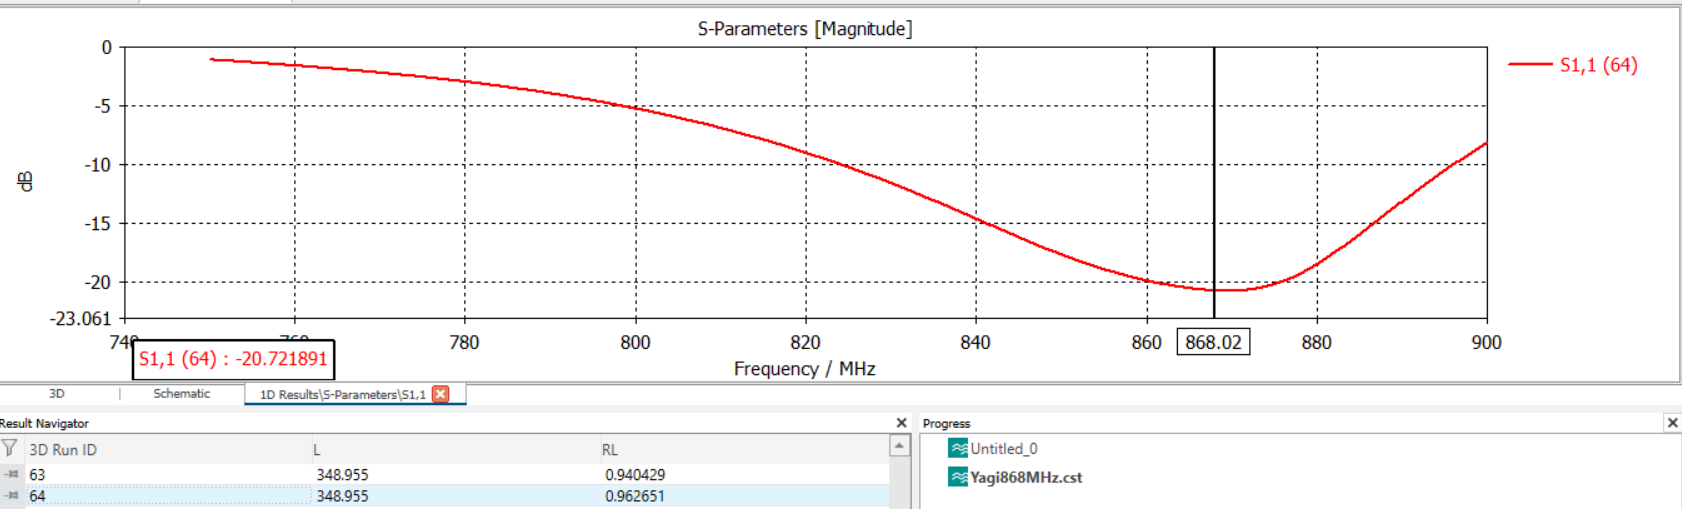
hardware/impedance-matching/images/nanovna/S11 - -20dB.png
