mauroleme/radiation-pattern-measurement-system/hardware/impedance-matching/images/nanovna/S11 - -24.6.png

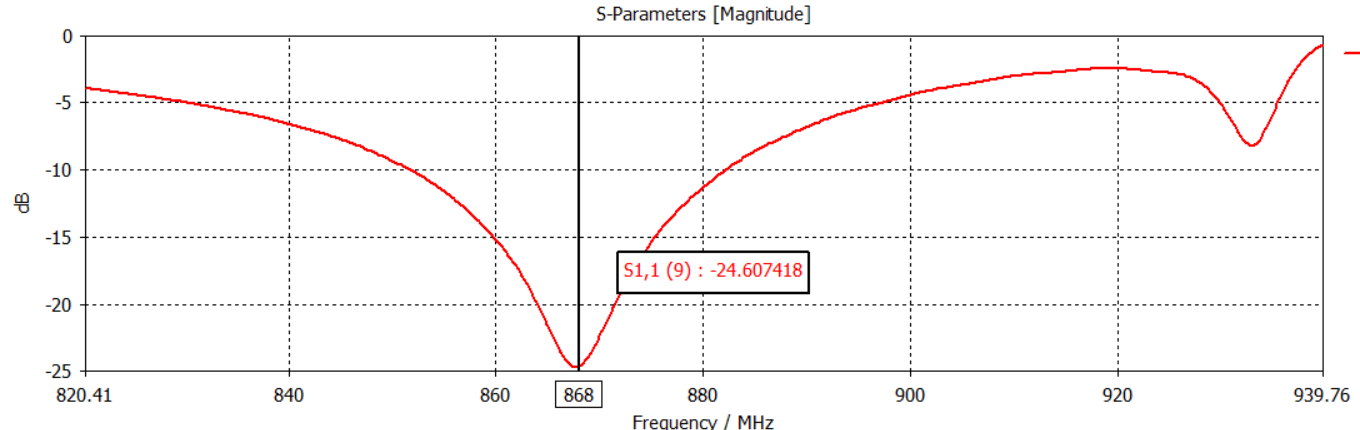
hardware/impedance-matching/images/nanovna/S11 - -24.6.png
