mauroleme/radiation-pattern-measurement-system/hardware/impedance-matching/images/nanovna/VSWR - 1.12.png

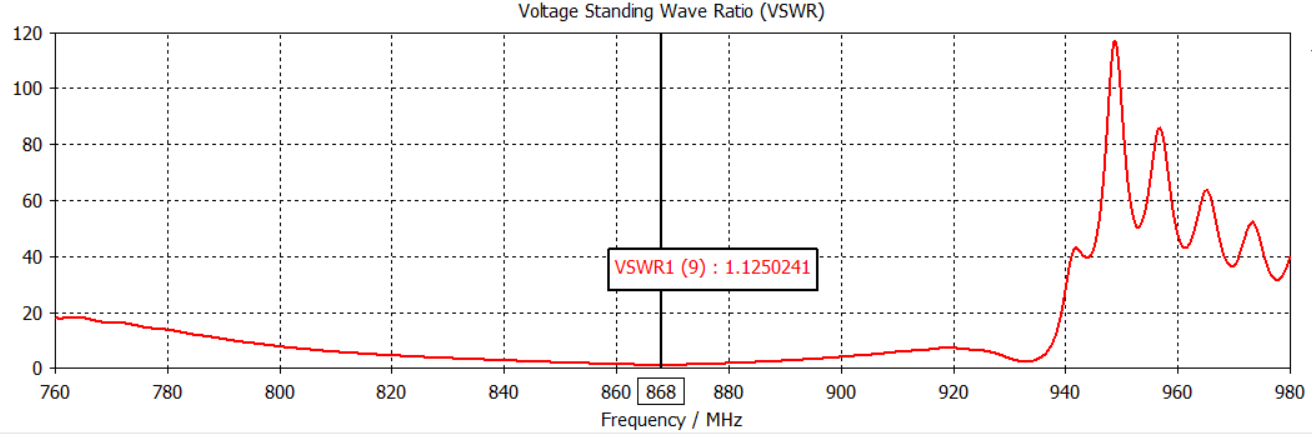
hardware/impedance-matching/images/nanovna/VSWR - 1.12.png
