mauroleme/radiation-pattern-measurement-system/hardware/impedance-matching/images/PCB1.png

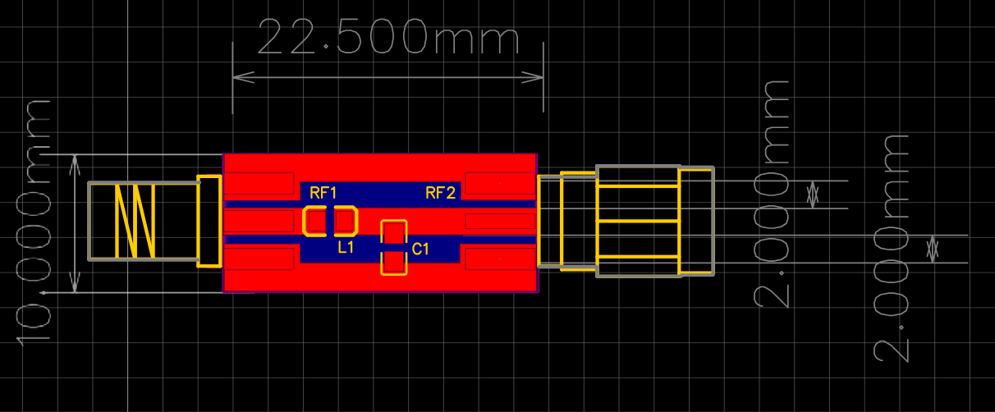
hardware/impedance-matching/images/PCB1.png
