mauroleme/radiation-pattern-measurement-system/hardware/impedance-matching/images/PCB2.png

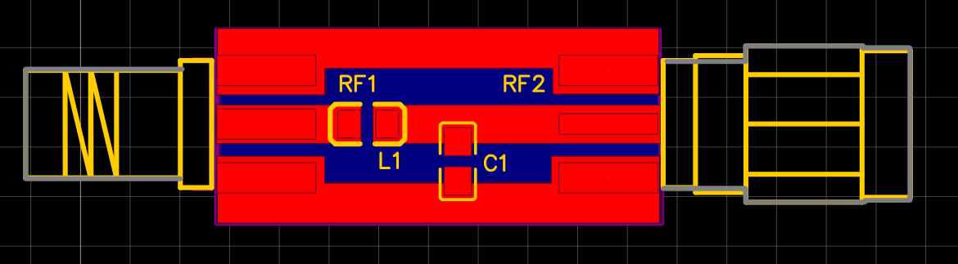
hardware/impedance-matching/images/PCB2.png
