mauroleme/radiation-pattern-measurement-system/hardware/impedance-matching/images/S11 VSWR.png

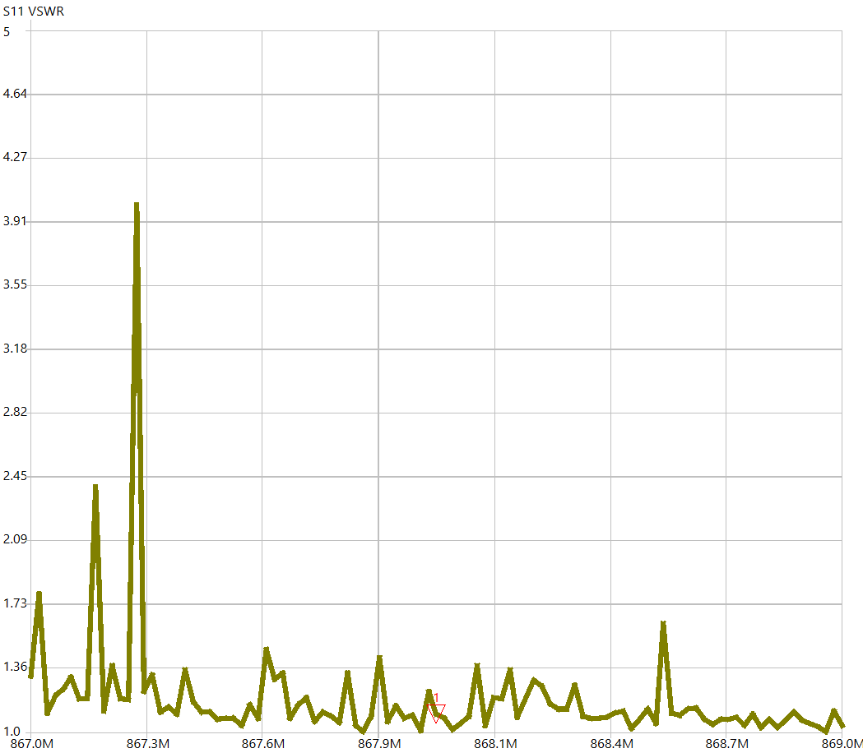
hardware/impedance-matching/images/S11 VSWR.png
