mauroleme/radiation-pattern-measurement-system/matlab/development/diagrama_de_radiacao.png

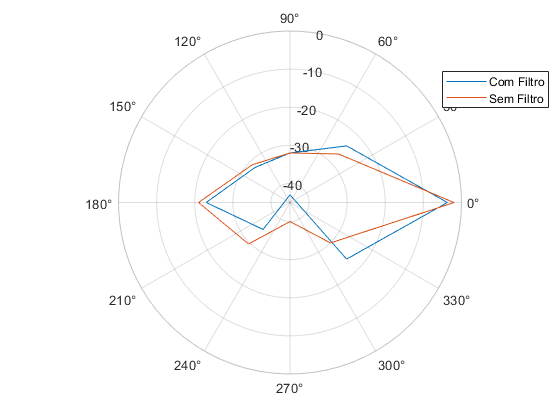
matlab/development/diagrama_de_radiacao.png
