mauroleme/radiation-pattern-measurement-system/matlab/images/sim_3d-grid__azimuth_cut_el_0.png

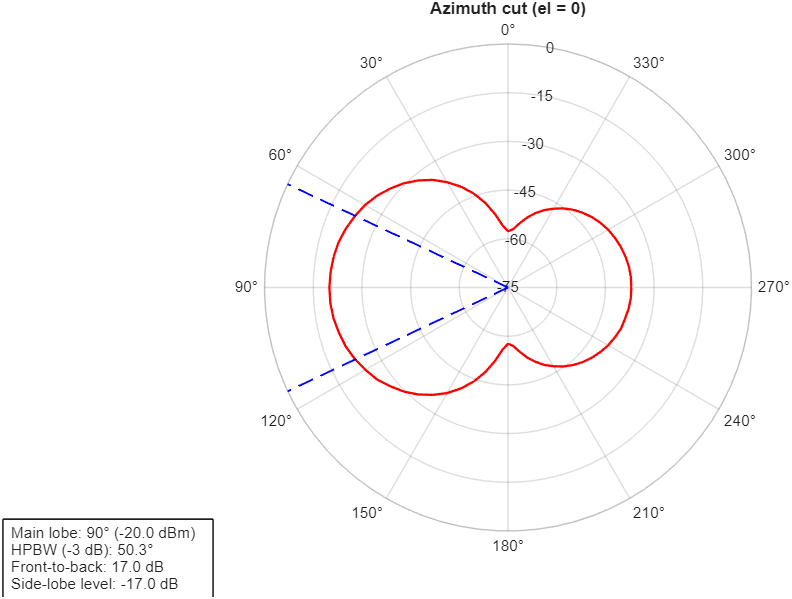
matlab/images/sim_3d-grid__azimuth_cut_el_0.png
