mauroleme/radiation-pattern-measurement-system/matlab/images/sim_3d-slices__elevation_cut.png

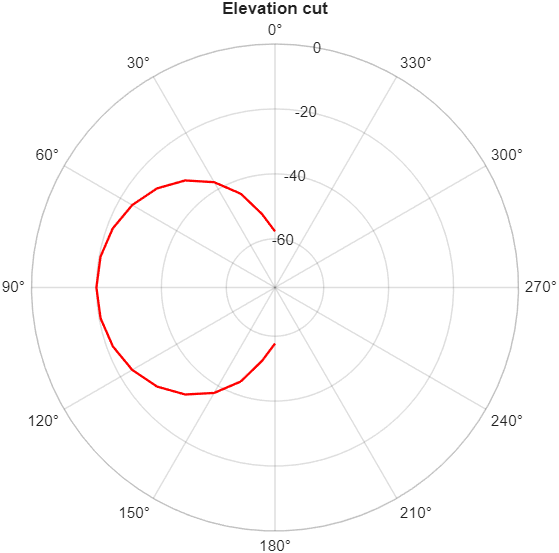
matlab/images/sim_3d-slices__elevation_cut.png
