mauroleme/radiation-pattern-measurement-system/media/photos/antenna_prototype.png

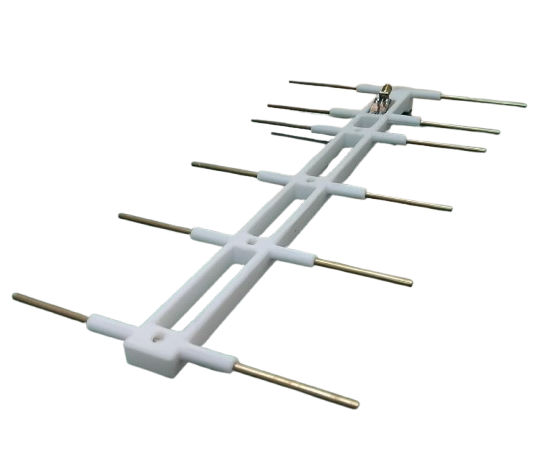
media/photos/antenna_prototype.png
