mauroleme/radiation-pattern-measurement-system/media/photos/bottom_section.png

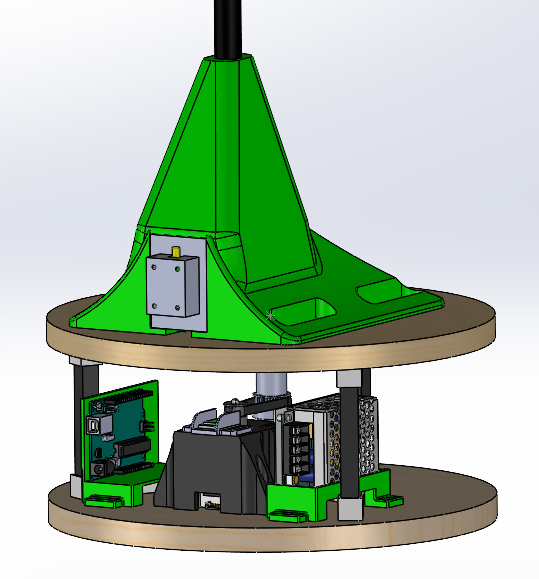
media/photos/bottom_section.png
