mauroleme/radiation-pattern-measurement-system/media/photos/IMG-20250816-WA0021.jpg

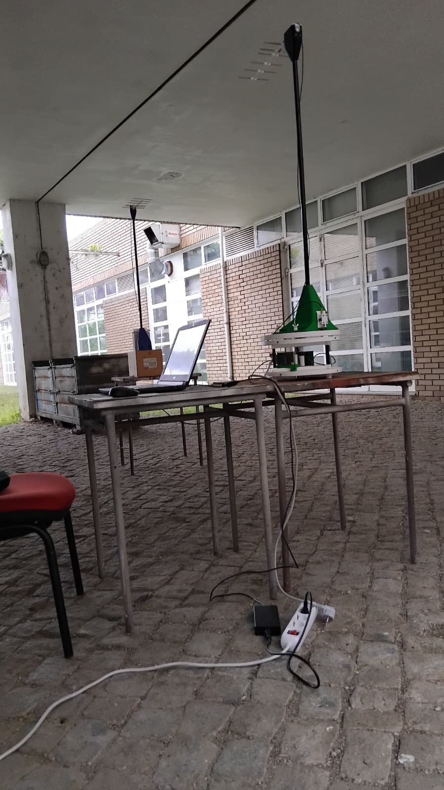
media/photos/IMG-20250816-WA0021.jpg
