mauroleme/radiation-pattern-measurement-system/media/photos/IMG_20250811_164706.jpg

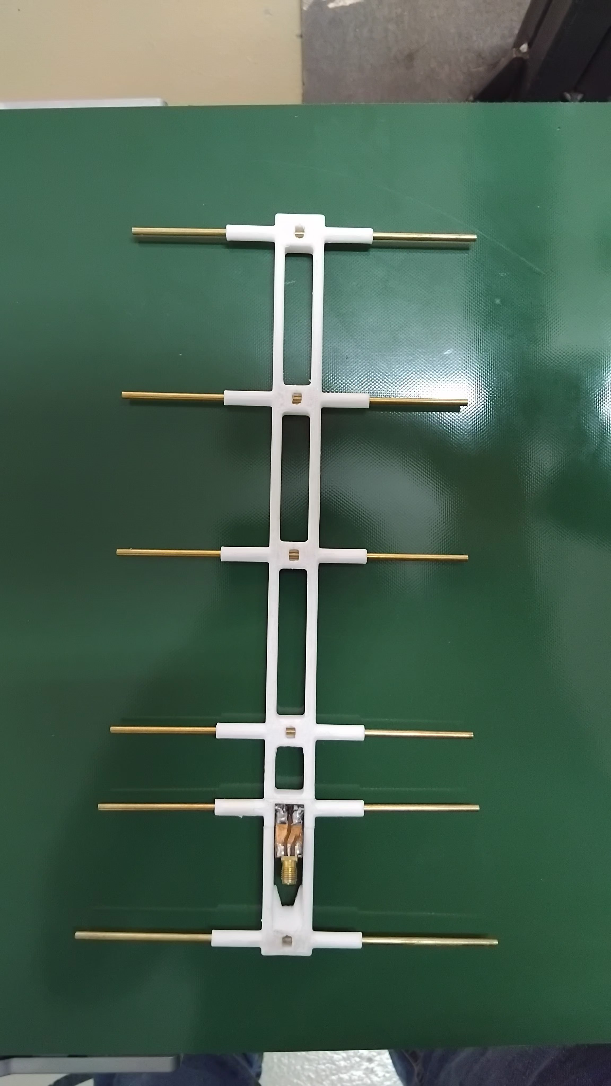
media/photos/IMG_20250811_164706.jpg
