mauroleme/radiation-pattern-measurement-system/media/photos/IMG_20250811_164731.jpg

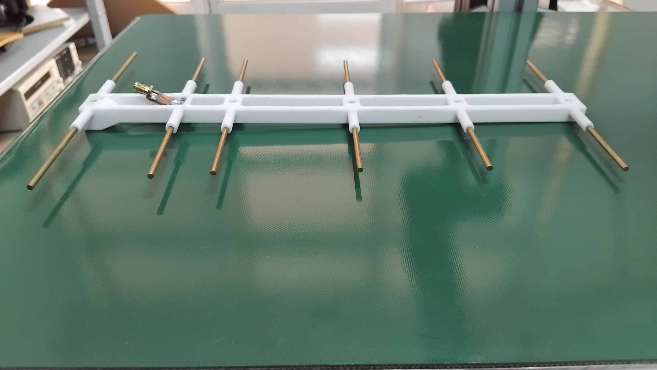
media/photos/IMG_20250811_164731.jpg
