mauroleme/radiation-pattern-measurement-system/media/photos/IMG_20250811_164754.jpg

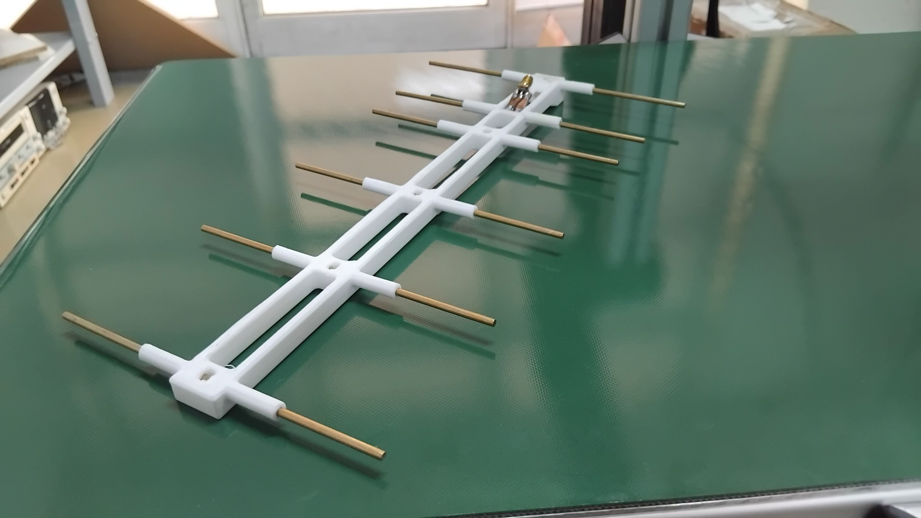
media/photos/IMG_20250811_164754.jpg
