mauroleme/radiation-pattern-measurement-system/media/photos/sistema completo.jpg

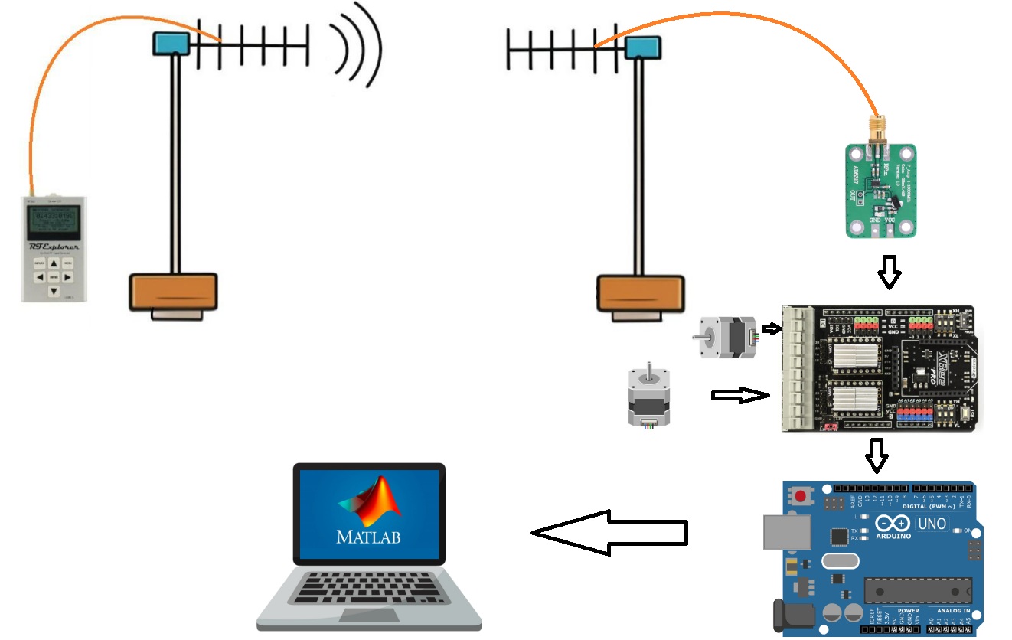
media/photos/sistema completo.jpg
