mauroleme/radiation-pattern-measurement-system/simulation/cst/Yagi868MHz_export/farfield (f=868)_8.png

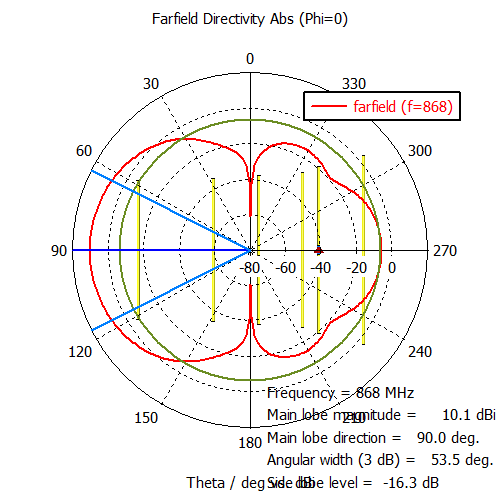
simulation/cst/Yagi868MHz_export/farfield (f=868)_8.png
