mauroleme/radiation-pattern-measurement-system/simulation/images/3Dsimulation.png

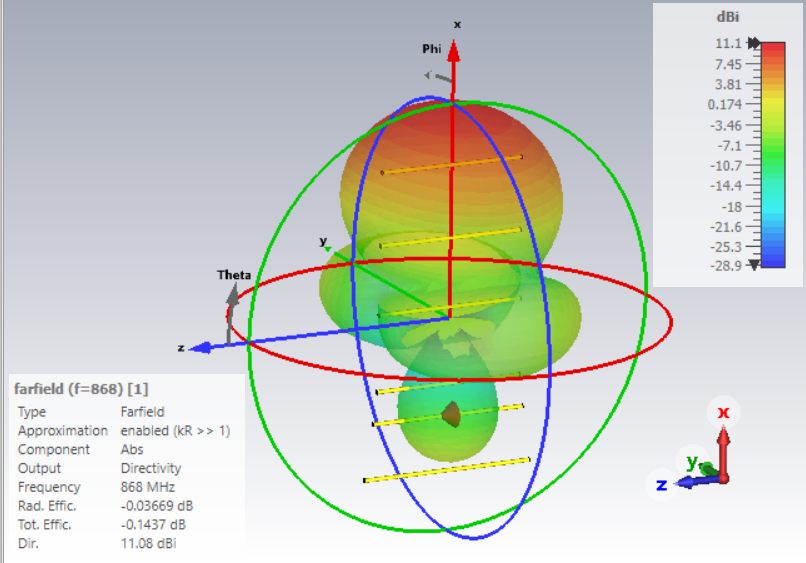
simulation/images/3Dsimulation.png
