mauroleme/radiation-pattern-measurement-system/simulation/images/quasebom_YAGI.png

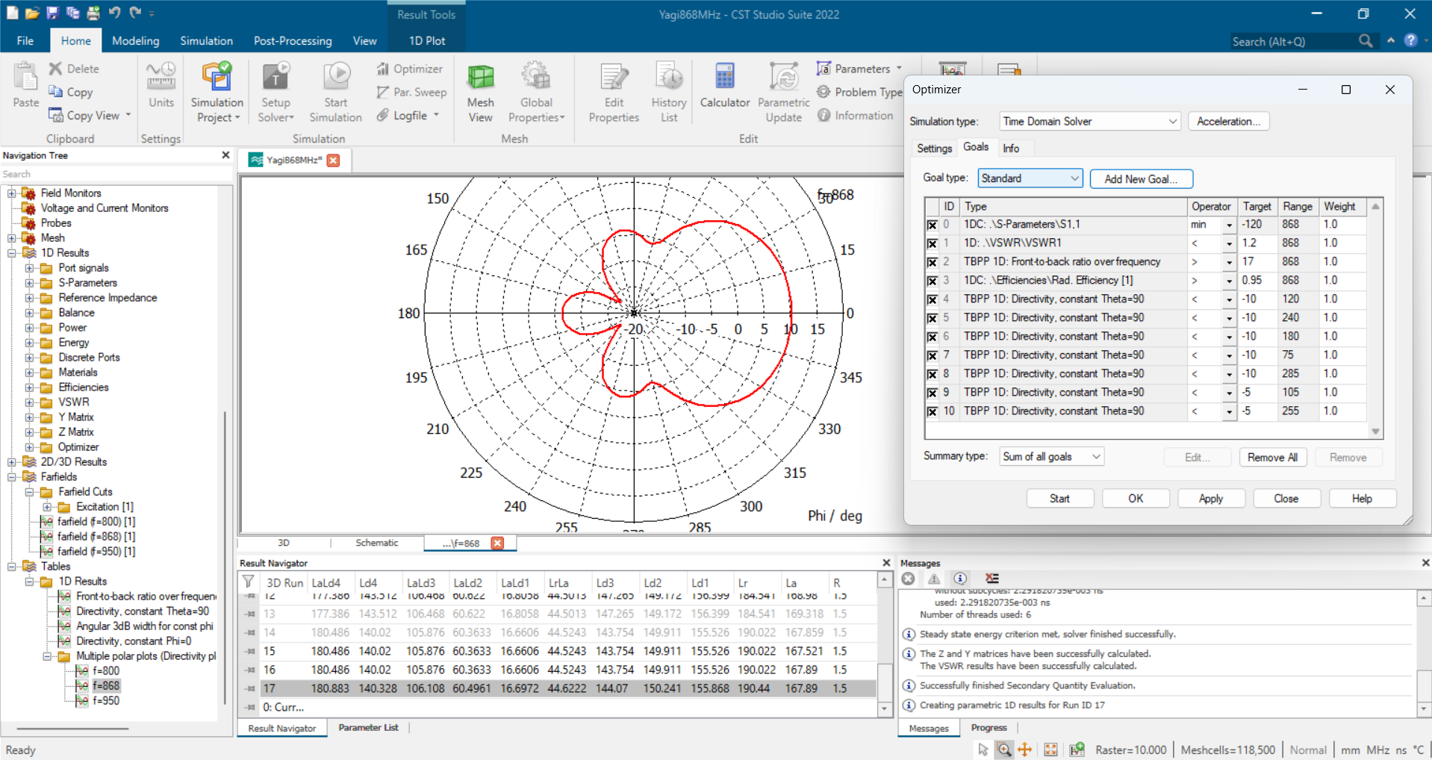
simulation/images/quasebom_YAGI.png
