mauroleme/radiation-pattern-measurement-system/simulation/images/simulationv2.png

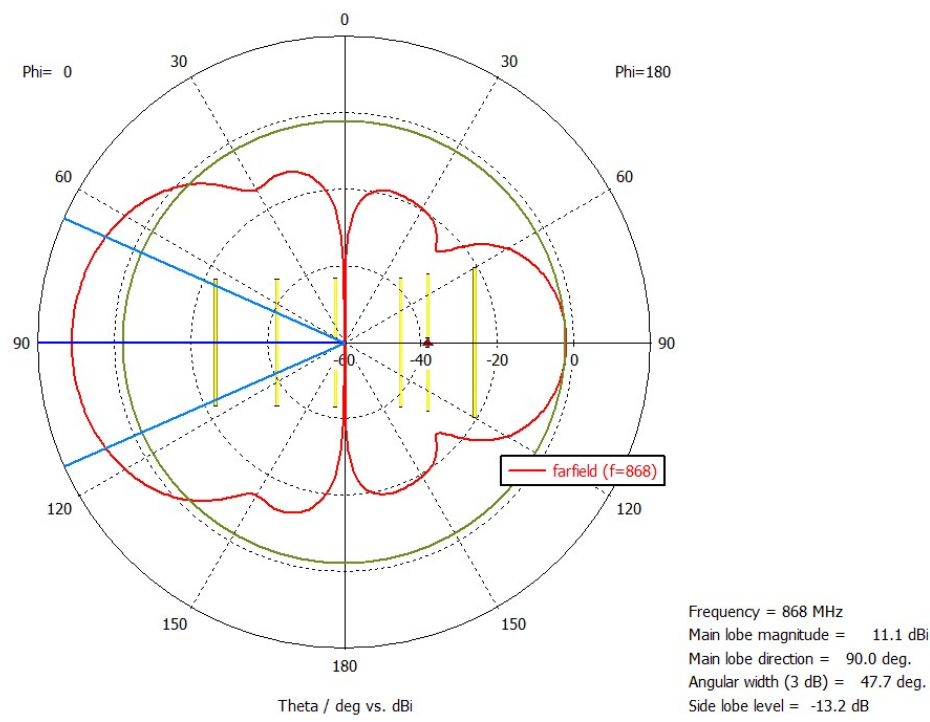
simulation/images/simulationv2.png
