mauroleme/radiation-pattern-measurement-system/simulation/matlab-antenna-toolbox/yagi-optimization/polarEplane.png

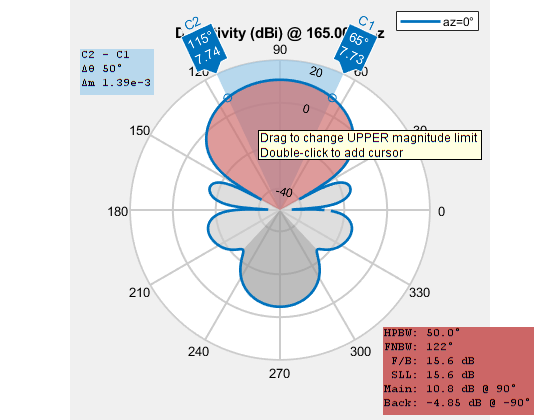
simulation/matlab-antenna-toolbox/yagi-optimization/polarEplane.png
