mauroleme/radiation-pattern-measurement-system/hardware/cad/solidworks/balun-support/Assem1.SLDASM

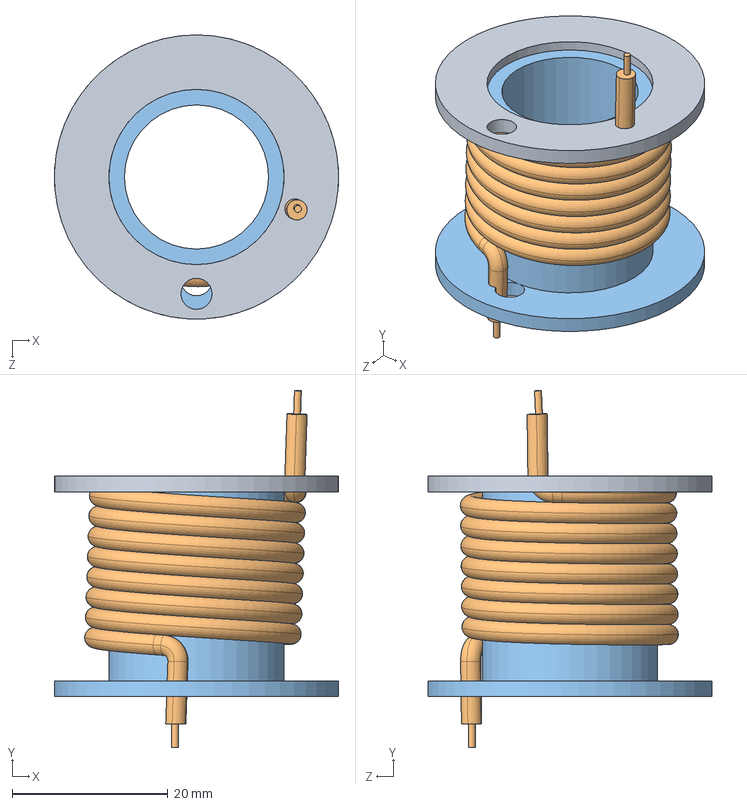
[picture p156: CAD file, 2026-10-10]
hardware/cad/solidworks/balun-support/Assem1.SLDASM
36.5 x 45.8 x 36.5 mm
forma1
RG174
forma2
