mauroleme/radiation-pattern-measurement-system/hardware/cad/solidworks/balun-support/Ver1a.SLDPRT

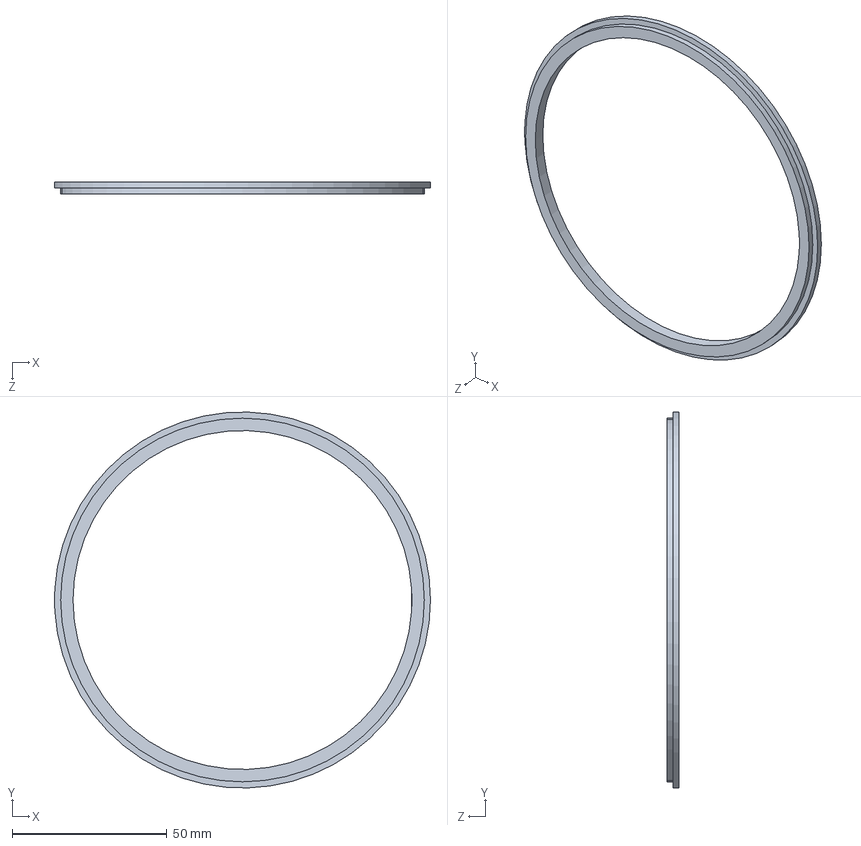
[picture p157: CAD file, 2026-10-10]
hardware/cad/solidworks/balun-support/Ver1a.SLDPRT
121.7 x 121.6 x 4.00 mm
