mauroleme/radiation-pattern-measurement-system/hardware/cad/solidworks/prtedopqn.SLDPRT

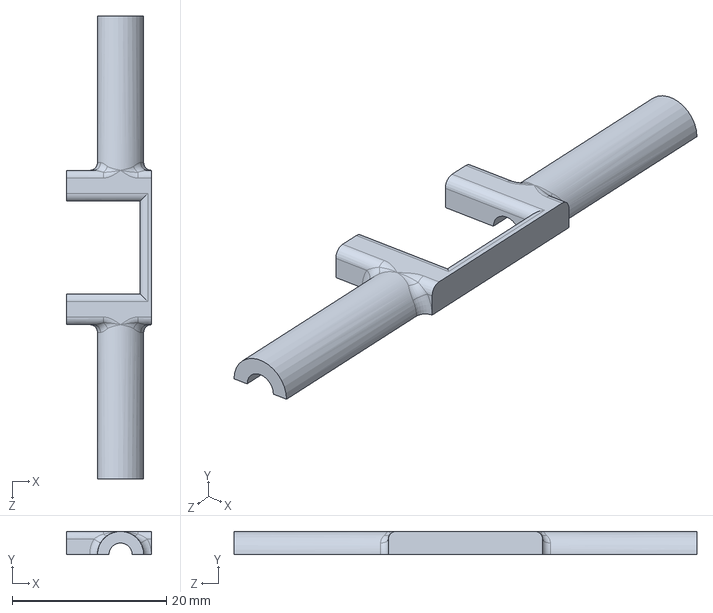
[picture p158: CAD file, 2026-10-10]
hardware/cad/solidworks/prtedopqn.SLDPRT
11.0 x 3.00 x 60.0 mm
