mauroleme/radiation-pattern-measurement-system/hardware/cad/stl/tampa_RF_sensor.STL

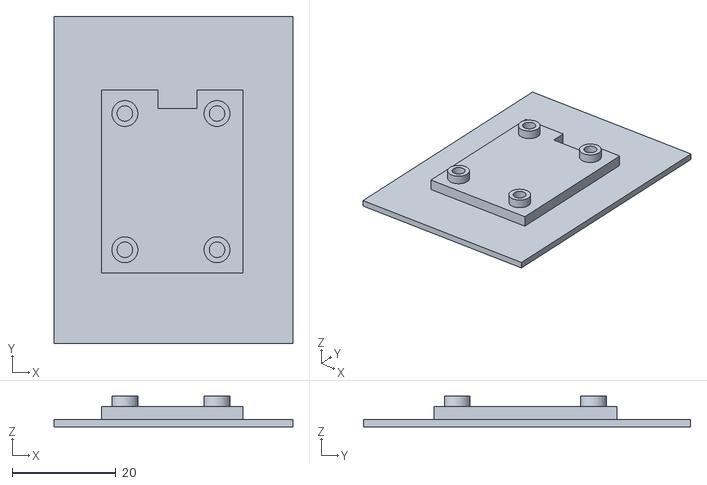
[picture p159: CAD file, 2026-10-10]
hardware/cad/stl/tampa_RF_sensor.STL
46.0 x 63.0 x 5.95
