mauroleme/radiation-pattern-measurement-system/hardware/cad/solidworks/balun-support/Ver1b.SLDPRT

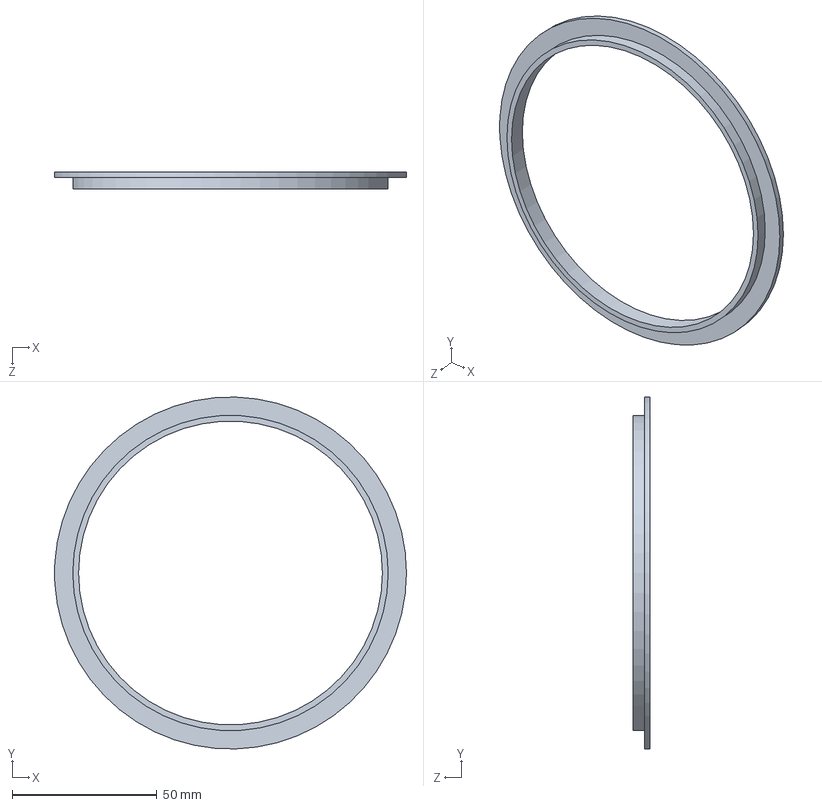
[picture p160: CAD file, 2026-10-10]
hardware/cad/solidworks/balun-support/Ver1b.SLDPRT
121.7 x 121.6 x 6.00 mm
