mauroleme/radiation-pattern-measurement-system/hardware/cad/solidworks/roldana_cima.SLDPRT

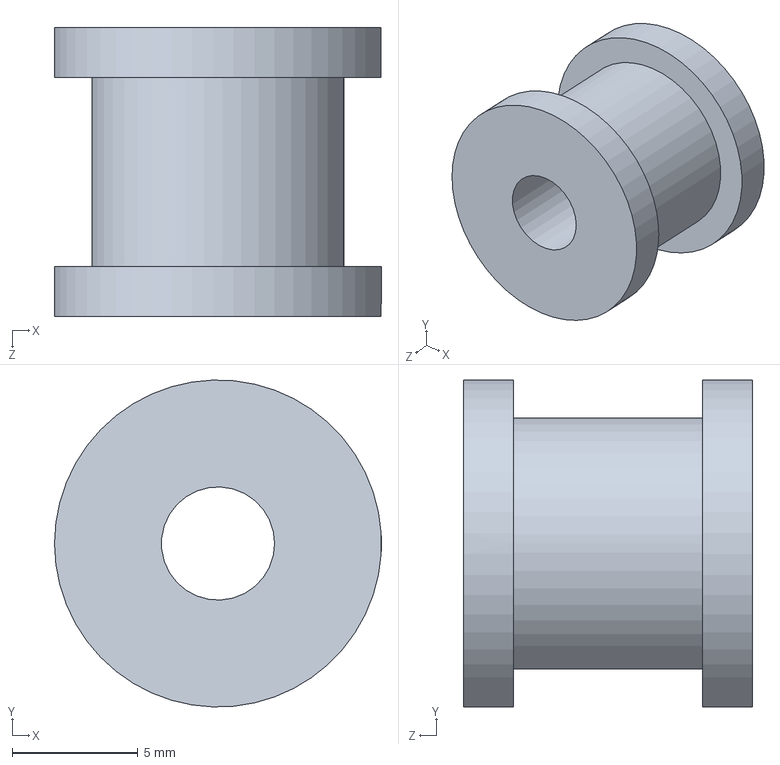
[picture p161: CAD file, 2026-10-10]
hardware/cad/solidworks/roldana_cima.SLDPRT
13.0 x 13.0 x 11.5 mm
