mauroleme/radiation-pattern-measurement-system/hardware/cad/stl/Part2.STL

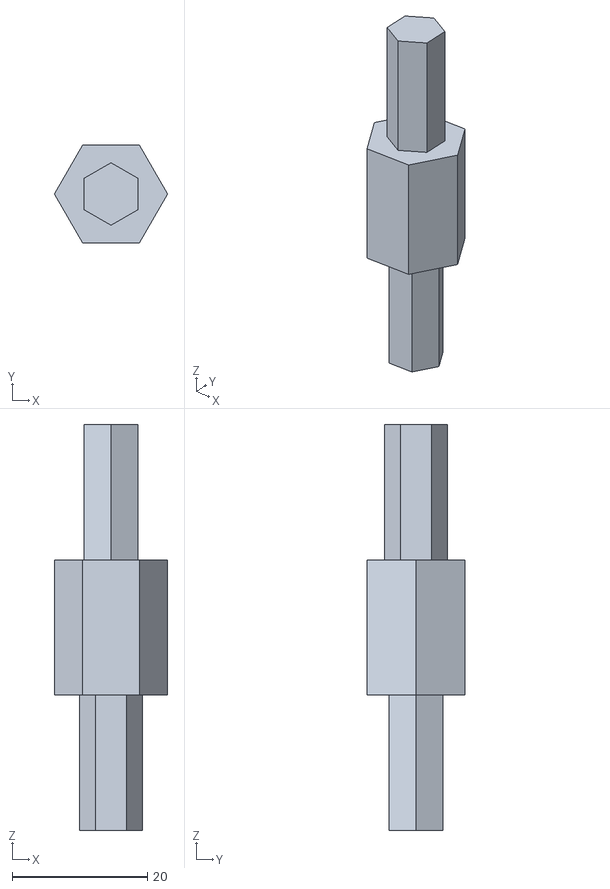
[picture p162: CAD file, 2026-10-10]
hardware/cad/stl/Part2.STL
16.7 x 14.5 x 60.0
