mauroleme/radiation-pattern-measurement-system/hardware/cad/solidworks/balun-support/forma1.SLDPRT

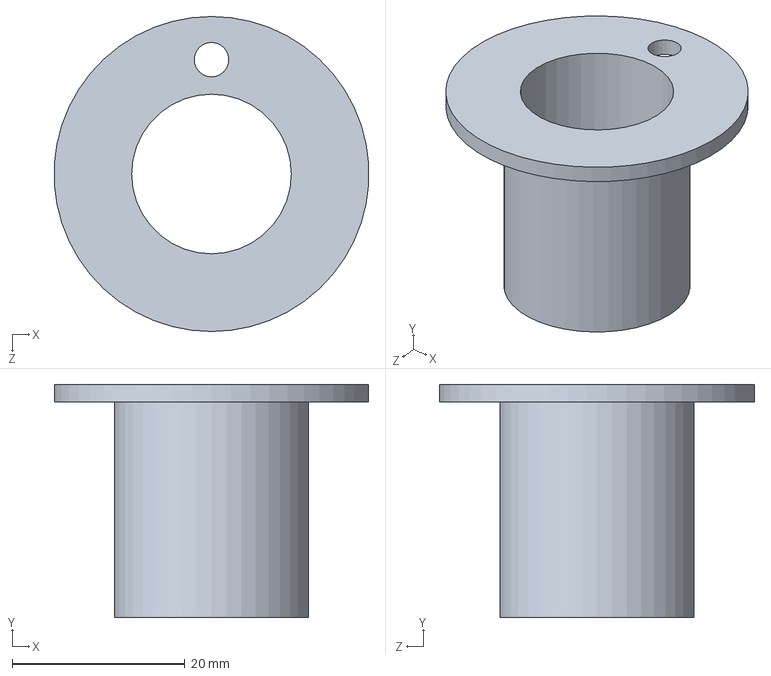
[picture p163: CAD file, 2026-10-10]
hardware/cad/solidworks/balun-support/forma1.SLDPRT
36.4 x 27.0 x 36.5 mm
