mauroleme/radiation-pattern-measurement-system/hardware/cad/solidworks/pinopartedecima.SLDPRT

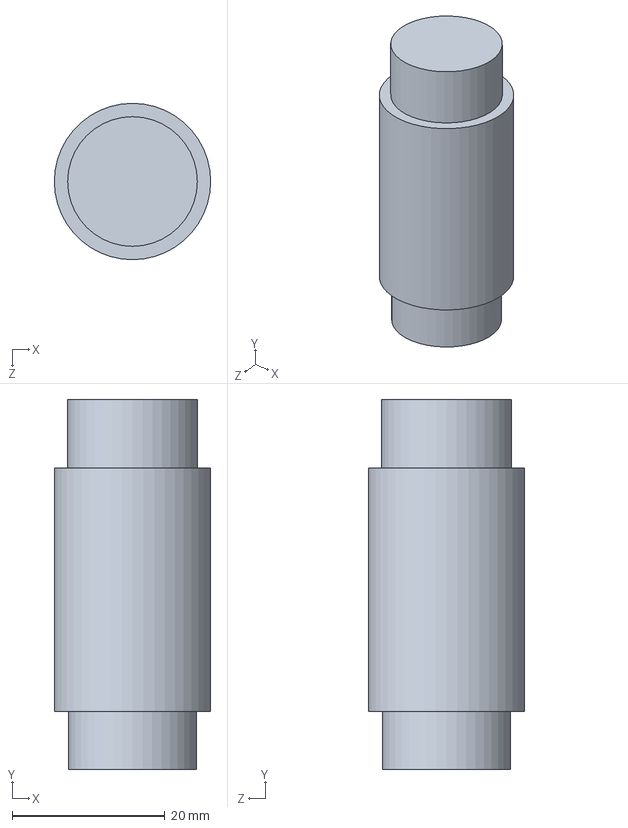
[picture p164: CAD file, 2026-10-10]
hardware/cad/solidworks/pinopartedecima.SLDPRT
20.5 x 48.5 x 20.5 mm
