mauroleme/radiation-pattern-measurement-system/hardware/cad/stl/adptador.STL

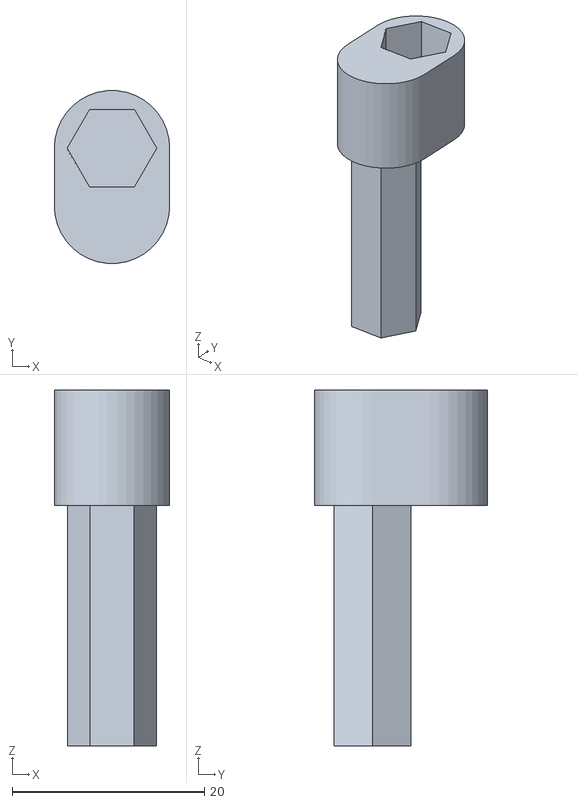
[picture p165: CAD file, 2026-10-10]
hardware/cad/stl/adptador.STL
12.0 x 18.0 x 37.0
