mauroleme/radiation-pattern-measurement-system/hardware/cad/solidworks/ant.SLDPRT

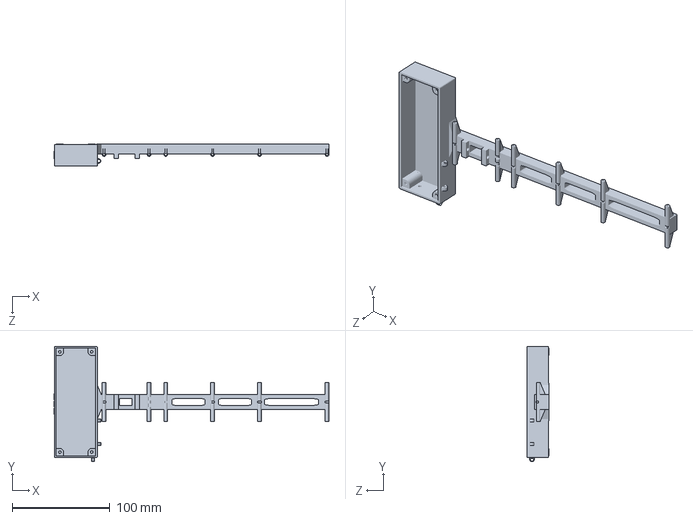
[picture p166: CAD file, 2026-10-10]
hardware/cad/solidworks/ant.SLDPRT
281.3 x 118.1 x 22.0 mm
