mauroleme/radiation-pattern-measurement-system/hardware/cad/solidworks/balun-support/Ver3b.SLDPRT

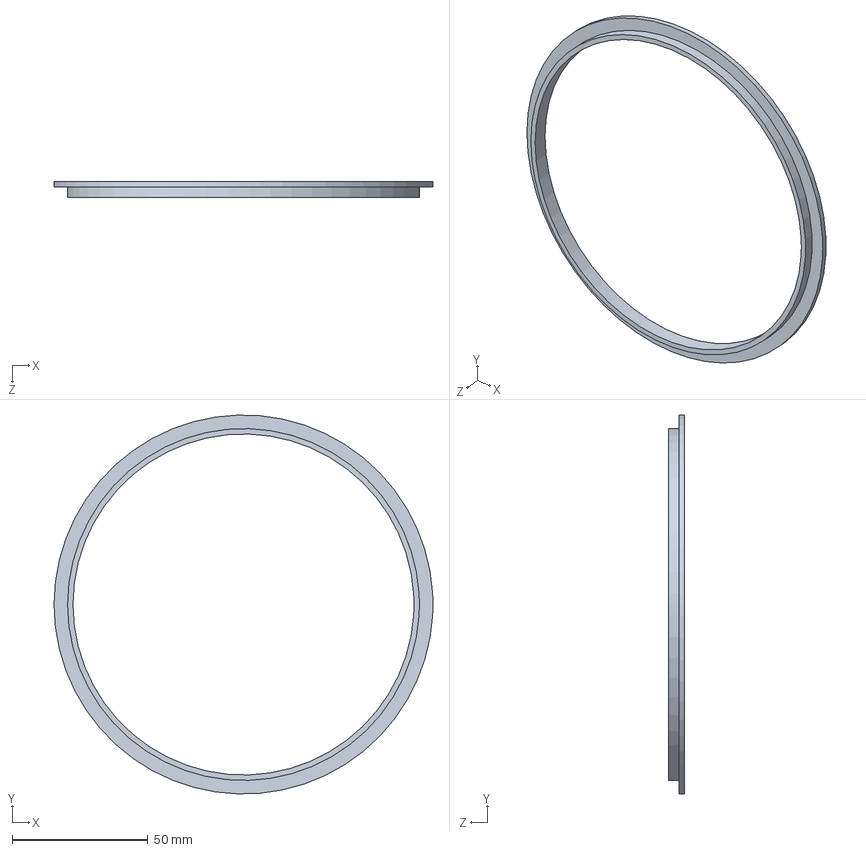
[picture p167: CAD file, 2026-10-10]
hardware/cad/solidworks/balun-support/Ver3b.SLDPRT
139.6 x 139.5 x 6.00 mm
