mauroleme/radiation-pattern-measurement-system/hardware/cad/stl/sup.STL

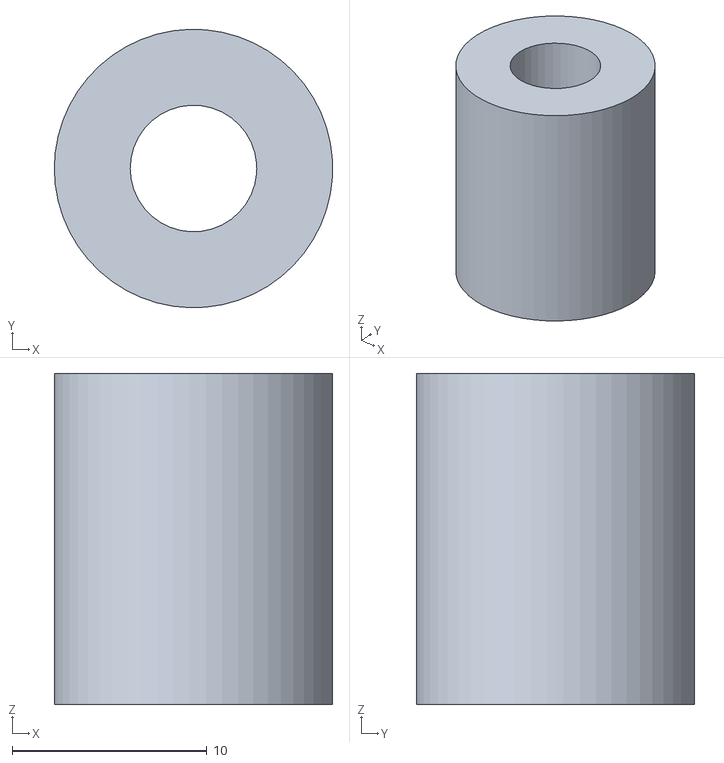
[picture p168: CAD file, 2026-10-10]
hardware/cad/stl/sup.STL
14.3 x 14.3 x 17.0
