mauroleme/radiation-pattern-measurement-system/hardware/cad/solidworks/balun-support/forma2.SLDPRT

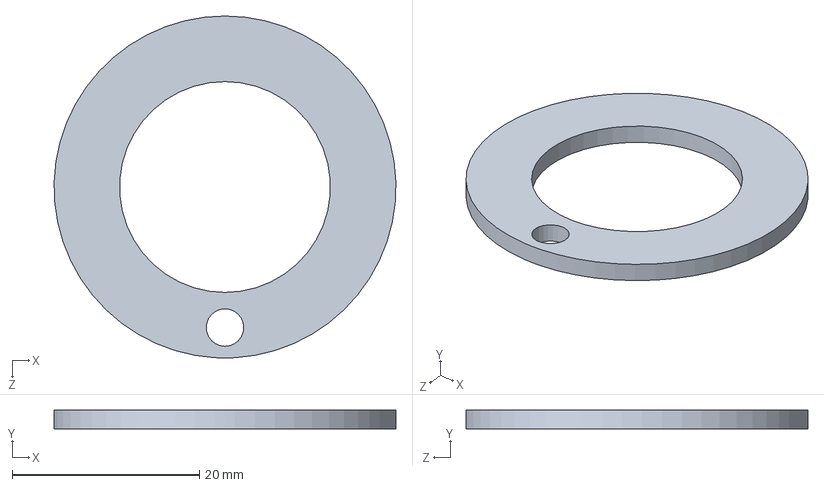
[picture p169: CAD file, 2026-10-10]
hardware/cad/solidworks/balun-support/forma2.SLDPRT
36.5 x 2.00 x 36.5 mm
