mauroleme/radiation-pattern-measurement-system/hardware/cad/stl/Part5.STL

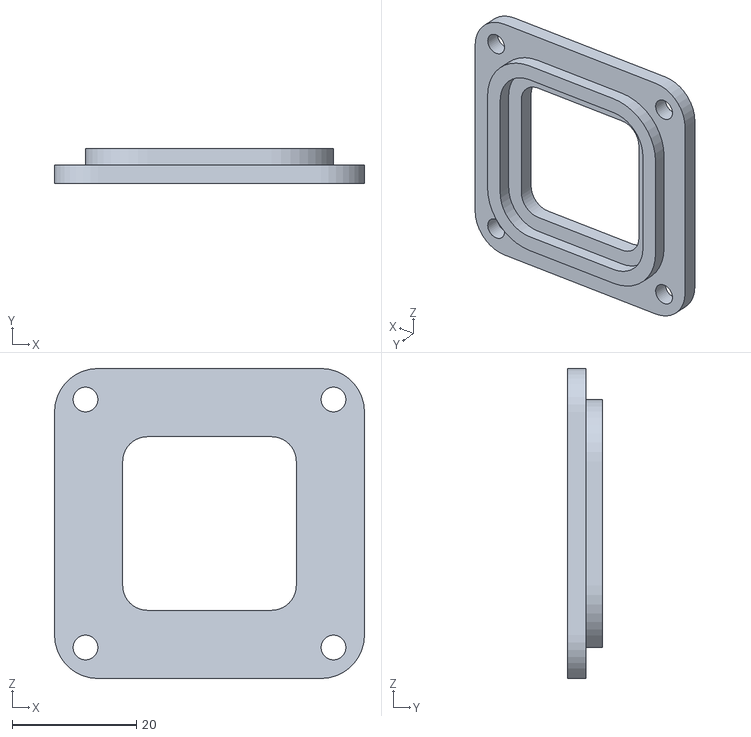
[picture p170: CAD file, 2026-10-10]
hardware/cad/stl/Part5.STL
50.0 x 5.60 x 50.0
