mauroleme/radiation-pattern-measurement-system/hardware/cad/solidworks/balun-support/RG174.SLDPRT

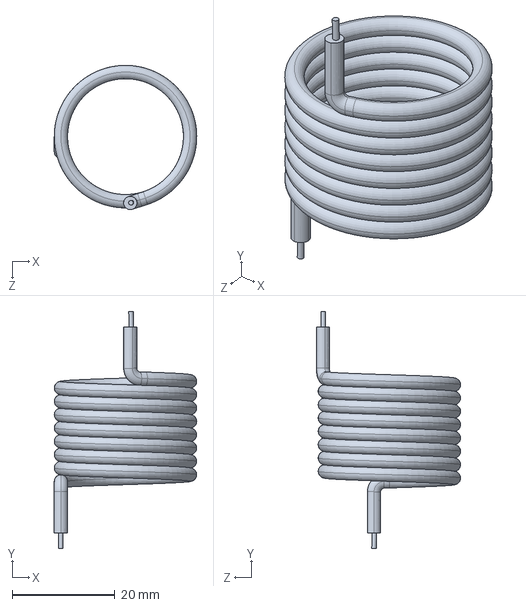
[picture p171: CAD file, 2026-10-10]
hardware/cad/solidworks/balun-support/RG174.SLDPRT
27.8 x 46.2 x 28.1 mm
