mauroleme/radiation-pattern-measurement-system/hardware/cad/stl/prtedoboom.STL

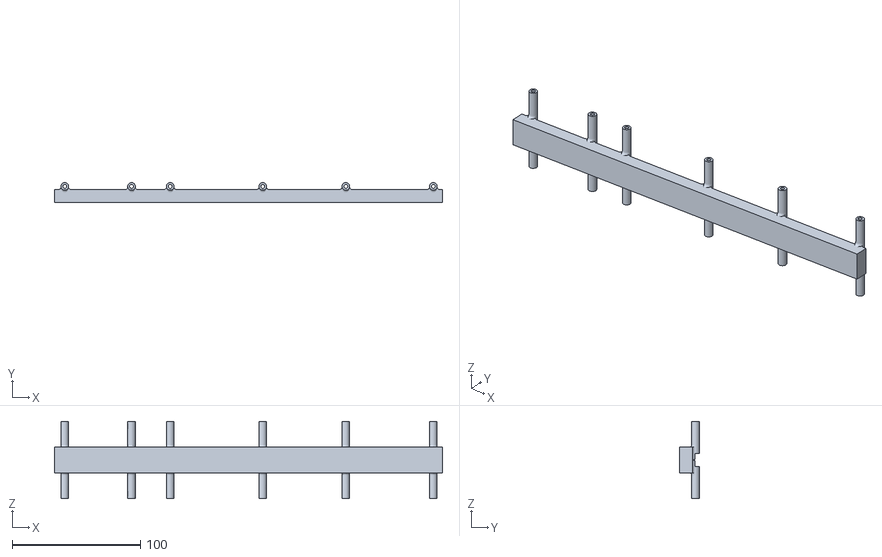
[picture p173: CAD file, 2026-10-10]
hardware/cad/stl/prtedoboom.STL
302.0 x 15.5 x 60.0
