mauroleme/radiation-pattern-measurement-system/hardware/cad/solidworks/Part25555.SLDPRT

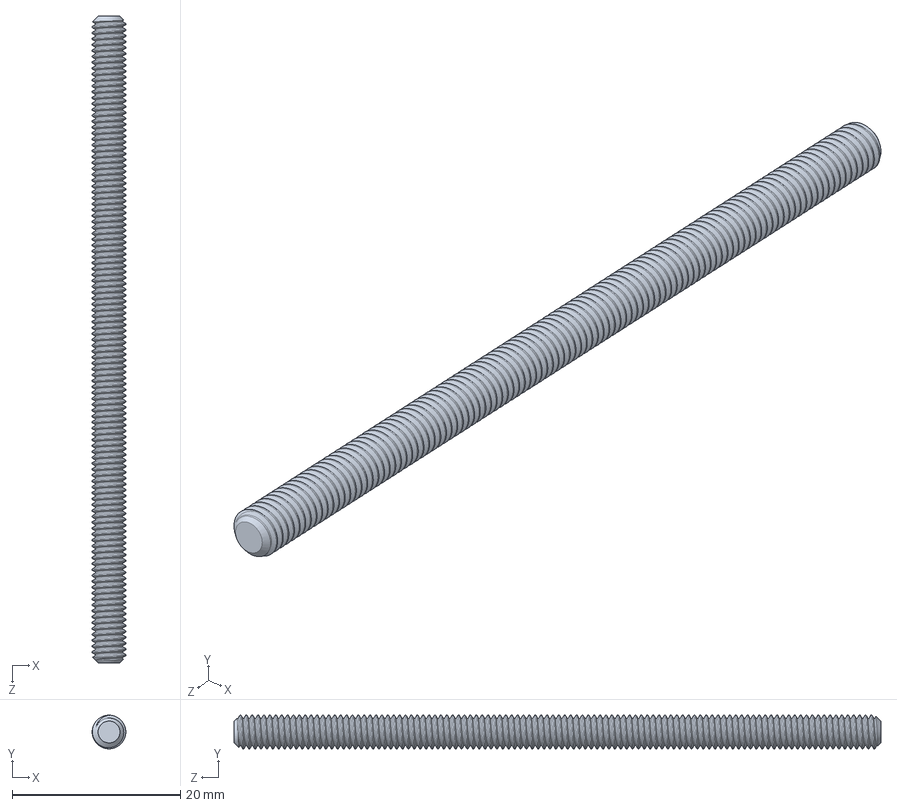
[picture p174: CAD file, 2026-10-10]
hardware/cad/solidworks/Part25555.SLDPRT
4.00 x 4.00 x 76.8 mm
