mauroleme/radiation-pattern-measurement-system/hardware/cad/stl/pinopartedebaixofurado.STL

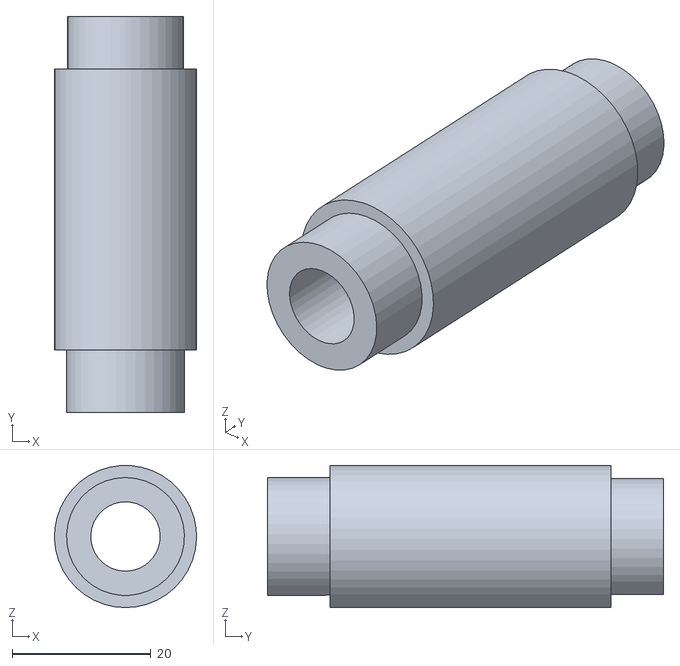
[picture p175: CAD file, 2026-10-10]
hardware/cad/stl/pinopartedebaixofurado.STL
20.5 x 57.1 x 20.5
