mauroleme/radiation-pattern-measurement-system/hardware/cad/solidworks/balun-support/Ver3a.SLDPRT

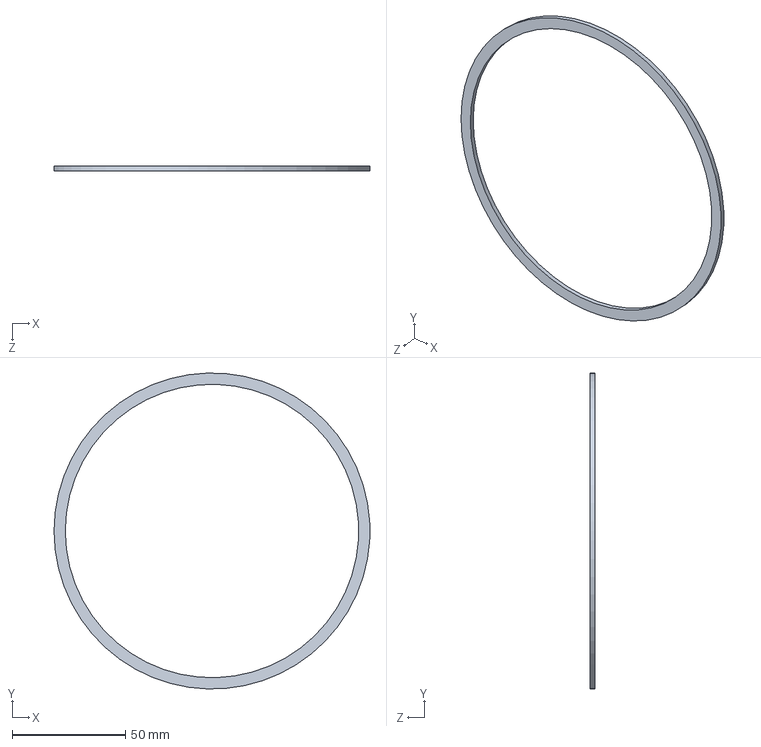
[picture p176: CAD file, 2026-10-10]
hardware/cad/solidworks/balun-support/Ver3a.SLDPRT
139.6 x 139.5 x 2.00 mm
