mauroleme/radiation-pattern-measurement-system/hardware/cad/stl/36Tpulley.STL

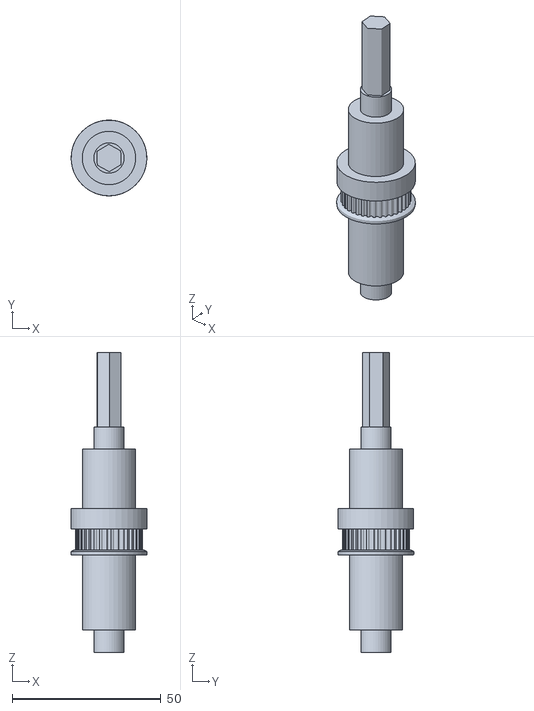
[picture p177: CAD file, 2026-10-10]
hardware/cad/stl/36Tpulley.STL
25.5 x 25.5 x 101.0
