mauroleme/radiation-pattern-measurement-system/hardware/cad/solidworks/balun-support/Ver2b.SLDPRT

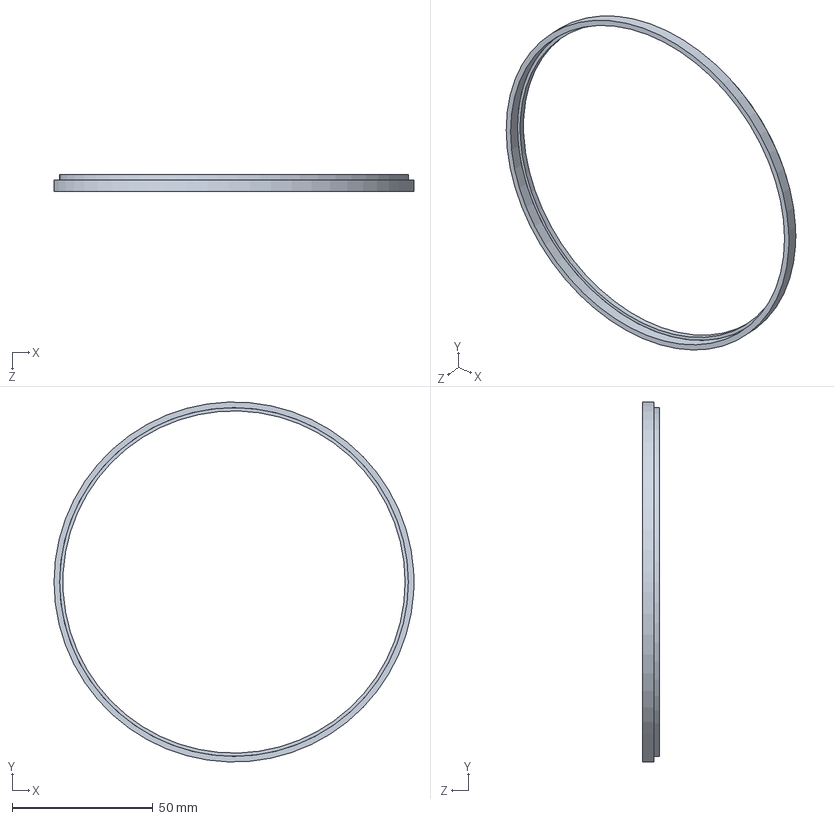
[picture p178: CAD file, 2026-10-10]
hardware/cad/solidworks/balun-support/Ver2b.SLDPRT
128.0 x 127.9 x 6.00 mm
