mauroleme/radiation-pattern-measurement-system/hardware/cad/solidworks/novoprtedopqn.SLDPRT

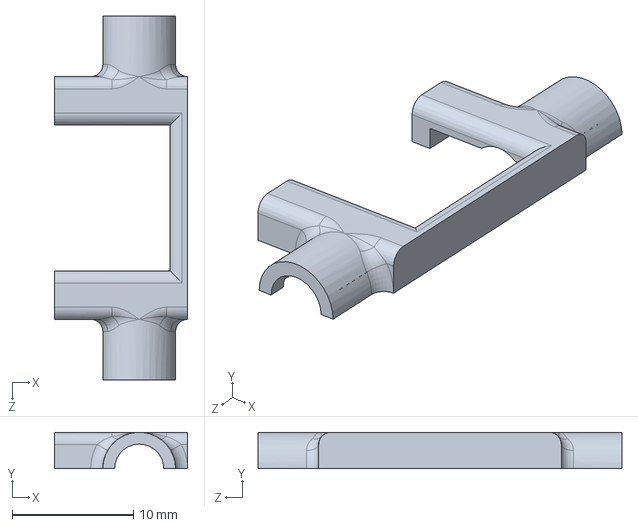
[picture p179: CAD file, 2026-10-10]
hardware/cad/solidworks/novoprtedopqn.SLDPRT
11.0 x 3.00 x 30.0 mm
