mauroleme/radiation-pattern-measurement-system/hardware/cad/stl/boom - prtedoboom-1.STL

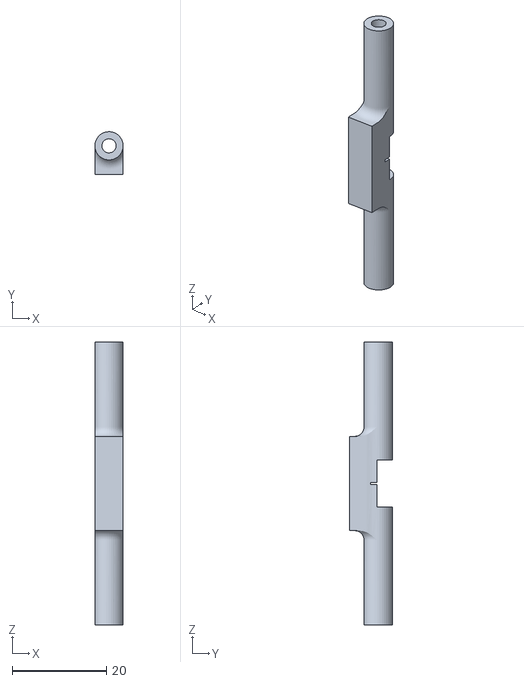
[picture p180: CAD file, 2026-10-10]
hardware/cad/stl/boom - prtedoboom-1.STL
6.00 x 9.05 x 60.0
