mauroleme/radiation-pattern-measurement-system/hardware/cad/solidworks/balun-support/Ver2a.SLDPRT

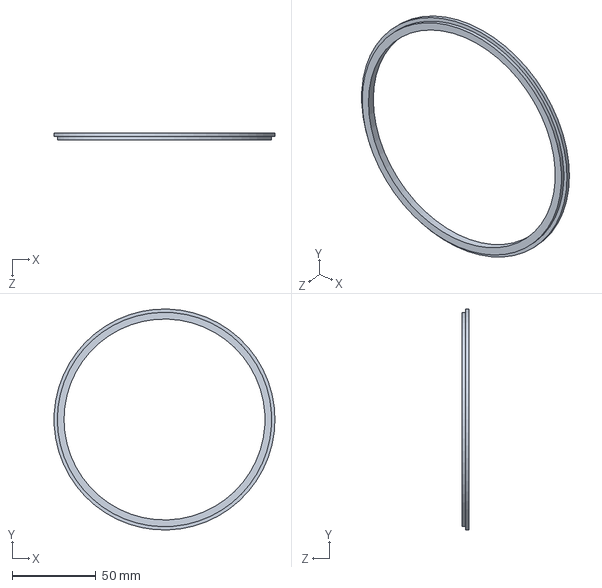
[picture p181: CAD file, 2026-10-10]
hardware/cad/solidworks/balun-support/Ver2a.SLDPRT
132.0 x 131.9 x 4.00 mm
