mauroleme/radiation-pattern-measurement-system/hardware/cad/solidworks/quadra_interior.SLDPRT

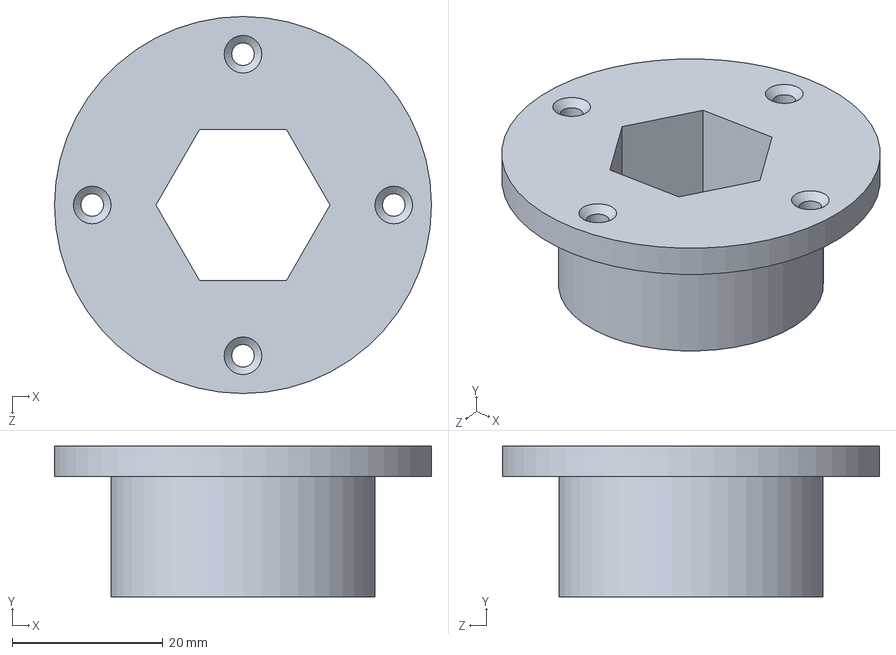
[picture p182: CAD file, 2026-10-10]
hardware/cad/solidworks/quadra_interior.SLDPRT
50.0 x 20.0 x 50.0 mm
