mauroleme/radiation-pattern-measurement-system/hardware/cad/stl/novopinohex.STL

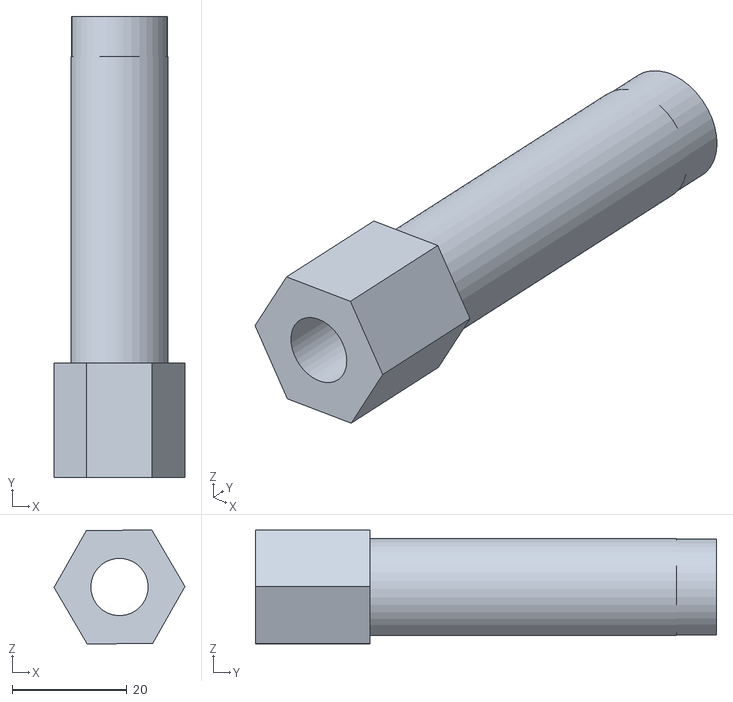
[picture p183: CAD file, 2026-10-10]
hardware/cad/stl/novopinohex.STL
22.9 x 80.5 x 19.9
