mauroleme/radiation-pattern-measurement-system/hardware/cad/solidworks/pinopartedebaixo.SLDPRT

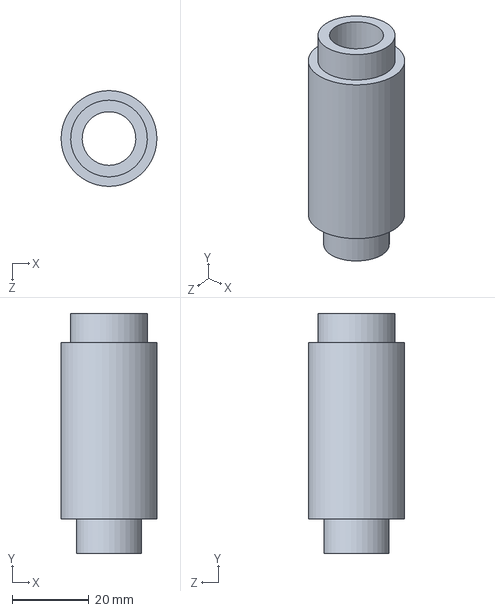
[picture p184: CAD file, 2026-10-10]
hardware/cad/solidworks/pinopartedebaixo.SLDPRT
25.0 x 62.6 x 25.0 mm
