mauroleme/radiation-pattern-measurement-system/hardware/cad/stl/boom - boom-1.STL

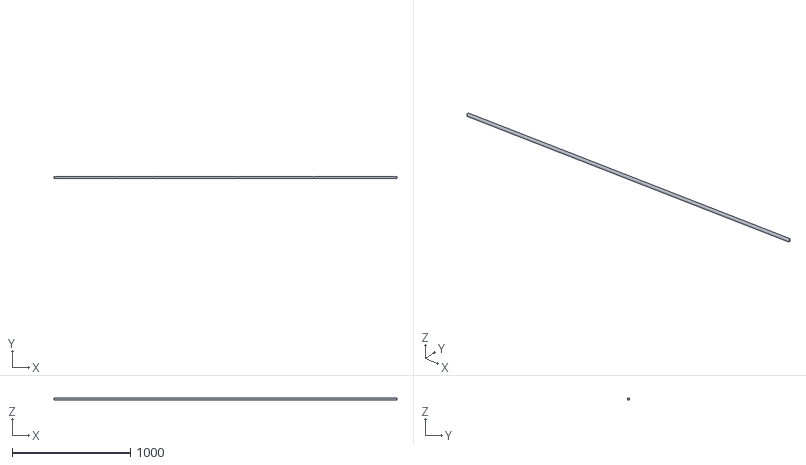
[picture p185: CAD file, 2026-10-10]
hardware/cad/stl/boom - boom-1.STL
2900.0 x 15.0 x 20.0
