mauroleme/radiation-pattern-measurement-system/hardware/cad/stl/base-circular-sem-furos.STL

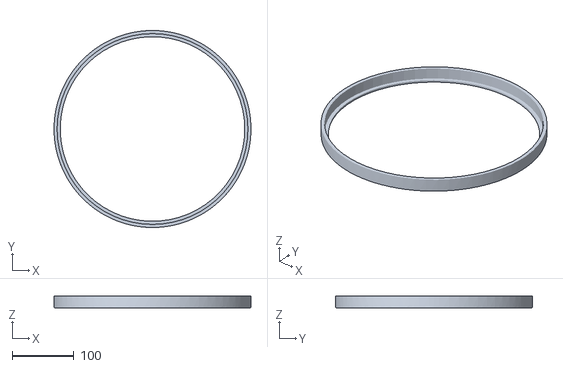
[picture p186: CAD file, 2026-10-10]
hardware/cad/stl/base-circular-sem-furos.STL
318.6 x 318.5 x 19.0
