mauroleme/radiation-pattern-measurement-system/hardware/cad/stl/boom.STL

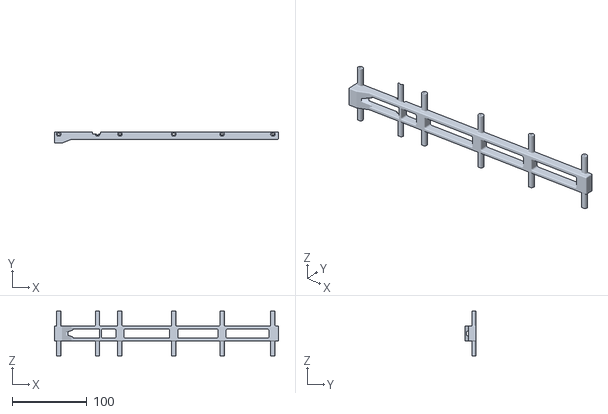
[picture p187: CAD file, 2026-10-10]
hardware/cad/stl/boom.STL
300.0 x 15.0 x 60.0
