mauroleme/radiation-pattern-measurement-system/hardware/cad/stl/apoios.STL

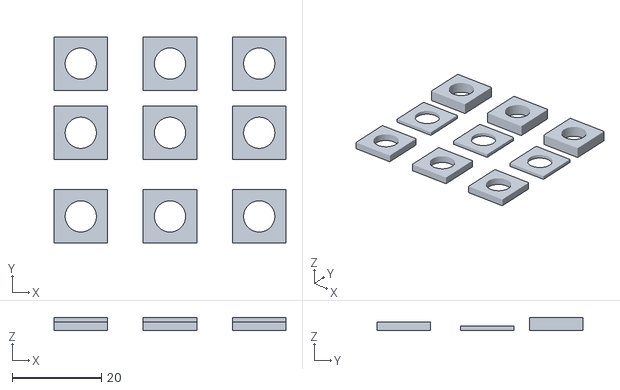
[picture p188: CAD file, 2026-10-10]
hardware/cad/stl/apoios.STL
52.0 x 46.3 x 3.00
