mauroleme/radiation-pattern-measurement-system/hardware/cad/stl/parte_de_cima.STL

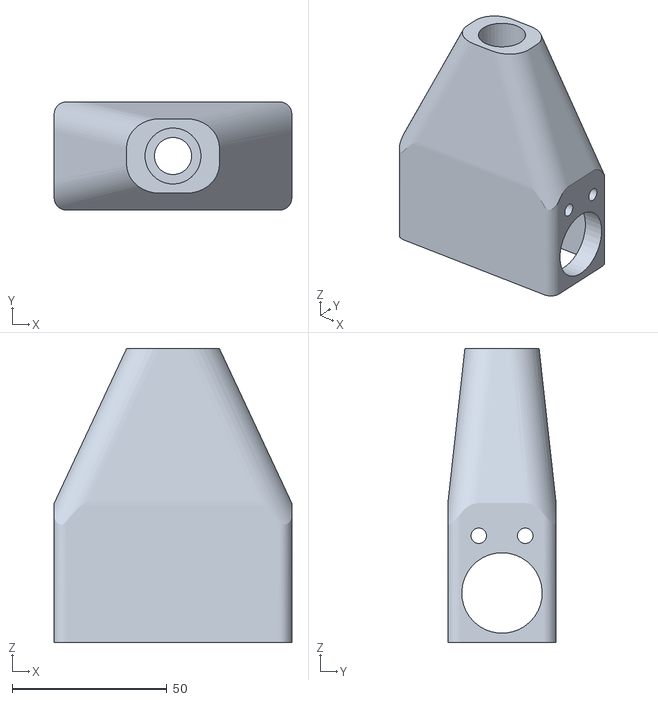
[picture p189: CAD file, 2026-10-10]
hardware/cad/stl/parte_de_cima.STL
76.8 x 35.0 x 95.0
