mauroleme/radiation-pattern-measurement-system/hardware/cad/stl/tampadopecomprotecao.STL

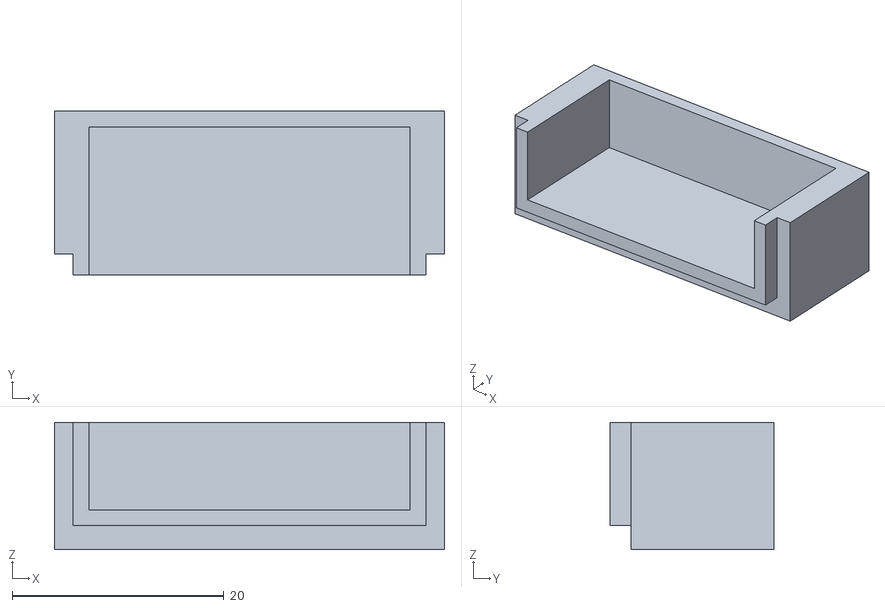
[picture p190: CAD file, 2026-10-10]
hardware/cad/stl/tampadopecomprotecao.STL
36.8 x 15.5 x 12.0
