mauroleme/radiation-pattern-measurement-system/hardware/cad/stl/Part6.STL

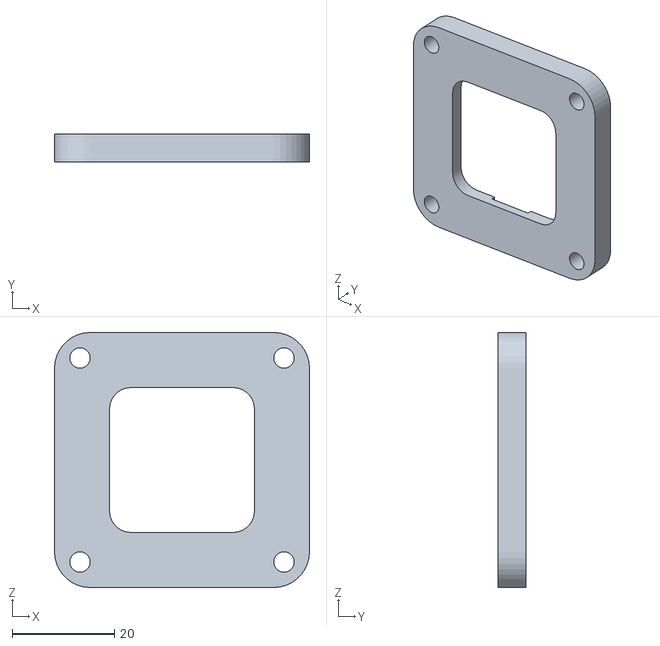
[picture p191: CAD file, 2026-10-10]
hardware/cad/stl/Part6.STL
50.0 x 5.50 x 50.0
