mauroleme/radiation-pattern-measurement-system/hardware/cad/stl/novopino.STL

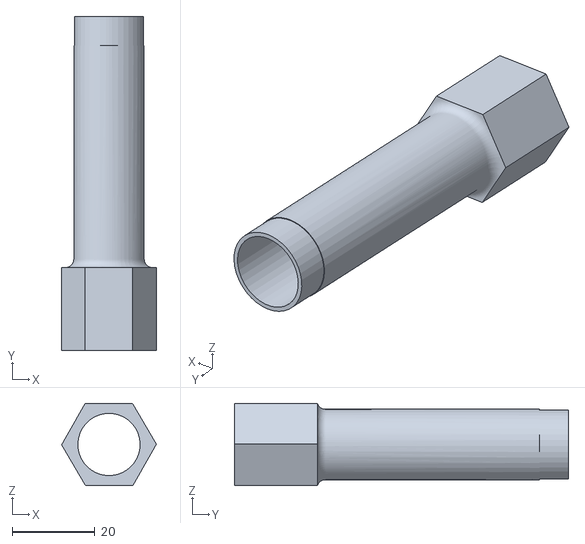
[picture p192: CAD file, 2026-10-10]
hardware/cad/stl/novopino.STL
22.9 x 80.5 x 19.9
