mauroleme/radiation-pattern-measurement-system/hardware/cad/stl/tira.STL

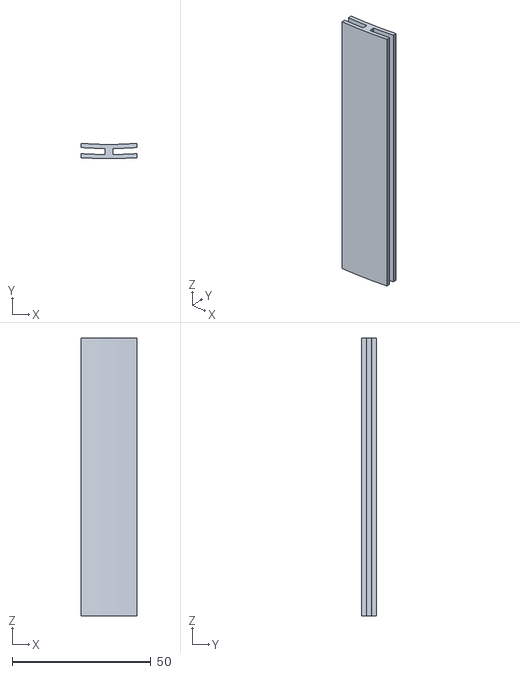
[picture p193: CAD file, 2026-10-10]
hardware/cad/stl/tira.STL
20.0 x 5.45 x 100.0
