mauroleme/radiation-pattern-measurement-system/hardware/cad/stl/pecomprotecao.STL

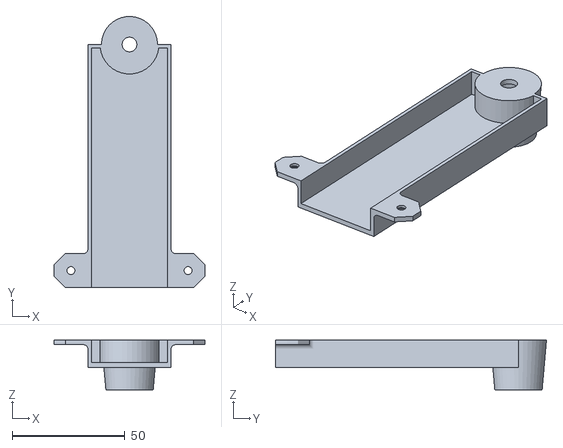
[picture p194: CAD file, 2026-10-10]
hardware/cad/stl/pecomprotecao.STL
66.8 x 120.0 x 22.0
