mauroleme/radiation-pattern-measurement-system/hardware/cad/stl/uyflyy.STL

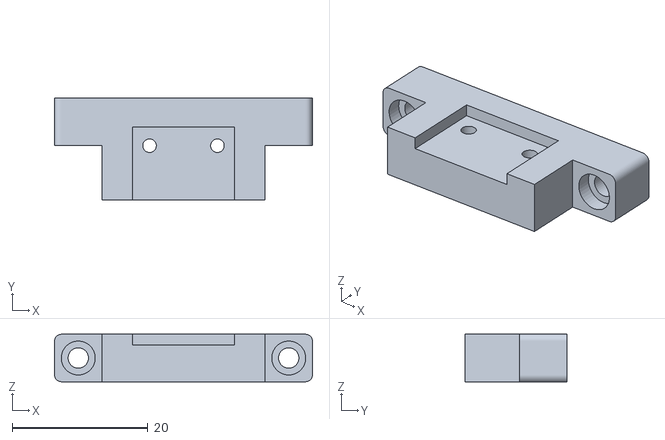
[picture p195: CAD file, 2026-10-10]
hardware/cad/stl/uyflyy.STL
38.0 x 15.0 x 7.00
