mauroleme/radiation-pattern-measurement-system/hardware/cad/stl/novapartedecima.STL

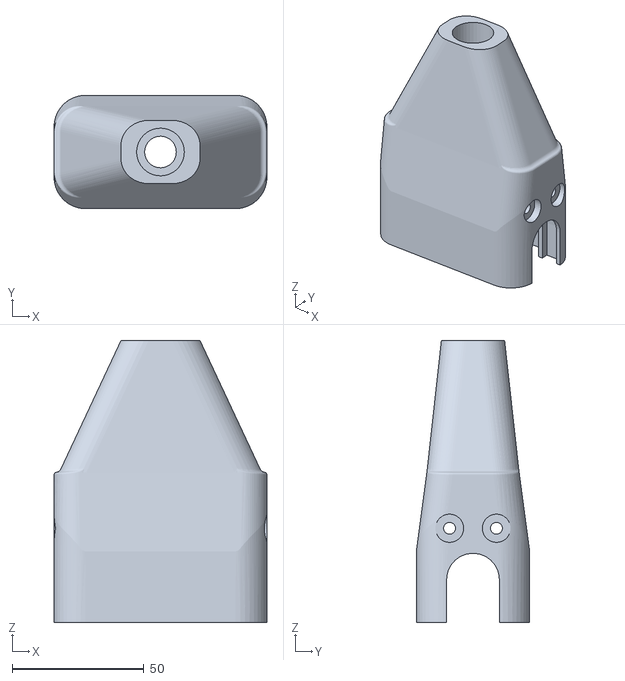
[picture p196: CAD file, 2026-10-10]
hardware/cad/stl/novapartedecima.STL
80.8 x 43.0 x 107.0
