mauroleme/radiation-pattern-measurement-system/hardware/cad/stl/circulonovo.STL

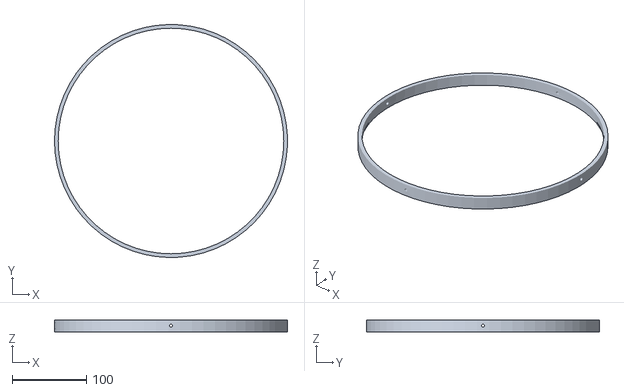
[picture p197: CAD file, 2026-10-10]
hardware/cad/stl/circulonovo.STL
313.0 x 313.0 x 16.0
