mauroleme/radiation-pattern-measurement-system/hardware/cad/stl/second_step_motor_box.STL

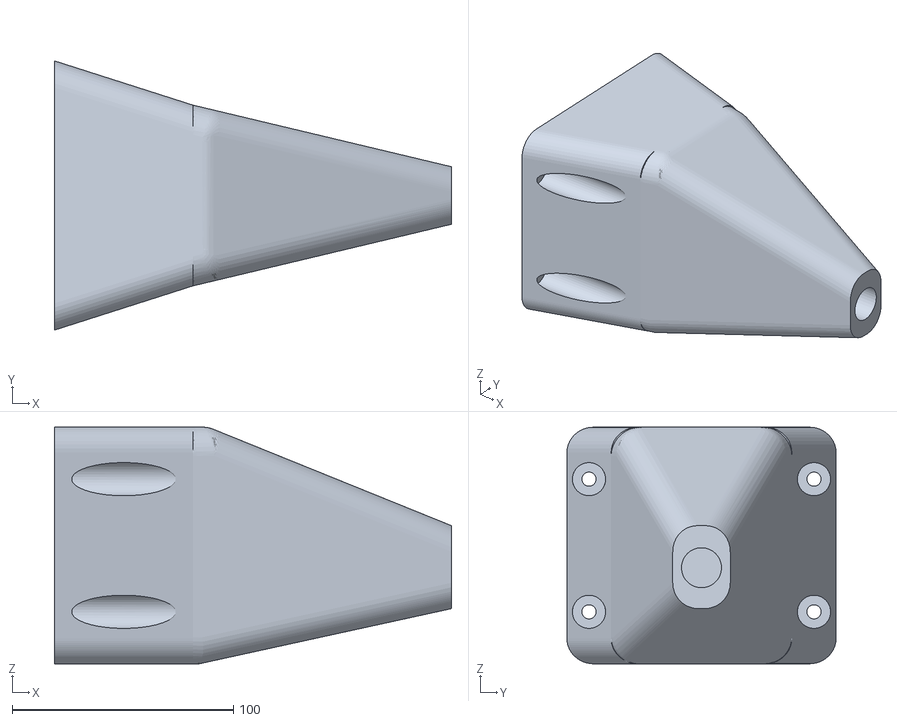
[picture p198: CAD file, 2026-10-10]
hardware/cad/stl/second_step_motor_box.STL
179.5 x 121.7 x 107.0
