mauroleme/radiation-pattern-measurement-system/hardware/cad/stl/pino.STL

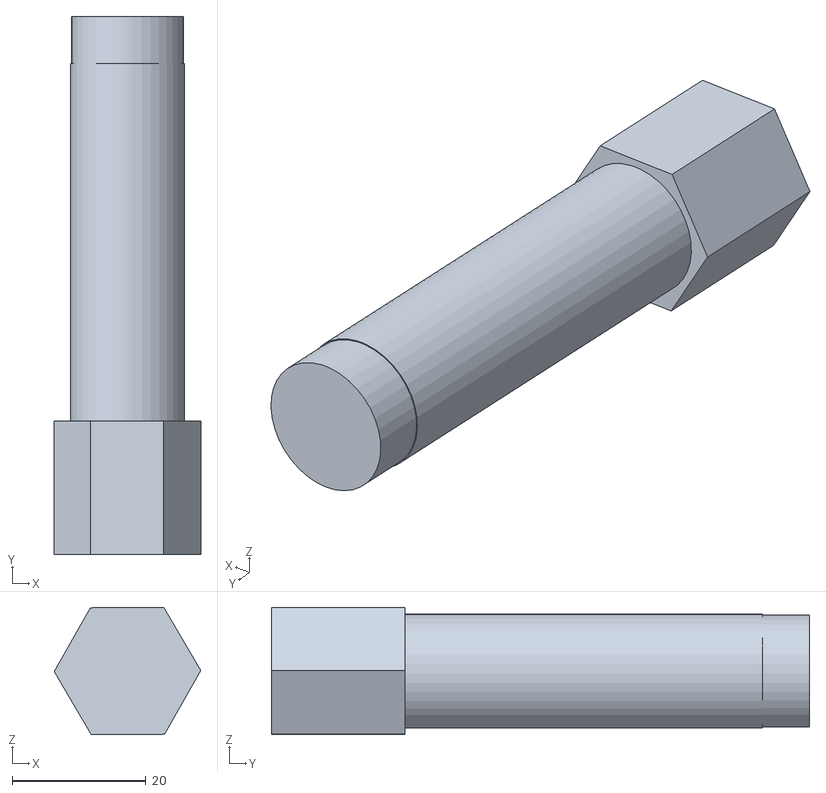
[picture p199: CAD file, 2026-10-10]
hardware/cad/stl/pino.STL
21.9 x 80.5 x 19.1
