mauroleme/radiation-pattern-measurement-system/hardware/cad/stl/c3.stl

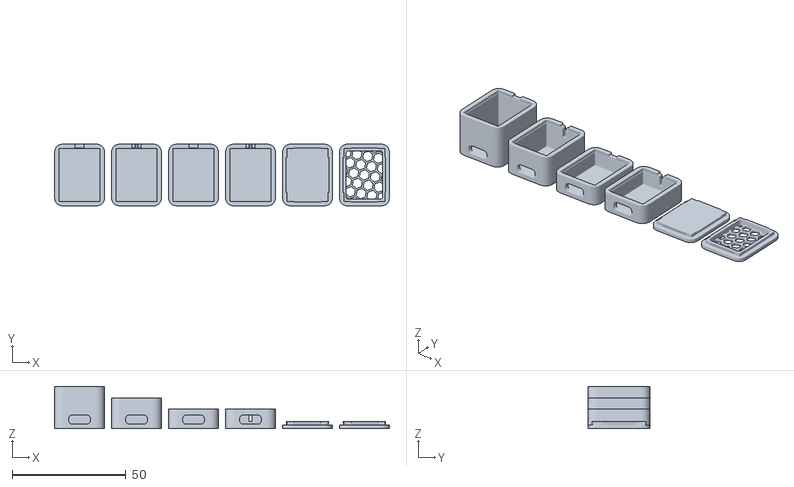
[picture p200: CAD file, 2026-10-10]
hardware/cad/stl/c3.stl
147.0 x 27.2 x 18.5
