mauroleme/radiation-pattern-measurement-system/hardware/cad/stl/tampa_traseira.STL

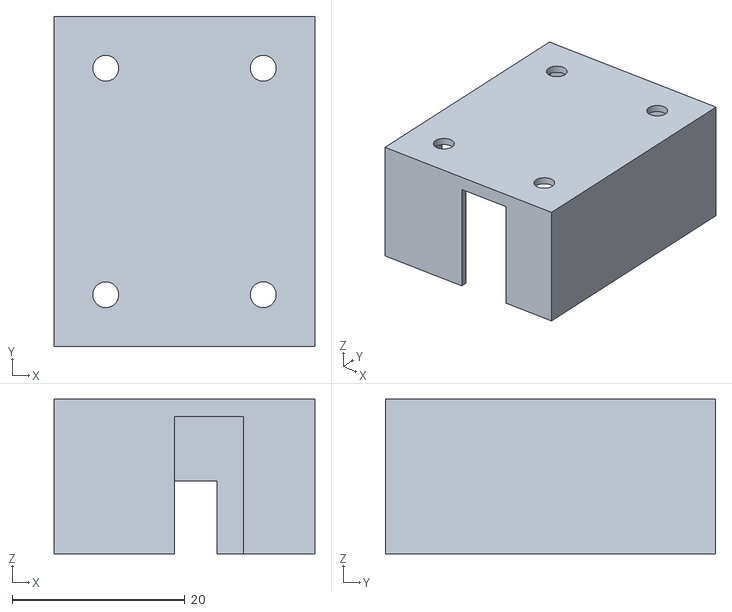
[picture p201: CAD file, 2026-10-10]
hardware/cad/stl/tampa_traseira.STL
30.2 x 38.2 x 17.9
