mauroleme/radiation-pattern-measurement-system/hardware/cad/stl/126T_pulley.STL

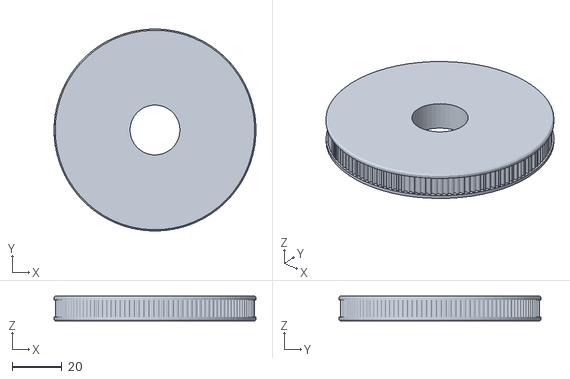
[picture p202: CAD file, 2026-10-10]
hardware/cad/stl/126T_pulley.STL
81.0 x 81.0 x 10.0
