mauroleme/radiation-pattern-measurement-system/hardware/cad/stl/72T_pulley.STL

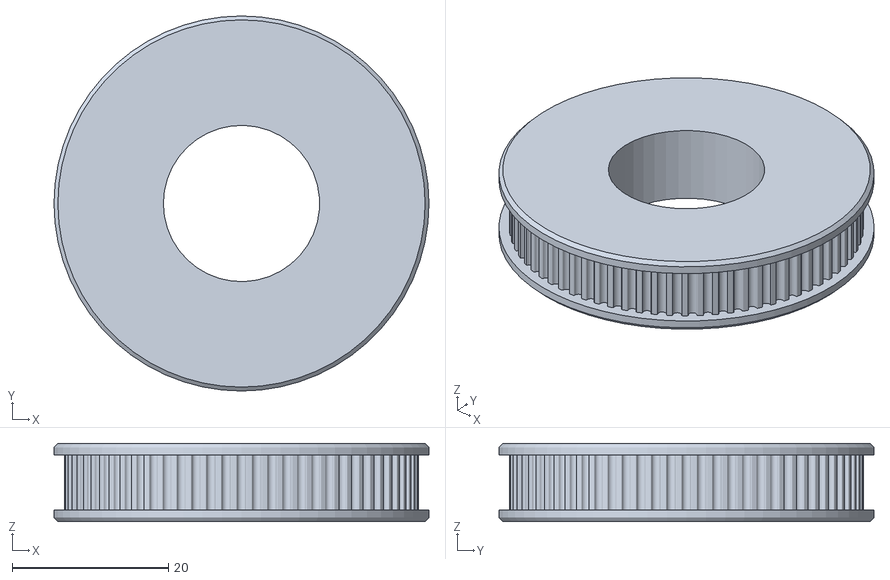
[picture p203: CAD file, 2026-10-10]
hardware/cad/stl/72T_pulley.STL
48.0 x 48.0 x 10.0
