mauroleme/radiation-pattern-measurement-system/hardware/cad/stl/pe.STL

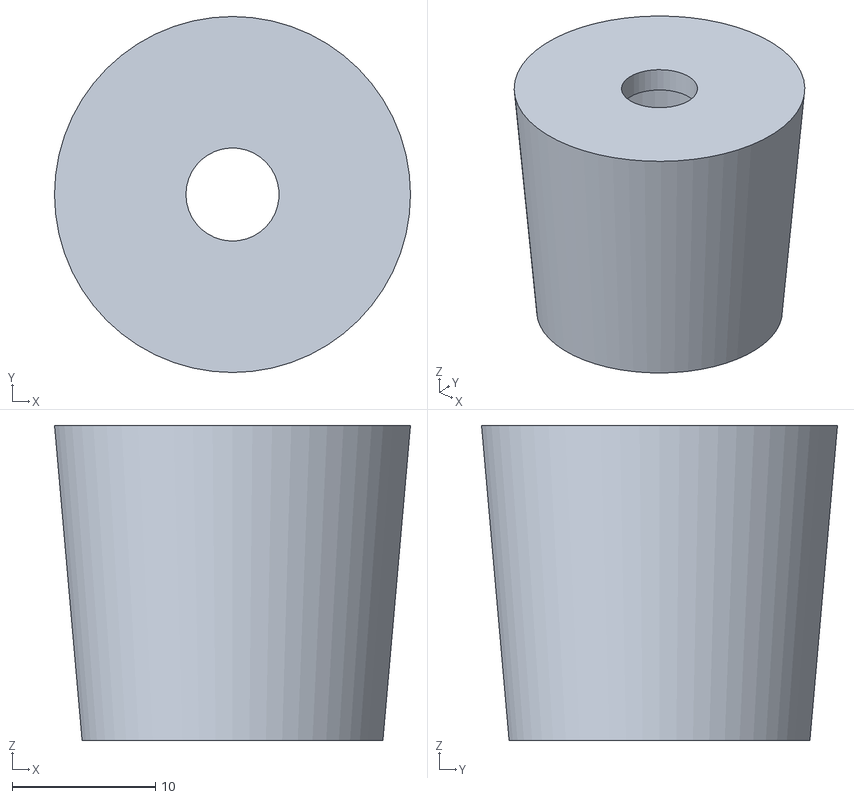
[picture p204: CAD file, 2026-10-10]
hardware/cad/stl/pe.STL
24.8 x 24.8 x 22.0
