mauroleme/radiation-pattern-measurement-system/hardware/cad/stl/sup_ant_transm.STL

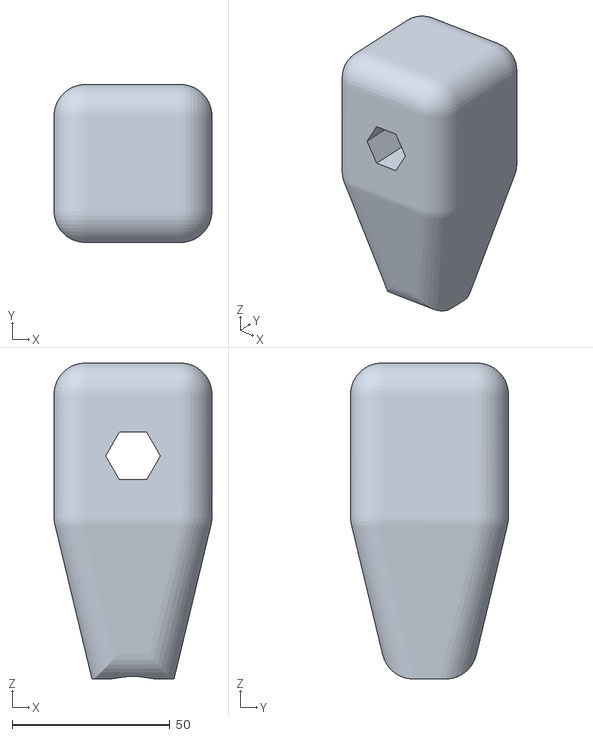
[picture p205: CAD file, 2026-10-10]
hardware/cad/stl/sup_ant_transm.STL
50.0 x 50.0 x 100.0
