mauroleme/radiation-pattern-measurement-system/hardware/cad/stl/adp.STL

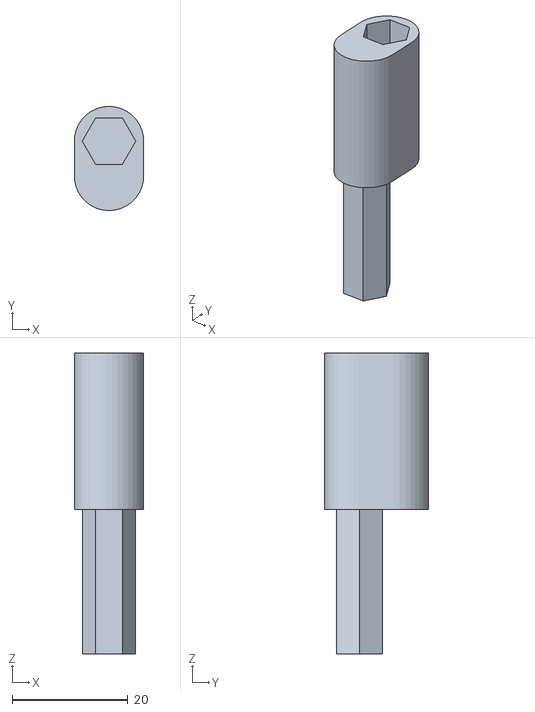
[picture p206: CAD file, 2026-10-10]
hardware/cad/stl/adp.STL
12.0 x 18.0 x 52.0
