mauroleme/radiation-pattern-measurement-system/hardware/cad/stl/basedecima.STL

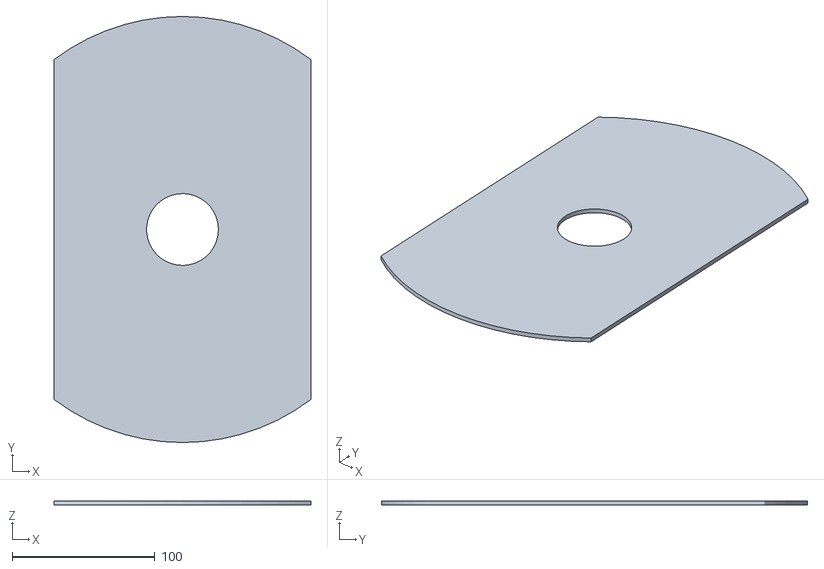
[picture p207: CAD file, 2026-10-10]
hardware/cad/stl/basedecima.STL
180.0 x 298.4 x 3.00
