mauroleme/radiation-pattern-measurement-system/hardware/cad/solidworks/Assem1258.SLDASM

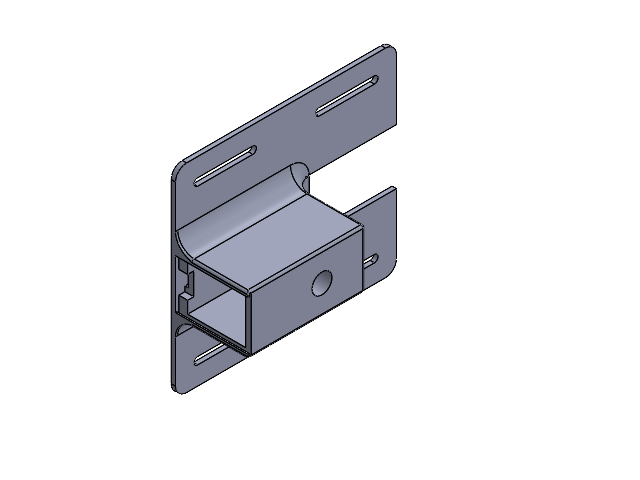
[picture p208: CAD file, 2026-10-10]
hardware/cad/solidworks/Assem1258.SLDASM
step motor box
polia-dimensão-de-20-dentes
