mauroleme/radiation-pattern-measurement-system/(list of files, cad)

Other CAD files:
hardware/cad/solidworks/novoboom.SLDPRT
hardware/cad/stl/boom - prtedoboom-5.STL
hardware/cad/stl/novopinofurado.STL
hardware/cad/stl/boom - prtedoboom-4.STL
hardware/cad/stl/boom - prtedoboom-3.STL
hardware/cad/stl/boom - prtedoboom-6.STL
hardware/cad/stl/boom - prtedoboom-2.STL
hardware/cad/solidworks/balun-support/Ver2a.STL
hardware/cad/solidworks/balun-support/Ver2b.STL
hardware/cad/solidworks/balun-support/Ver3a.STL
hardware/cad/solidworks/balun-support/Ver3b.STL
hardware/cad/solidworks/balun-support/forma1.STL
hardware/cad/solidworks/balun-support/forma2.STL
hardware/cad/stl/ant.stl
hardware/cad/stl/novoboom.STL
hardware/cad/stl/novoprtedopqn.STL
hardware/cad/stl/pinopartedebaixo.STL
hardware/cad/stl/pinopartedecima.STL
hardware/cad/stl/prtedopqn.STL
