mauroleme/radiation-pattern-measurement-system/hardware/cad/previews/second_step_motor_box.png

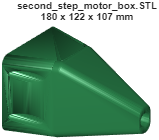
hardware/cad/previews/second_step_motor_box.png
