mauroleme/radiation-pattern-measurement-system/measurements/2025-08-22_full-system_2d-and-3d/Imagens/sim.pdf

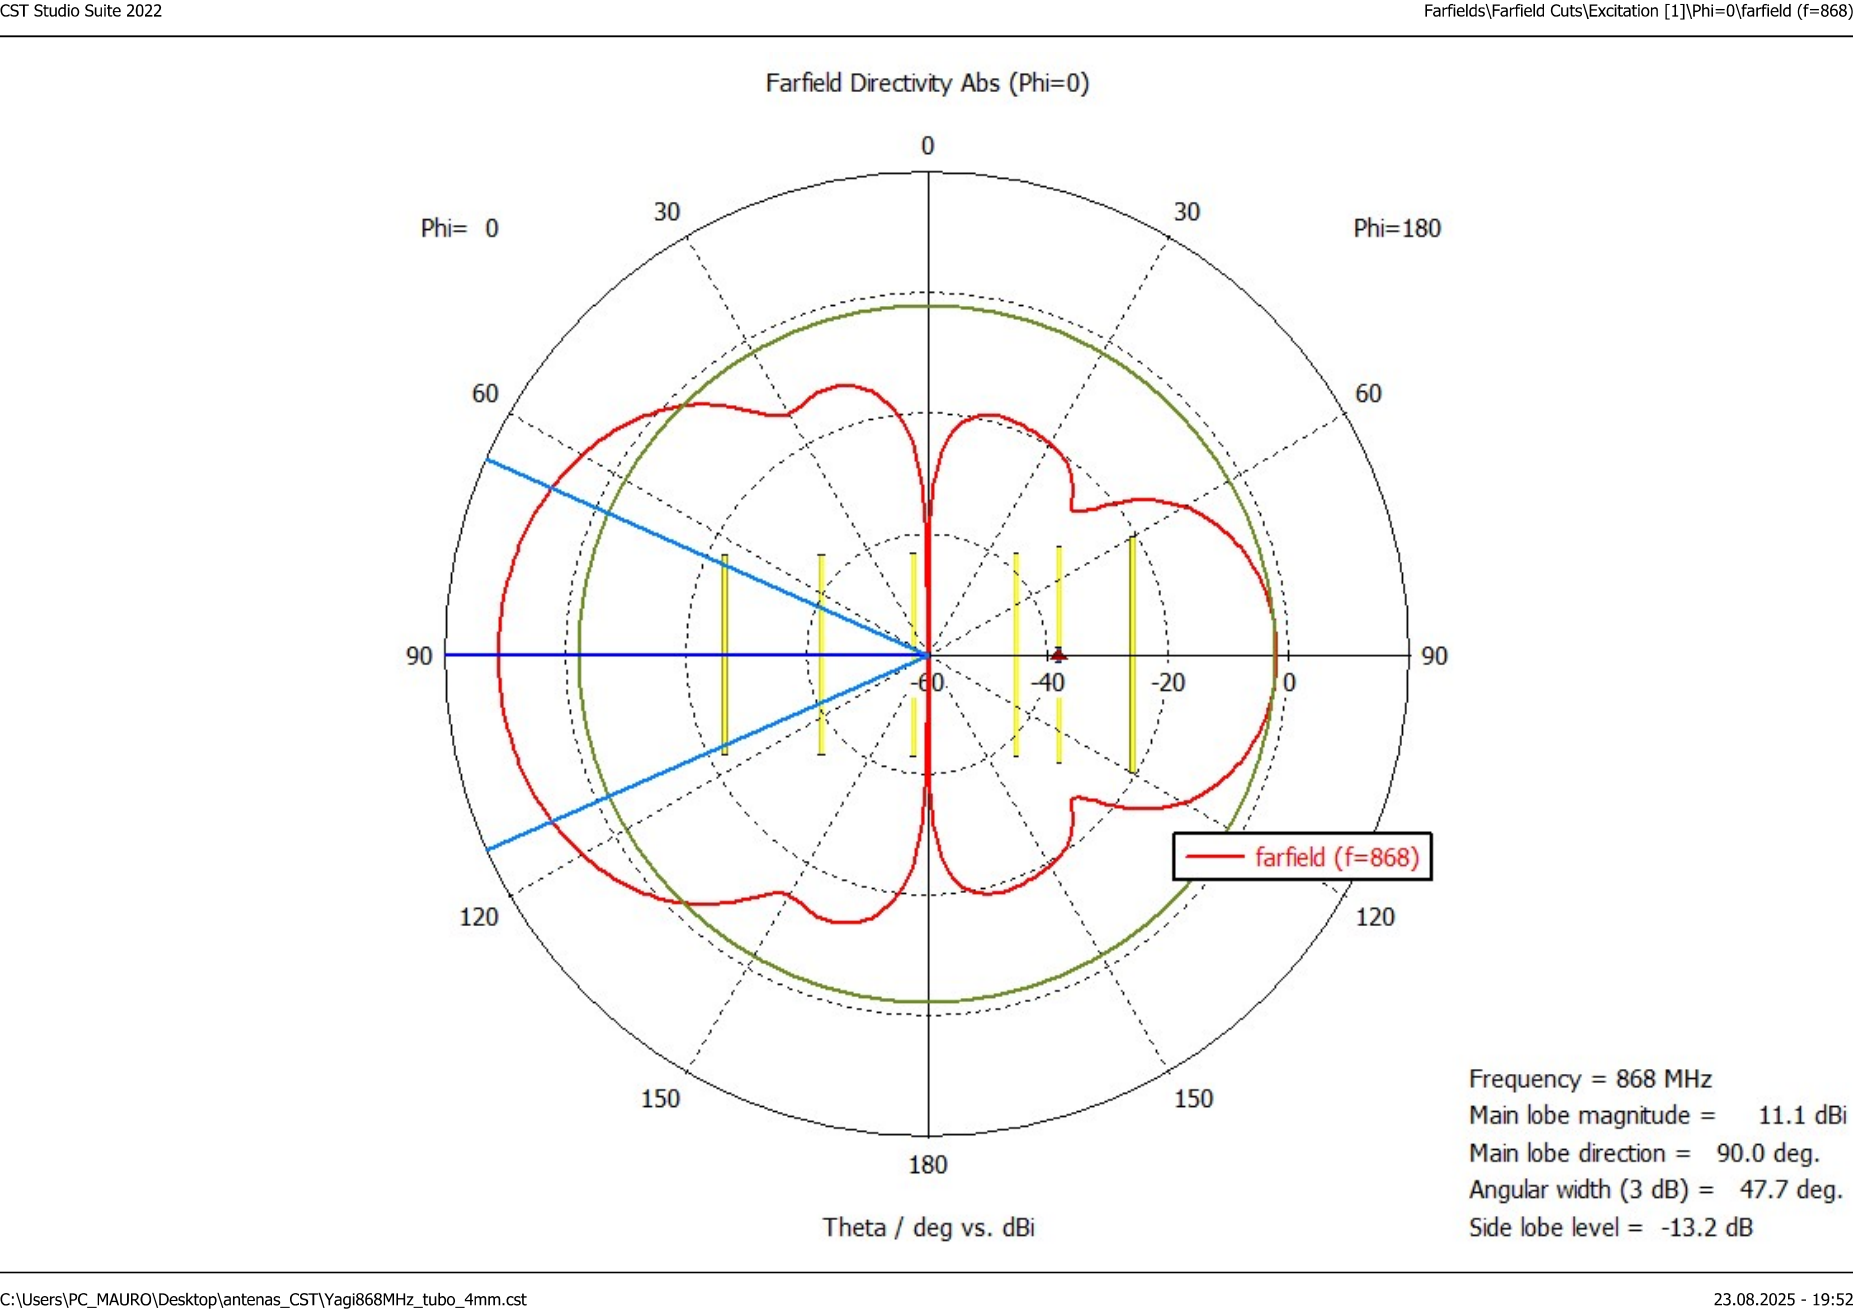
[picture p210: page 1]
