mauroleme/radiation-pattern-measurement-system/measurements/2025-04-23_component-characterisation/Ensaio_provisóri2o.xlsx

Angulo | dB
0 | -8
45 | -18.2
90 | -39
135 | -41
180 | -25.6
225 | -42
270 | -39
315 | -24
