mauroleme/radiation-pattern-measurement-system/measurements/2025-04-23_component-characterisation/Ensaio_provisóri2o_com_filtro.xlsx

Sheet: Distancia 2.5m Filtro
Angulo | dB
0 | -5.9
45 | -31.5
90 | -33.5
135 | -31
180 | -22.4
225 | -37.5
270 | -33.8
315 | -31.5
360 | -5.9

Sheet: Distancia 2m Filtro
Angulo | dB_cfiltro | dB_sfiltro
0 | -3.7 | -2
45 | -24 | -27
90 | -32 | -32
135 | -32 | -31
180 | -23 | -21
225 | -35 | -29.6
270 | -47 | -40
315 | -24 | -30
360 | -3.7 | -1.9
