mauroleme/radiation-pattern-measurement-system/measurements/2025-04-23_component-characterisation/Ensaio_provisório.xlsx

Ângulo | dB
0 | -8
45 | -18.2
90 | -39
135 | -41
180 | -25.6
-45 | -24
-90 | -39
-135 | -42
