mauroleme/radiation-pattern-measurement-system/measurements/2025-07-26_filter-balun_pcb-characterisation/average-10_measurements.xlsx

 |  | MEASUREMENT - WITH 868 MHz FILTER AND BALUN
 |  | in dBm
0.0001 | theta degree | 1 | 2 | 3 | 4 | 5 | 6 | 7 | 8 | 9 | 10 | AVERAGE | theta degree |  | ordem | 1 | 2 | 3 | 4 | 5 | 6 | 7 | 8 | 9 | 10
 | -180 | -19.1921 | -18.8630 | -19.1105 | -18.8711 | -19.1458 | -18.6479 | -18.6992 | -17.8498 |  |  | -18.7974 | 0 | -364390 | 1 | -191921 | -188630 | -191105 | -188711 | -191458 | -186479 | -186992 | -178498
 | -175 | -19.9594 | -19.2111 | -19.4046 | -19.2004 | -19.5462 | -19.0009 | -19.0695 | -18.0593 |  |  | -19.1814 | 5 | -372458 | 2 | -199594 | -192111 | -194046 | -192004 | -195462 | -190009 | -190695 | -180593
 | -170 | -20.5315 | -19.6624 | -19.7247 | -19.7312 | -19.8033 | -19.2365 | -19.3285 | -18.0704 |  |  | -19.5111 | 10 | -382983 | 3 | -205315 | -196624 | -197247 | -197312 | -198033 | -192365 | -193285 | -180704
 | -165 | -21.8727 | -20.3611 | -20.7346 | -20.4398 | -20.7444 | -20.2244 | -20.4159 | -18.8885 |  |  | -20.4602 | 15 | -390253 | 4 | -218727 | -203611 | -207346 | -204398 | -207444 | -202244 | -204159 | -188885
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
