mauroleme/radiation-pattern-measurement-system/measurements/2025-07-26_filter-balun_pcb-characterisation/average-10_measurements_with-balun.xlsx

 |  | MEASUREMENT - WITH 868 MHz FILTER AND BALUN
 |  | in dBm
0.0001 | theta degree | 1 | 2 | 3 | 4 | 5 | 6 | 7 | 8 | 9 | 10 | 11 | 12 | 13 | 14 | 15 | AVERAGE | media real | ordem | 1 | 2 | 3 | 4 | 5 | 6 | 7 | 8 | 9 | 10 | 11 | 12 | 13 | 14 | 15 | media7 primeiros | media sem o 7 medição
 | 0 | -19.1921 | -18.8630 | -19.1105 | -18.8711 | -19.1458 | -18.6479 | -18.6992 | -17.8498 | -18.0244 | -17.9976 | -17.8909 | -17.4900 | -17.9482 | -18.0248 | -17.8856 | -18.3761 | -17.8889 | 1 | -191921 | -188630 | -191105 | -188711 | -191458 | -186479 | -186992 | -178498 | -180244 | -179976 | -178909 | -174900 | -179482 | -180248 | -178856 | -18.9328 | -18.4109 | =
 | 5 | -19.9594 | -19.2111 | -19.4046 | -19.2004 | -19.5462 | -19.0009 | -19.0695 | -18.0593 | -18.2392 | -18.1822 | -17.9725 | -17.7922 | -18.1389 | -18.1252 | -18.0764 | -18.6652 | -18.0732 | 2 | -199594 | -192111 | -194046 | -192004 | -195462 | -190009 | -190695 | -180593 | -182392 | -181822 | -179725 | -177922 | -181389 | -181252 | -180764 | -19.3417 | -18.7075
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
