mauroleme/radiation-pattern-measurement-system/measurements/2025-08-22_full-system_2d-and-3d/average-10_measurements.xlsx

MEASUREMENT - WITH 868 MHz FILTER - BALUN - IMPEDANCE MATCHING NETWORK |  |  |  |  |  |  |  |  |  |  |  |  |  |  | melhores
 |  |  | in dBm
 | 0.0001 | theta degree | 1 | 2 | 3 | 4 | 5 | 6 | 7 | 8 | 9 | 10 | AVERAGE | theta degree |  | ordem | 1 | 2 | 3 | 4 | 5 | 6 | 7 | 8 | 9 | 10
 |  | -180 | -20.3812 | -20.9835 | -21.3075 | -21.0264 | -21.9230 | -22.0992 | -20.7462 | -20.7109 | -21.8167 | -20.9805 | -21.1975 | 0 | -364390 | 1 | -203812 | -209835 | -213075 | -210264 | -219230 | -220992 | -207462 | -207109 | -218167 | -209805
 |  | -175 | -20.8255 | -21.8114 | -21.6401 | -21.3646 | -22.2517 | -21.9796 | -21.0593 | -21.3267 | -22.2841 | -21.4394 | -21.5982 | 5 | -372458 | 2 | -208255 | -218114 | -216401 | -213646 | -222517 | -219796 | -210593 | -213267 | -222841 | -214394
 |  | -170 | -21.1704 | -22.3356 | -22.0979 | -21.9490 | -22.8502 | -22.9245 | -22.4439 | -22.3870 | -22.3681 | -21.9195 | -22.2446 | 10 | -382983 | 3 | -211704 | -223356 | -220979 | -219490 | -228502 | -229245 | -224439 | -223870 | -223681 | -219195
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
