mauroleme/radiation-pattern-measurement-system/measurements/first-measurement_antenna-only-and-with-filter/average-10_measurements.xlsx

Sheet: Sheet1
-35.02806 | -35.44443 | -36.04628 | -36.68711 | -37.28718 | -38.21227 | -39.17156 | -40.36432 | -41.50844 | -42.34514 | -42.67681 | -42.55174 | -42.09812 | -41.84553 | -42.11086 | -42.86943 | -44.4508 | -46.86863 | -49.72219 | -51.00802 | -51.97281 | -51.99575 | -50.61621 | -48.01226 | -43.99673 | -39.32147 | -35.20668 | -30.85992 | -27.0407 | -24.55288 | -22.51089 | -20.91243 | -19.75337 | -18.96935 | -18.38466 | -18.11876 | -18.02081 | -18.12199 | -18.55961 | -19.33903 | -20.30376 | -21.61791 | -23.39808 | -25.7716 | -28.66919 | -32.56656 | -38.57897 | -46.83621 | -49.88627 | -48.8828 | -49.07848 | -49.06391 | -47.26745 | -45.32475 | -44.65252 | -45.19314 | -46.85363 | -48.32707 | -46.6904 | -43.73
 | 1e-13 |  |  | MEASUREMENT - WITHOUT 868 MHz FILTER
 | 0.0001 |  | theta degree | 1 | 2 | 3 | 4 | 5 | 6 | 7 | 8 | 9 | 10 |  | AVERAGE
 |  |  | -180 | -37.122 | -36.4390 | -35.1877 | -34.5936 | -34.3394 | -34.923 | -35.0231 | -34.3934 | -34.8502 | -33.4092 |  | -35.0281 | -180 | -35.0281 | -371220000000000 | -364390 | -351877 | -345936 | -343394 | -349230 | -350231 | -343934 | -348502 | -334092
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
