mauroleme/radiation-pattern-measurement-system/hardware/electronics/ad8313-calibration/dados_obtidos_empiricamente_e_modelo.xlsx

Sheet: Folha1
0 | 347.5 | 1.698435973
-5 | 341.5 | 1.669110459
-10 | 322.5 | 1.576246334
-20 | 284.4 | 1.390029326
-30 | 243.7 | 1.191104594
-40 | 206.1 | 1.007331378
-50 | 169.8 | 0.8299120235
-60 | 142.5 | 0.6964809384

Sheet: Folha2
322.5 | -10
284.4 | -20
243.7 | -30
206.1 | -40
169.8 | -50
142.5 | -60
