mauroleme/radiation-pattern-measurement-system/hardware/bandpass-filter-868MHz/characterisation/fig3.png

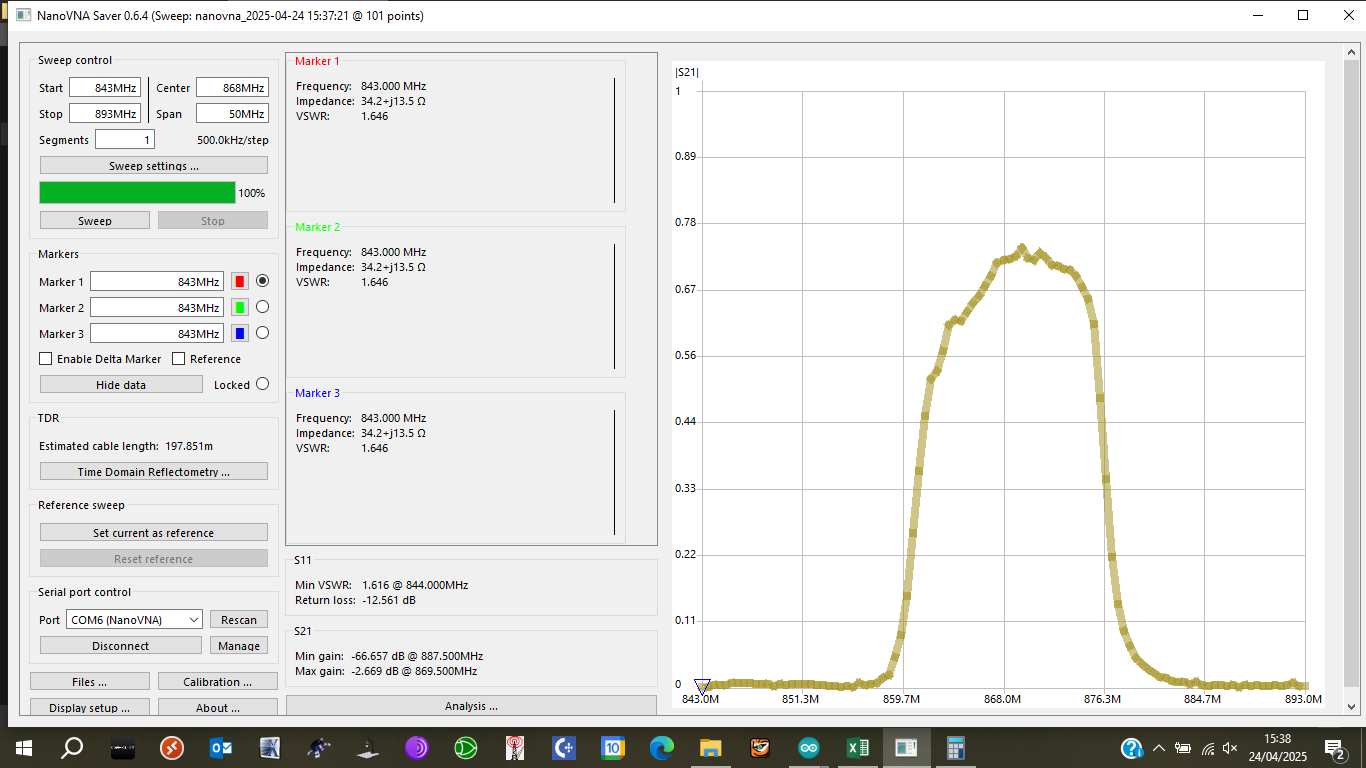
hardware/bandpass-filter-868MHz/characterisation/fig3.png
