mauroleme/radiation-pattern-measurement-system/hardware/bandpass-filter-868MHz/characterisation/fig4.png

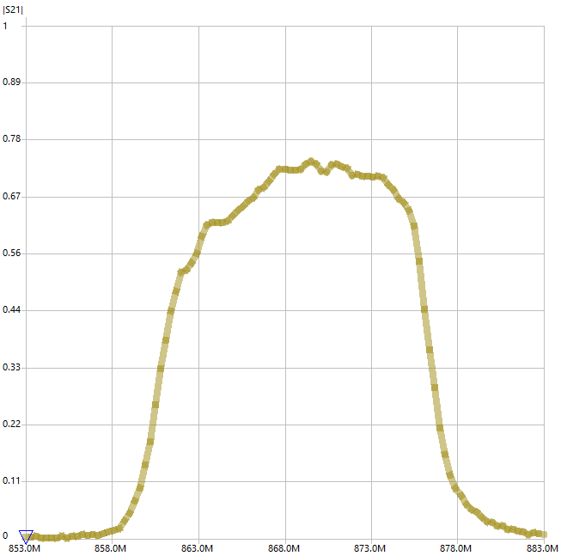
hardware/bandpass-filter-868MHz/characterisation/fig4.png
