mauroleme/radiation-pattern-measurement-system/hardware/electronics/ad8313-calibration/curva AD8313 - V por dBm.png

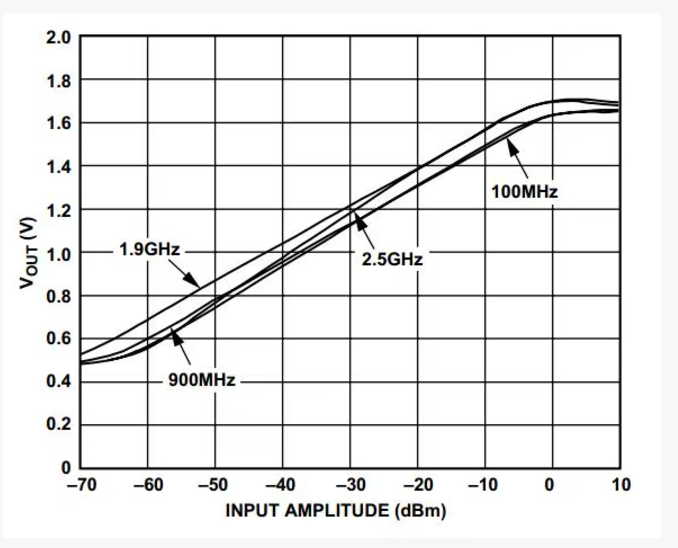
hardware/electronics/ad8313-calibration/curva AD8313 - V por dBm.png
