mauroleme/radiation-pattern-measurement-system/matlab/development/2024-12_first-version/first_test_monopole.jpg

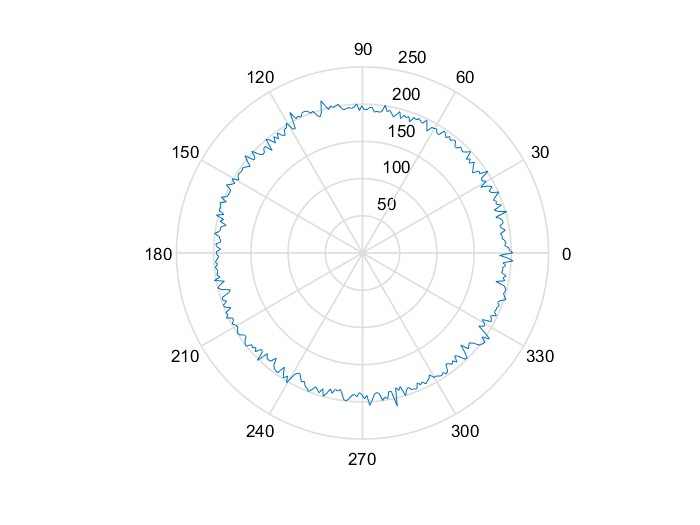
matlab/development/2024-12_first-version/first_test_monopole.jpg
