mauroleme/radiation-pattern-measurement-system/measurements/2025-04-23_component-characterisation/Amplificadores/Sem Título.png

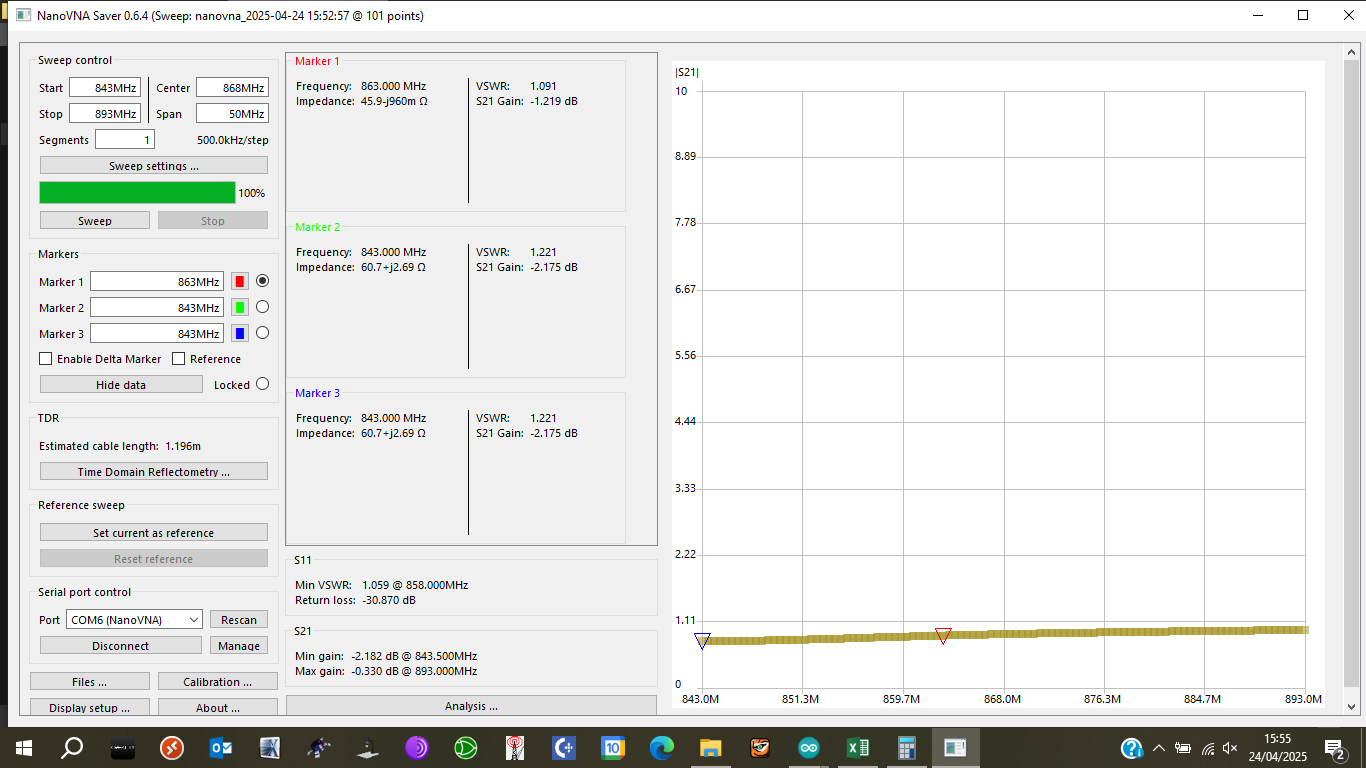
measurements/2025-04-23_component-characterisation/Amplificadores/Sem Título.png
