mauroleme/radiation-pattern-measurement-system/measurements/2025-04-23_component-characterisation/Antena Recetora/Caraterização VNA/Fig6.png

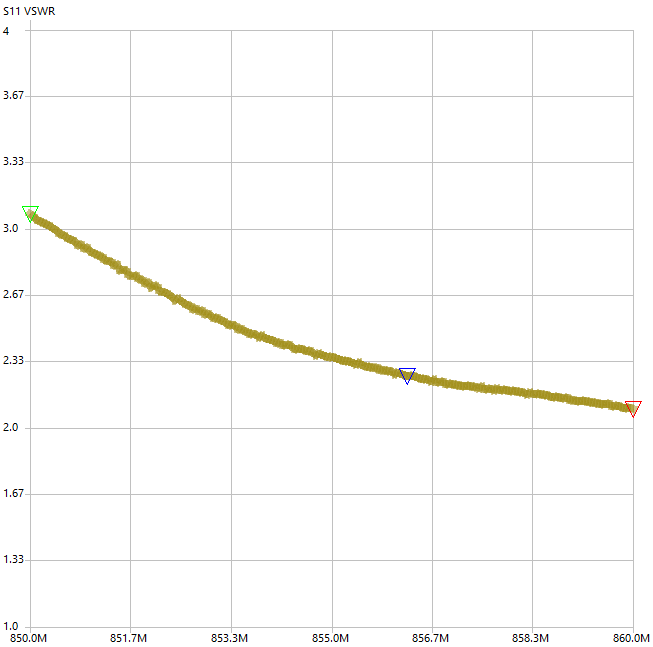
measurements/2025-04-23_component-characterisation/Antena Recetora/Caraterização VNA/Fig6.png
