mauroleme/radiation-pattern-measurement-system/measurements/2025-04-23_component-characterisation/Antena Transmissora/Caraterização VNA/Fig1.png

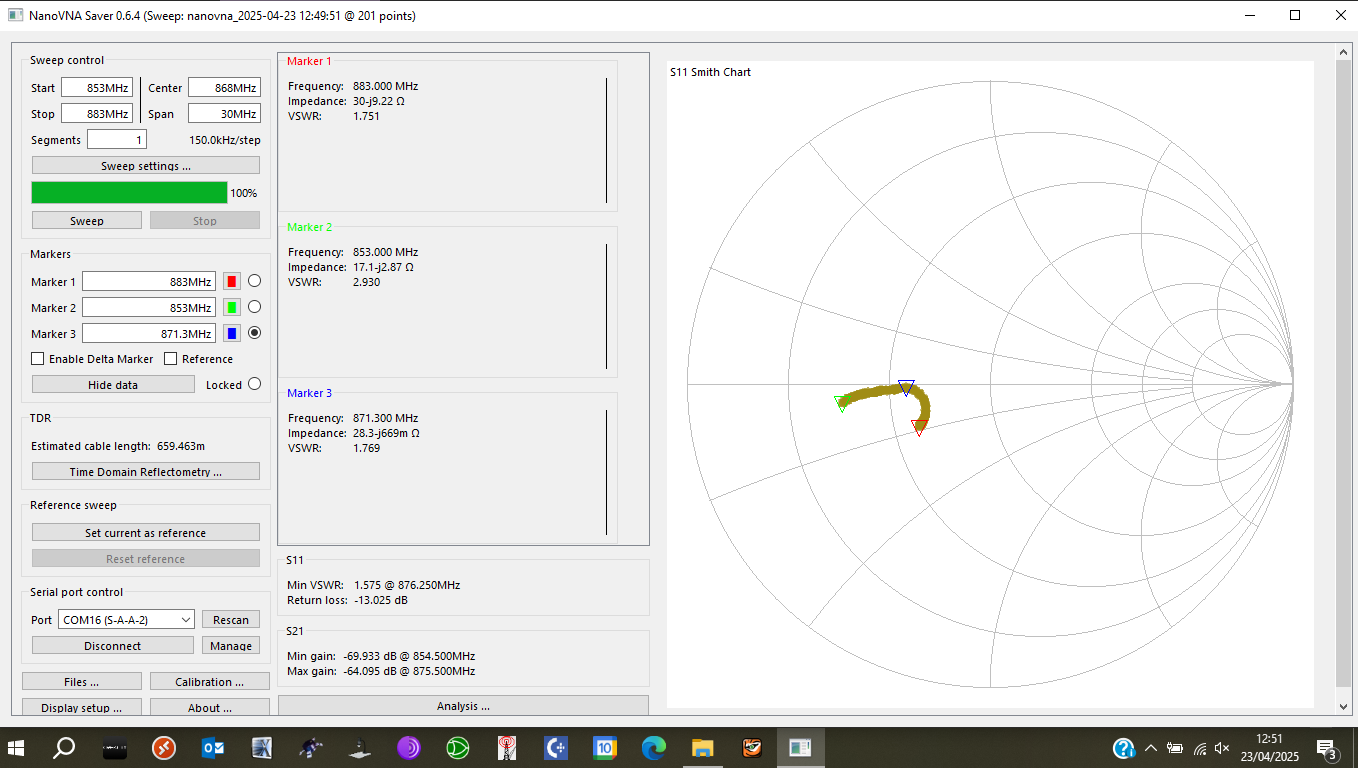
measurements/2025-04-23_component-characterisation/Antena Transmissora/Caraterização VNA/Fig1.png
