mauroleme/radiation-pattern-measurement-system/measurements/2025-04-23_component-characterisation/Antena Transmissora/Caraterização VNA/Fig4_v2.png

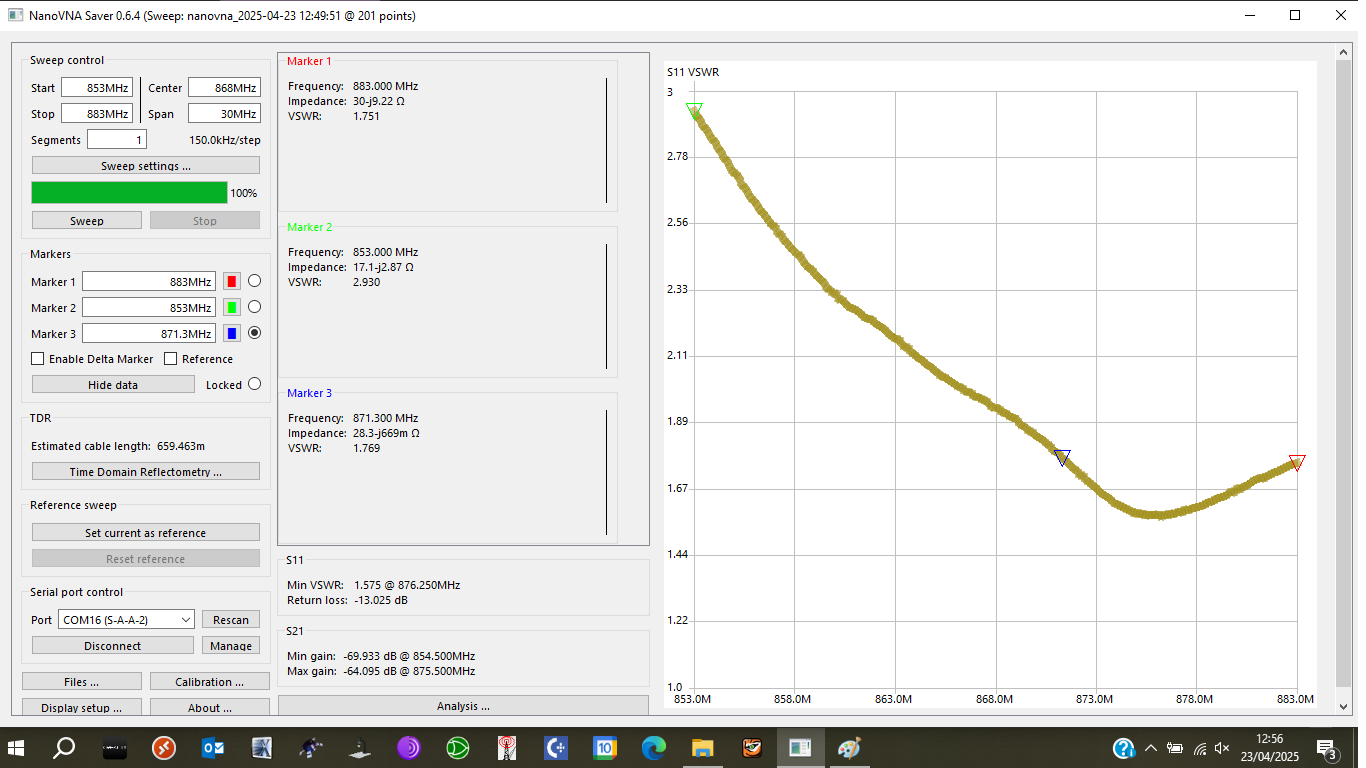
measurements/2025-04-23_component-characterisation/Antena Transmissora/Caraterização VNA/Fig4_v2.png
