mauroleme/radiation-pattern-measurement-system/measurements/2025-04-23_component-characterisation/Espectro/Teste do Gerador de Sinal/Rigol (SA)/mauro 2.png

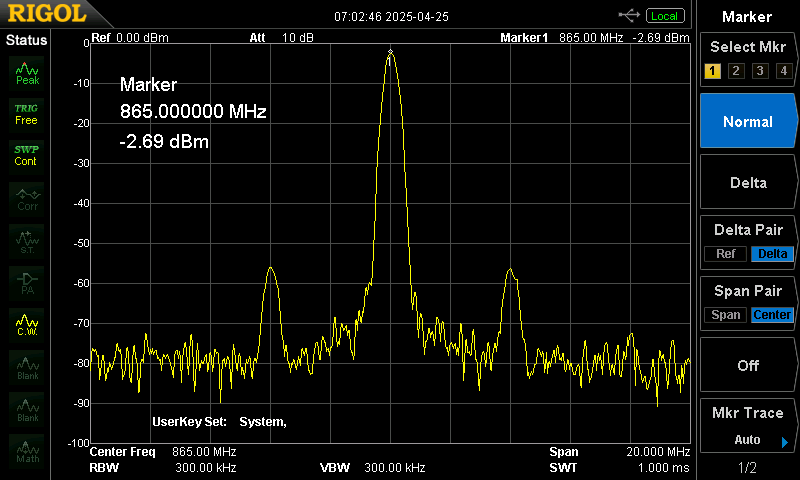
measurements/2025-04-23_component-characterisation/Espectro/Teste do Gerador de Sinal/Rigol (SA)/mauro 2.png
