mauroleme/radiation-pattern-measurement-system/measurements/2025-04-23_component-characterisation/Espectro/TX/noise_floor_Fig2.png

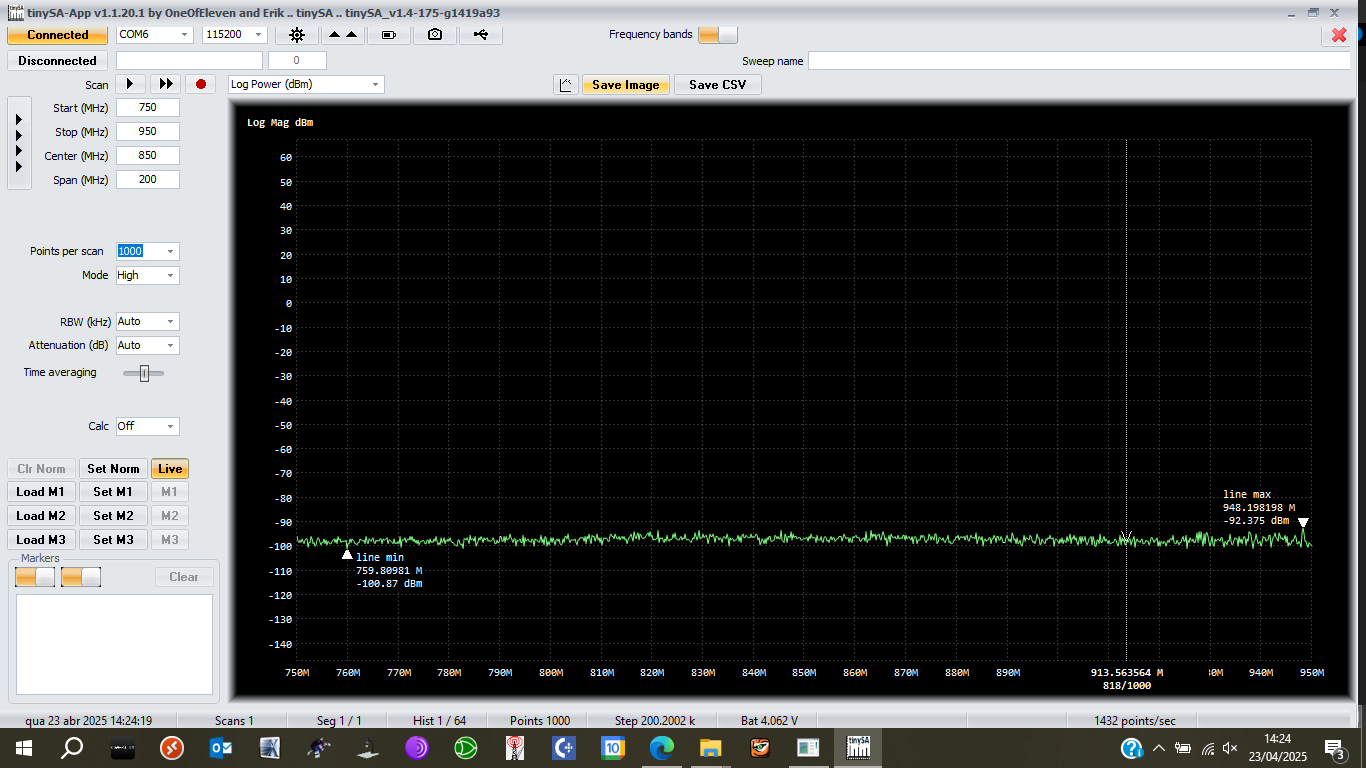
measurements/2025-04-23_component-characterisation/Espectro/TX/noise_floor_Fig2.png
