mauroleme/radiation-pattern-measurement-system/measurements/2025-04-23_component-characterisation/filtro/fig1a_settings.png

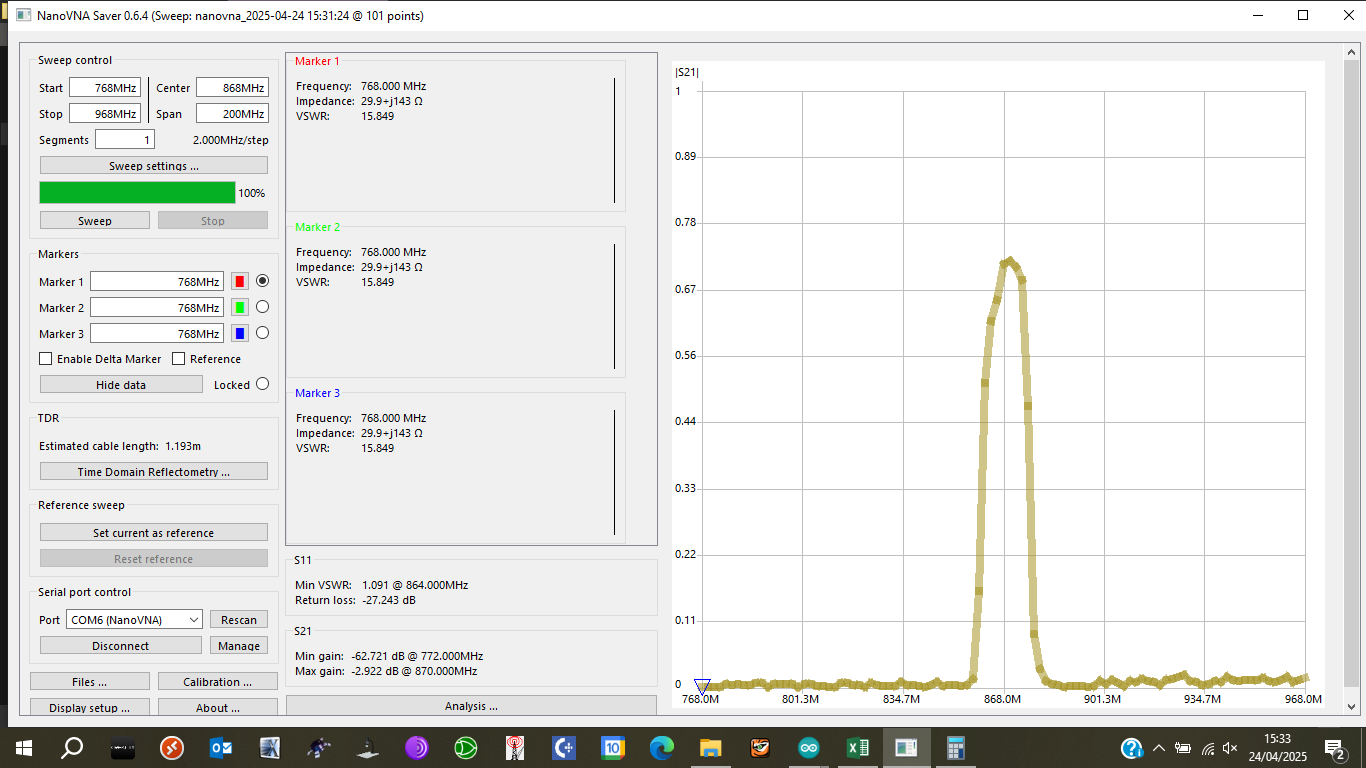
measurements/2025-04-23_component-characterisation/filtro/fig1a_settings.png
