mauroleme/radiation-pattern-measurement-system/measurements/2025-04-23_component-characterisation/Teste Gerador e SA/IMG_20250424_073434_517.jpg

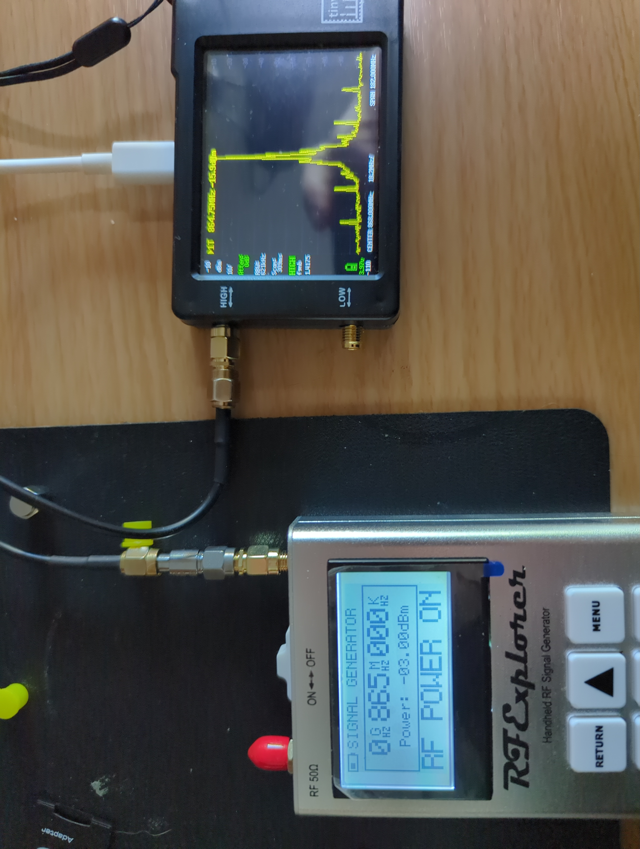
measurements/2025-04-23_component-characterisation/Teste Gerador e SA/IMG_20250424_073434_517.jpg
