mauroleme/radiation-pattern-measurement-system/measurements/2025-05-14_s11-and-farfield/ensaio2.png

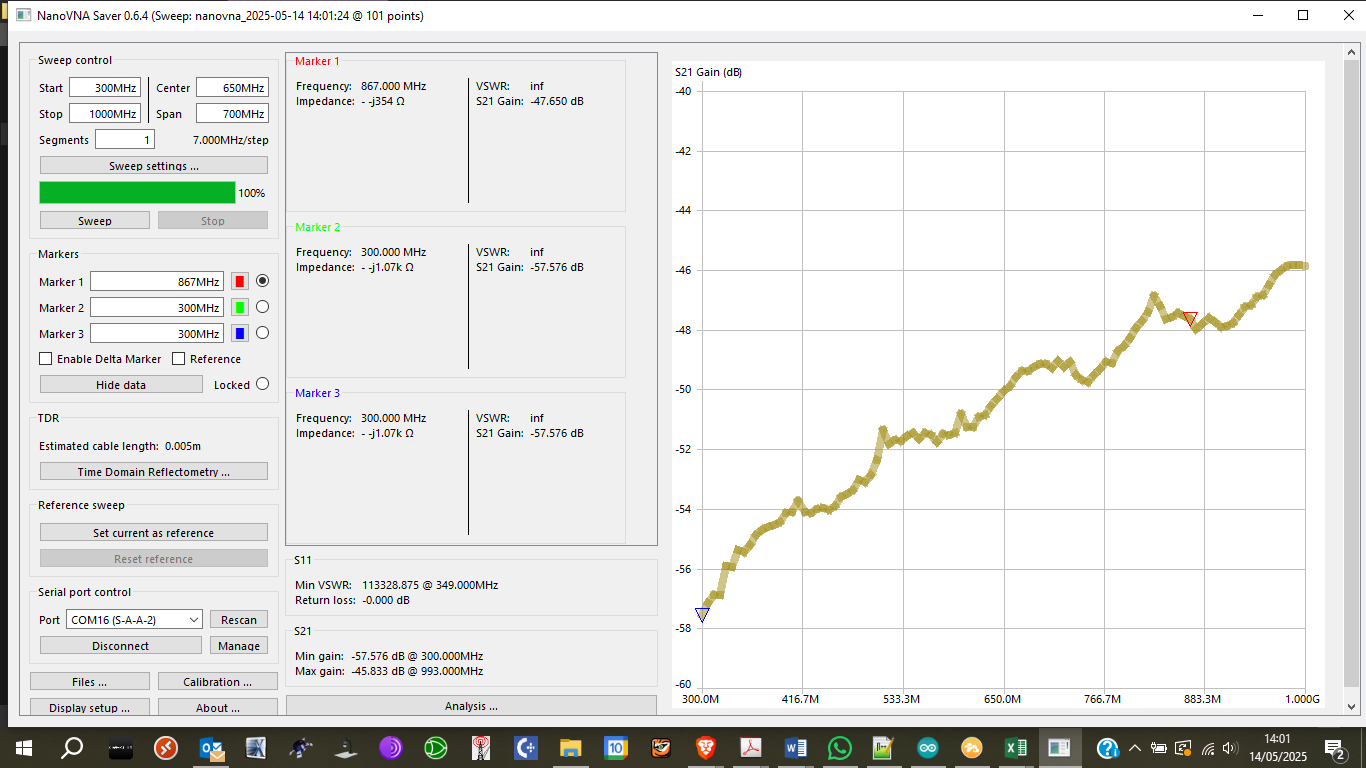
measurements/2025-05-14_s11-and-farfield/ensaio2.png
