mauroleme/radiation-pattern-measurement-system/measurements/2025-07-26_filter-balun_pcb-characterisation/carcaterização do PCB/S11 e S21 v2 completo.png

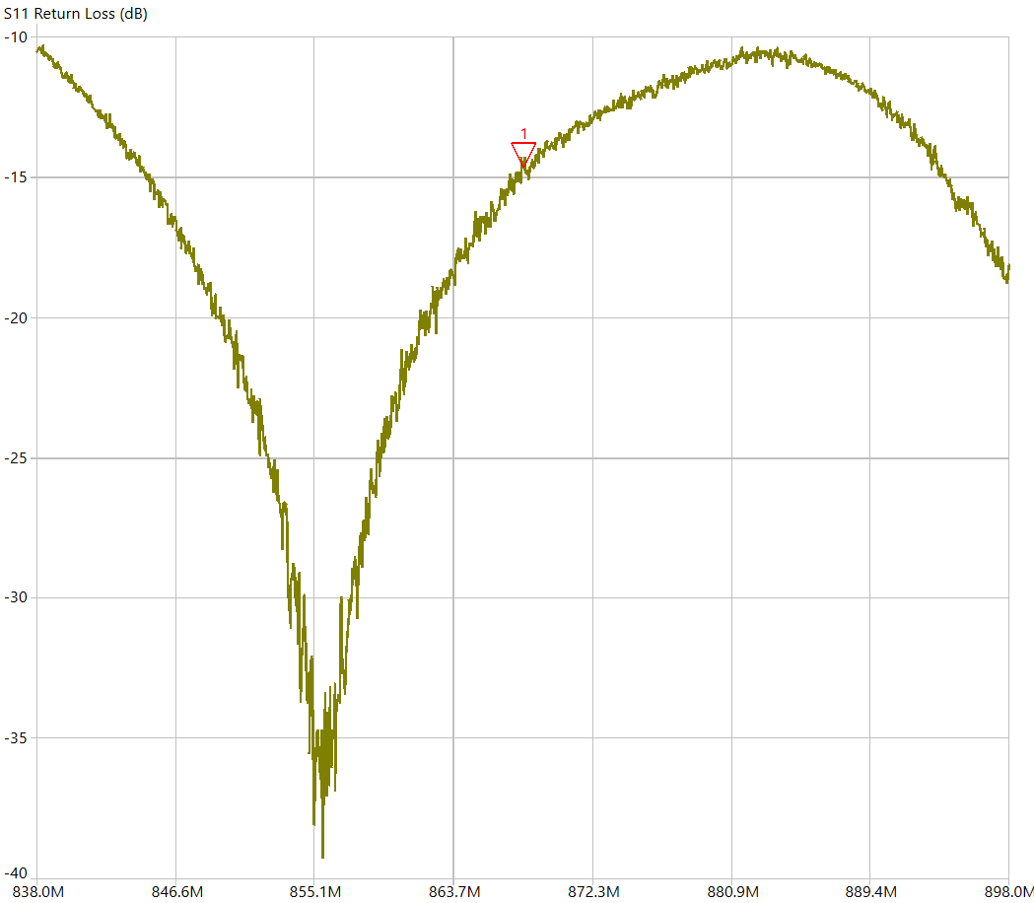
measurements/2025-07-26_filter-balun_pcb-characterisation/carcaterização do PCB/S11 e S21 v2 completo.png
