mauroleme/radiation-pattern-measurement-system/measurements/2025-07-26_filter-balun_pcb-characterisation/carcaterização do PCB/S11 e S21 v4 mais um L de 3.3 em serie Rx.png

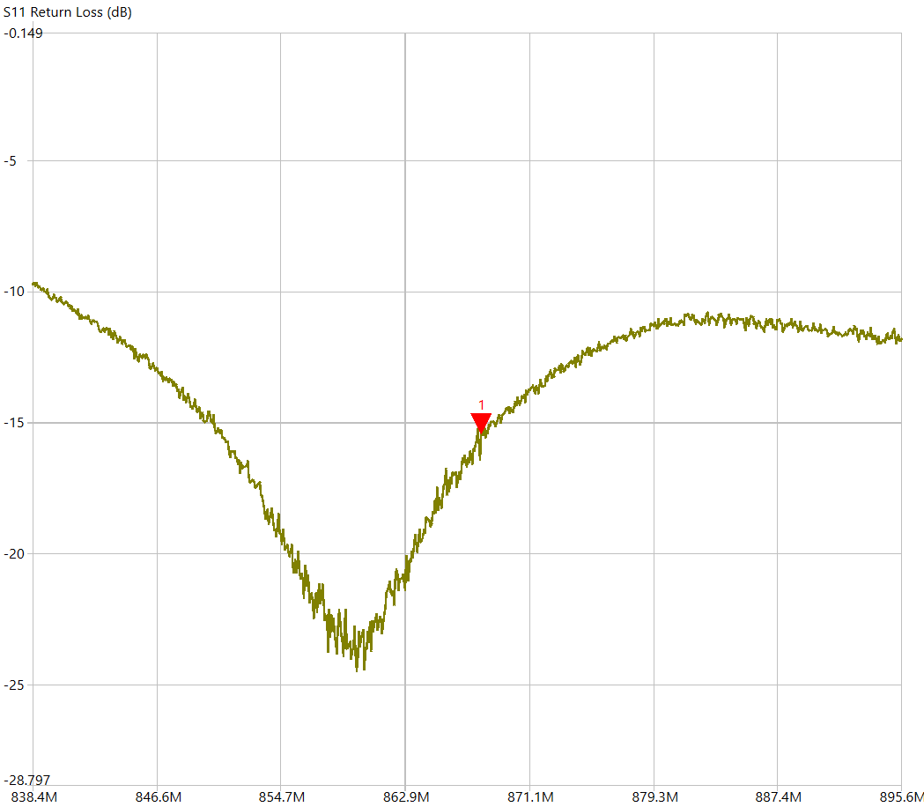
measurements/2025-07-26_filter-balun_pcb-characterisation/carcaterização do PCB/S11 e S21 v4 mais um L de 3.3 em serie Rx.png
