mauroleme/radiation-pattern-measurement-system/measurements/2025-07-26_filter-balun_pcb-characterisation/carcaterização do PCB/smith chart v1 completo.png

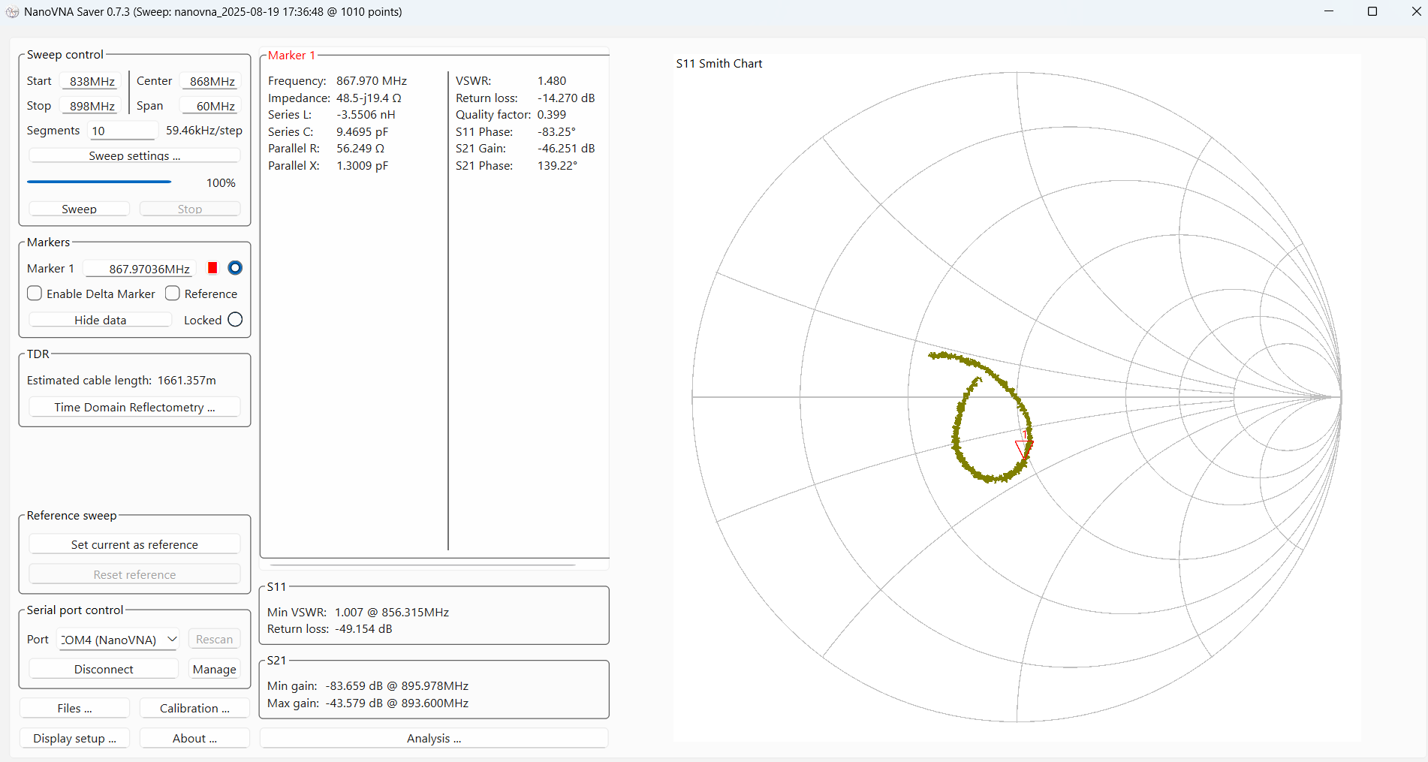
measurements/2025-07-26_filter-balun_pcb-characterisation/carcaterização do PCB/smith chart v1 completo.png
