mauroleme/radiation-pattern-measurement-system/measurements/2025-07-26_filter-balun_pcb-characterisation/com balun e com filtro @868 MHz/décima medição.jpg

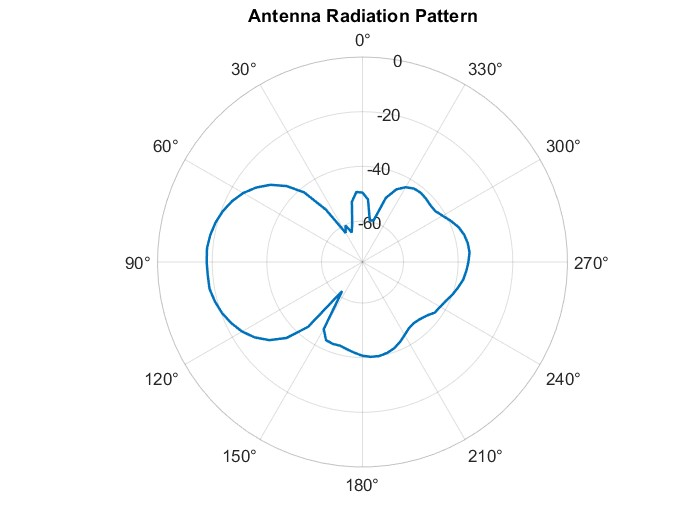
measurements/2025-07-26_filter-balun_pcb-characterisation/com balun e com filtro @868 MHz/décima medição.jpg
