mauroleme/radiation-pattern-measurement-system/measurements/2025-07-26_filter-balun_pcb-characterisation/com balun e com filtro @868 MHz/media_real v2.jpg

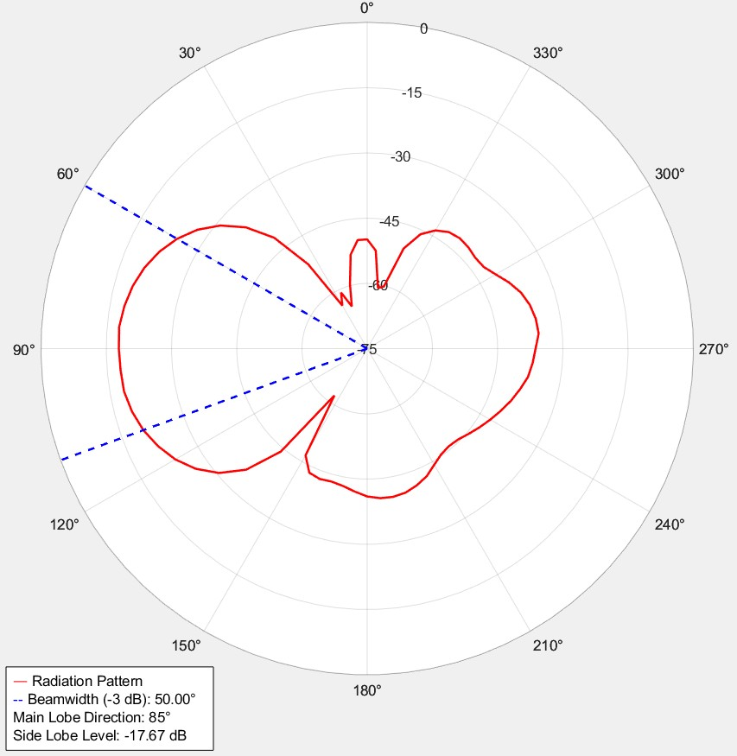
measurements/2025-07-26_filter-balun_pcb-characterisation/com balun e com filtro @868 MHz/media_real v2.jpg
