mauroleme/radiation-pattern-measurement-system/measurements/2025-08-22_full-system_2d-and-3d/Imagens/s6.jpg

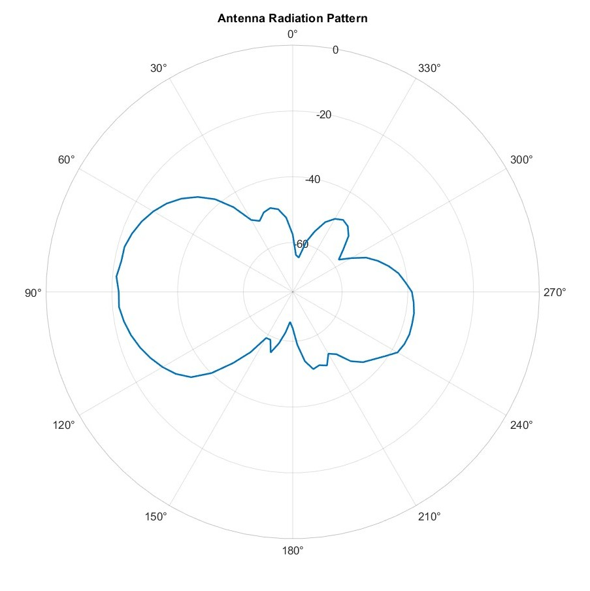
measurements/2025-08-22_full-system_2d-and-3d/Imagens/s6.jpg
