mauroleme/radiation-pattern-measurement-system/measurements/first-measurement_antenna-only-and-with-filter/com filtro/plot da média das 10 medições com legenda v2.jpg

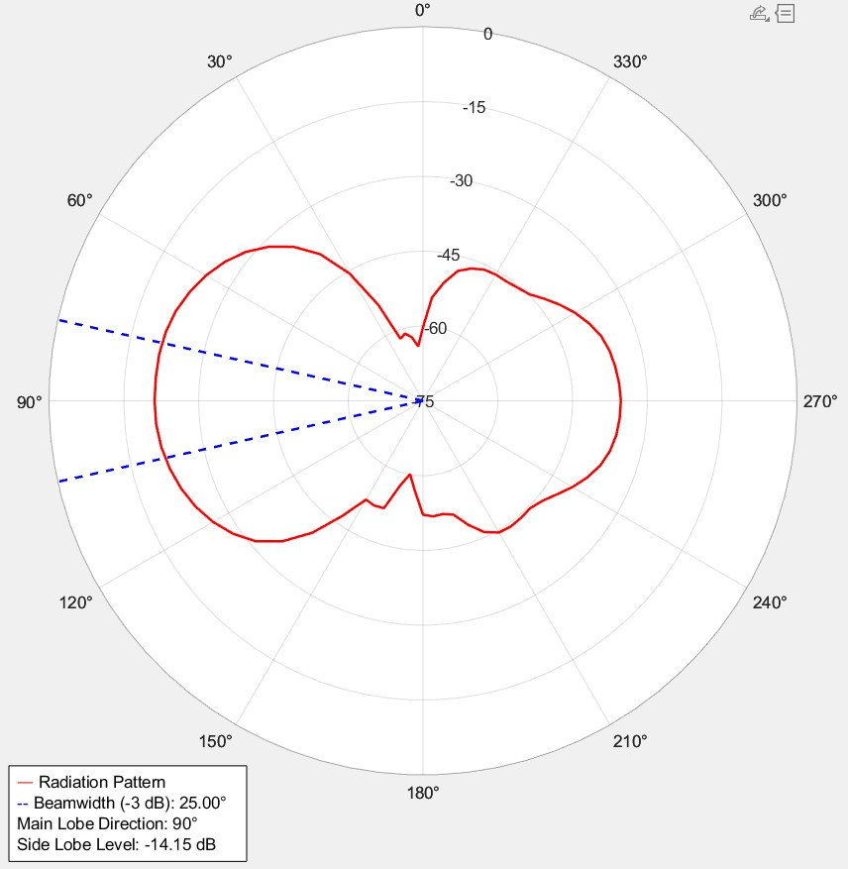
measurements/first-measurement_antenna-only-and-with-filter/com filtro/plot da média das 10 medições com legenda v2.jpg
