mauroleme/radiation-pattern-measurement-system/measurements/first-measurement_antenna-only-and-with-filter/sem filtro/1ª medição.jpg

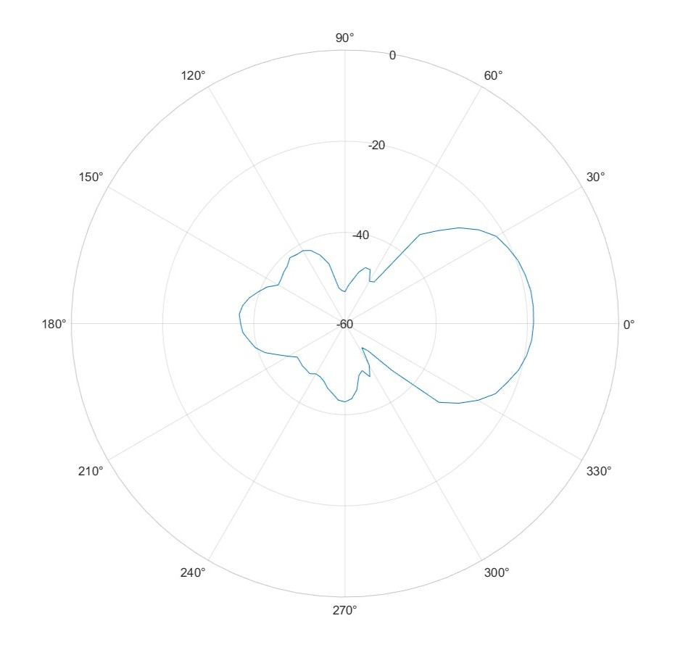
measurements/first-measurement_antenna-only-and-with-filter/sem filtro/1ª medição.jpg
