mauroleme/radiation-pattern-measurement-system/measurements/first-measurement_antenna-only-and-with-filter/sem filtro/plot da média das 10 medições invertido correto.jpg

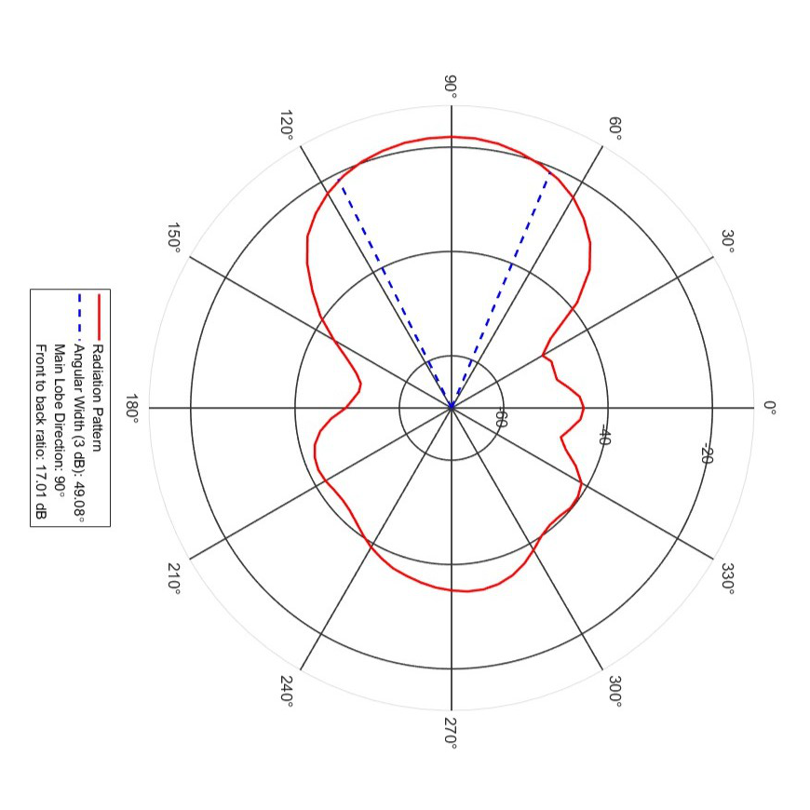
measurements/first-measurement_antenna-only-and-with-filter/sem filtro/plot da média das 10 medições invertido correto.jpg
