mauroleme/radiation-pattern-measurement-system/measurements/oscilloscope/TEK0000.png

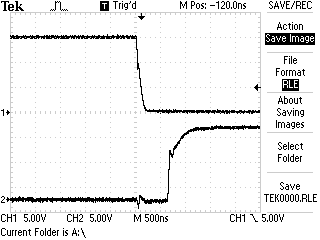
measurements/oscilloscope/TEK0000.png
