mauroleme/radiation-pattern-measurement-system/measurements/oscilloscope/TEK0001.png

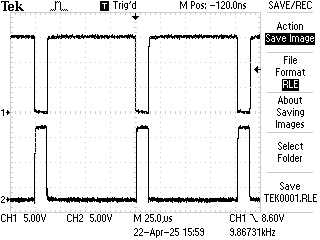
measurements/oscilloscope/TEK0001.png
