mauroleme/radiation-pattern-measurement-system/measurements/oscilloscope/TEK0002.png

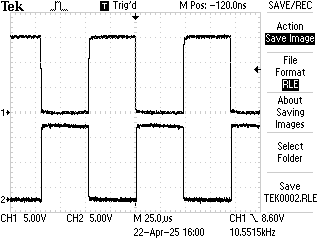
measurements/oscilloscope/TEK0002.png
