mauroleme/radiation-pattern-measurement-system/measurements/oscilloscope/TEK0003.png

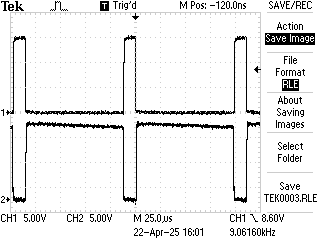
measurements/oscilloscope/TEK0003.png
