mauroleme/radiation-pattern-measurement-system/(commit log)

2026-10-10 Publish the complete project: data, CAD, simulations and docs
    Reorganise the repository and add everything produced during the LEEC
    final project, development phase included:
    - firmware/: moved from src/arduino; early AD8313 test sketches
    - matlab/: acquisition (moved from src/matlab), pattern analysis
    (HPBW/SLL), balun design script, first serial tests
    - python/: coax de-embedding of the antenna S11
    - measurements/: every test campaign (2025-04-23 to 2025-08-22) with
    raw spreadsheets, Touchstone files and plots
    - hardware/: electronics and AD8313 calibration, impedance-matching
    PCB (QucsStudio project + VNA results), balun study and
    characterisation, SAW filter, SolidWorks and STL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
2026-10-10 Add 2D/3D measurement modes, data saving and a simulator
    New MATLAB entry point (matlab/RadiationPatternMeasurement.m) on top of
    a +rpm package:
    - modes "2D" (azimuth cut, as in the report), "3D-slices" (azimuth cut
    + second-axis cut through the main lobe, 3D reconstructed by the
    summing method) and "3D-grid" (axis 2 steps and the azimuth sweep is
    repeated at every step; serpentine rows keep the cable within +/-180)
    - duration estimate from the firmware timing before each scan
    - every scan saved to matlab/results as .mat and .csv
    - pattern metrics with interpolated -3 dB crossings (HPBW, F/B, SLL)
    - rpm.Simulator speaks the Arduino protocol, so the whole chain runs
    without hardware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
2026-10-10 Add early firmware sketches, first project version and Antenna Toolbox studies
    From the Documentos folder: the Nov-Dec 2024 Arduino tests (stepper,
    Hall homing, RF module), the December 2024 first version of the
    project (Arduino Mega, 360x10 acquisition, first monopole test) and the
    March 2025 MATLAB Antenna Toolbox Yagi studies with the pattern-search
    optimisation. MathWorks example files and third-party Arduino libraries
    are left out. Also dates the first measurement campaign to early May
    2025 from a with-filter average saved on 2025-05-03.
2026-10-10 Add commissioning test firmware and MATLAB hardware tests
    firmware/commissioning is a stand-alone sketch (same pins, timing and
    conventions as firmware/main) that reports Hall sensors, step counters
    and raw ADC values. matlab/commissioning runs nine tests against it and
    writes a dated report:
    T01 link/latency, T02 Hall profile per turn, T03 usteps-per-degree
    calibration from two passes over the magnet, T04 backlash + hysteresis,
    T05 homing repeatability, T06 lost steps vs DELTA_T, T07 position held
    with the driver off (MOTOR_SLEEP_TIMEOUT), T08 AD8313 ADC->dBm fit with
    firmware constants, T09 RF stability.
    SimulatedRig models the platform with faults injected on purpose; the
    full suite was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
2026-10-10 Update Arduino model in hardware section
